Atif6894/automotive-ble-can-pcb/images/pcb_3d_iso.png

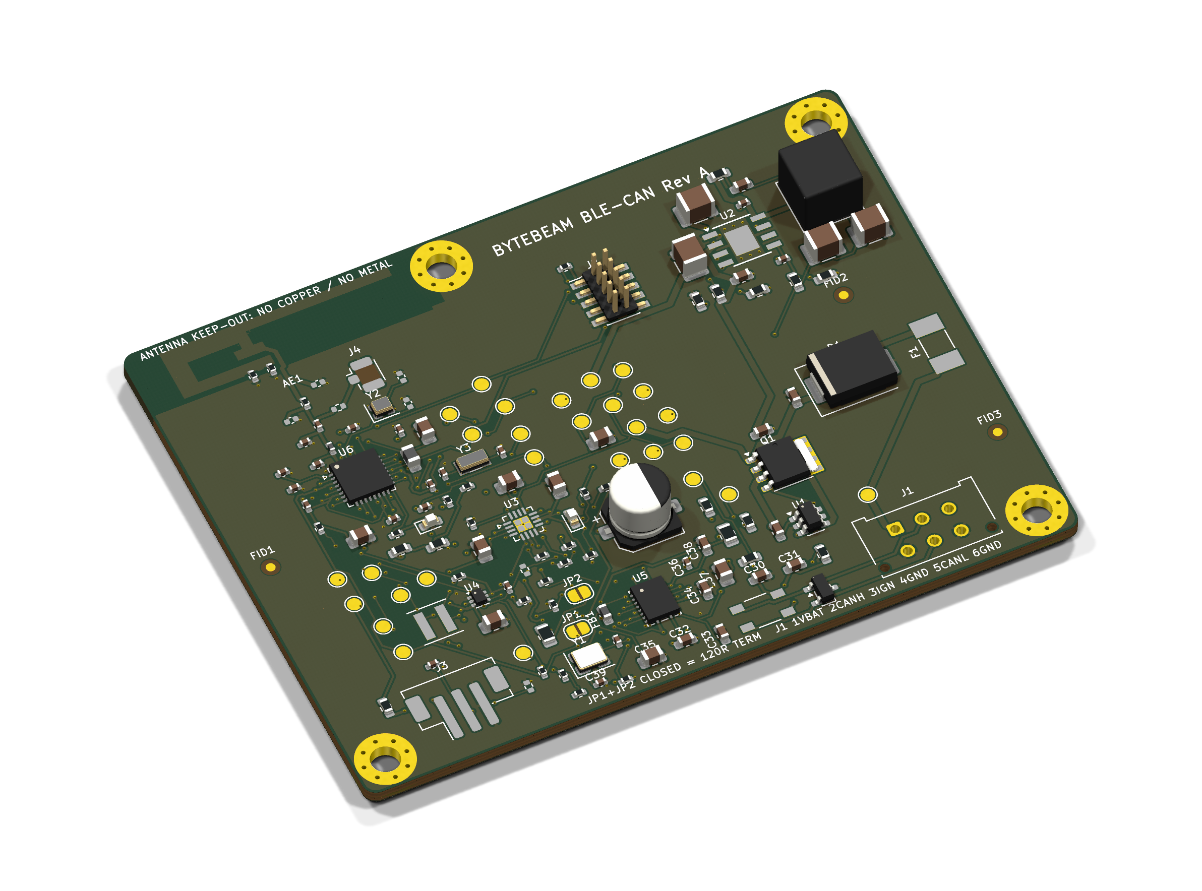
images/pcb_3d_iso.png
