Atif6894/automotive-ble-can-pcb/images/pcb_layout_all_layers.png

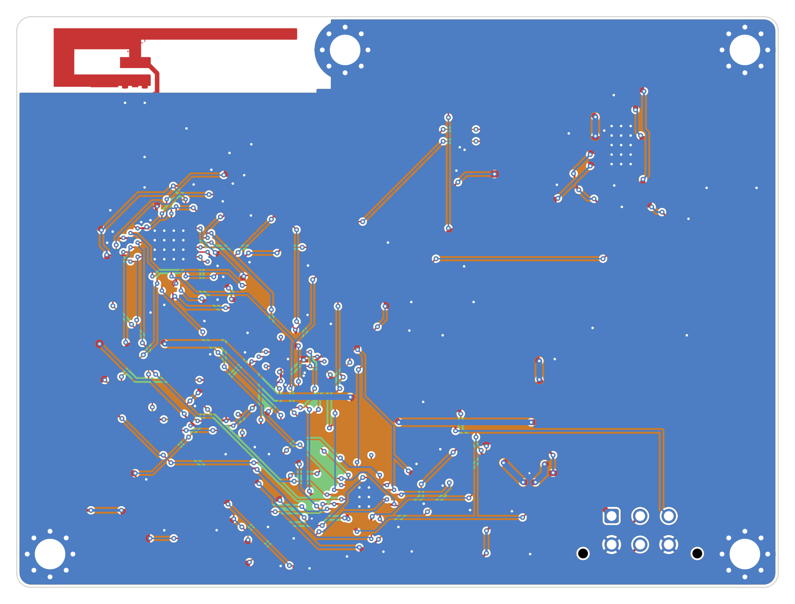
images/pcb_layout_all_layers.png
