Atif6894/automotive-ble-can-pcb/images/schematic_buck_6v0.png

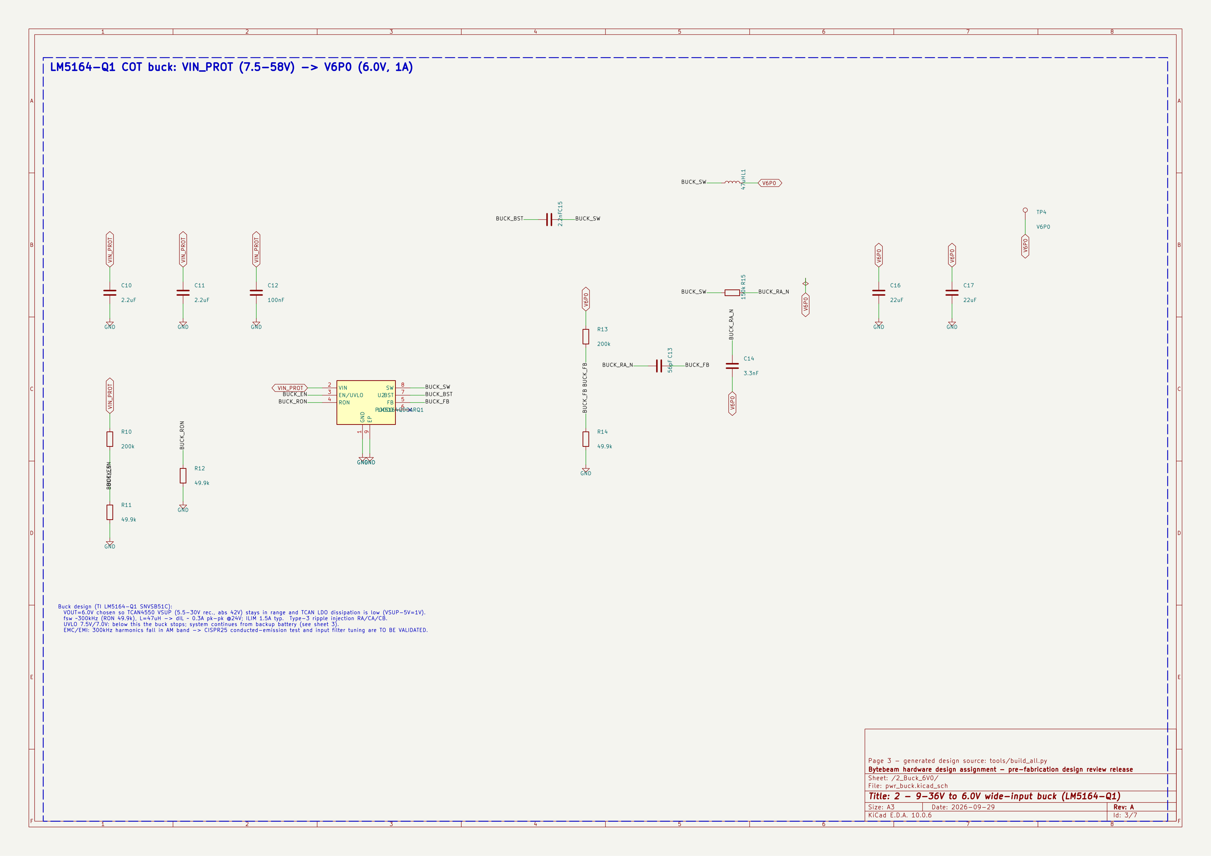
images/schematic_buck_6v0.png
