Atif6894/automotive-ble-can-pcb/images/schematic_power_input.png

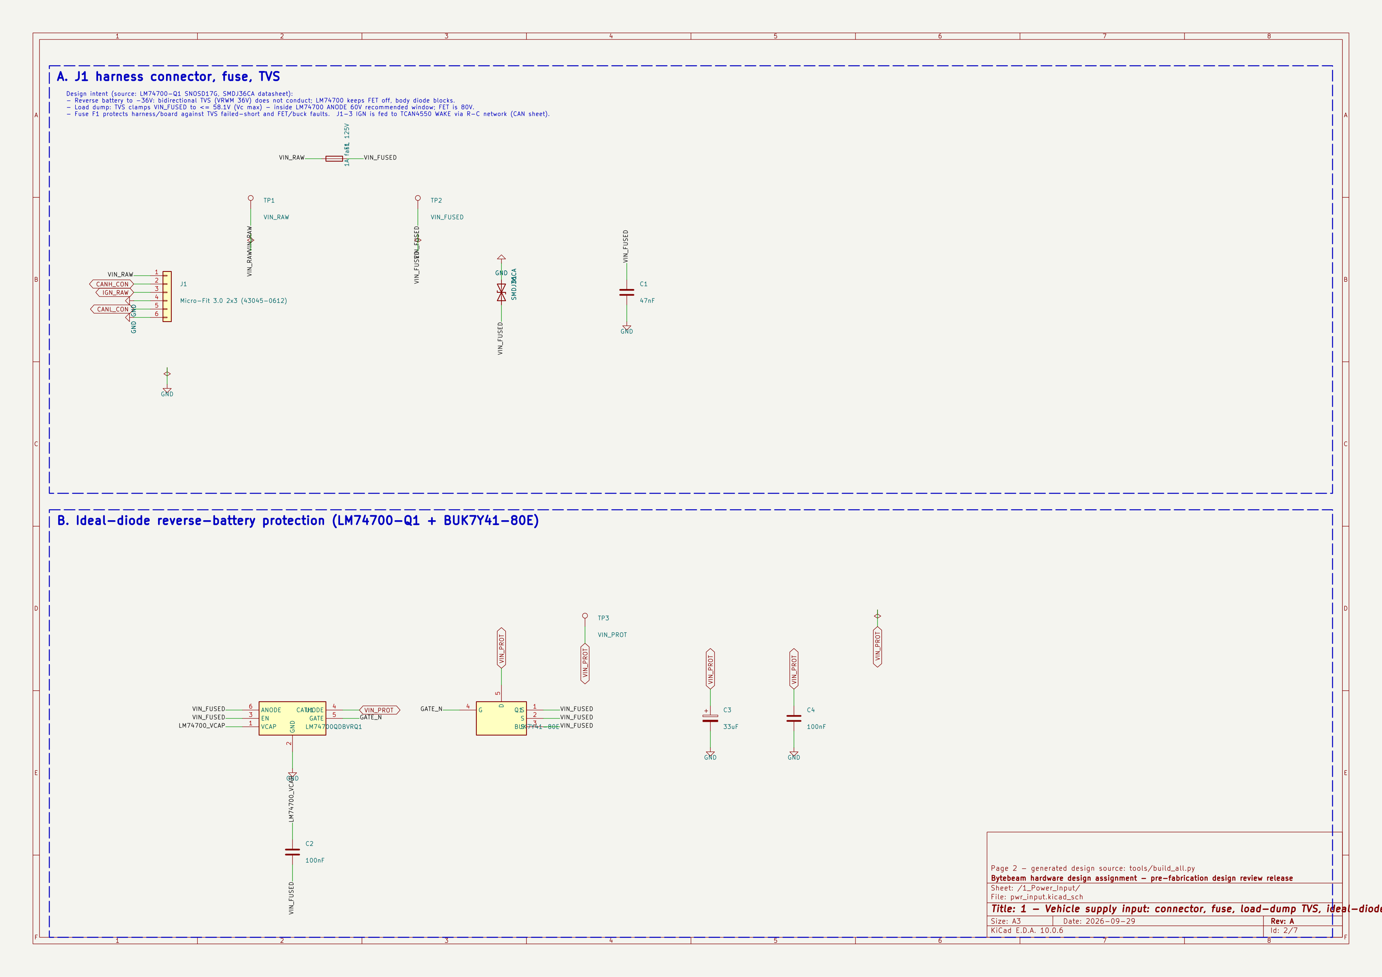
images/schematic_power_input.png
