Atif6894/automotive-ble-can-pcb/images/schematic_root_overview.png

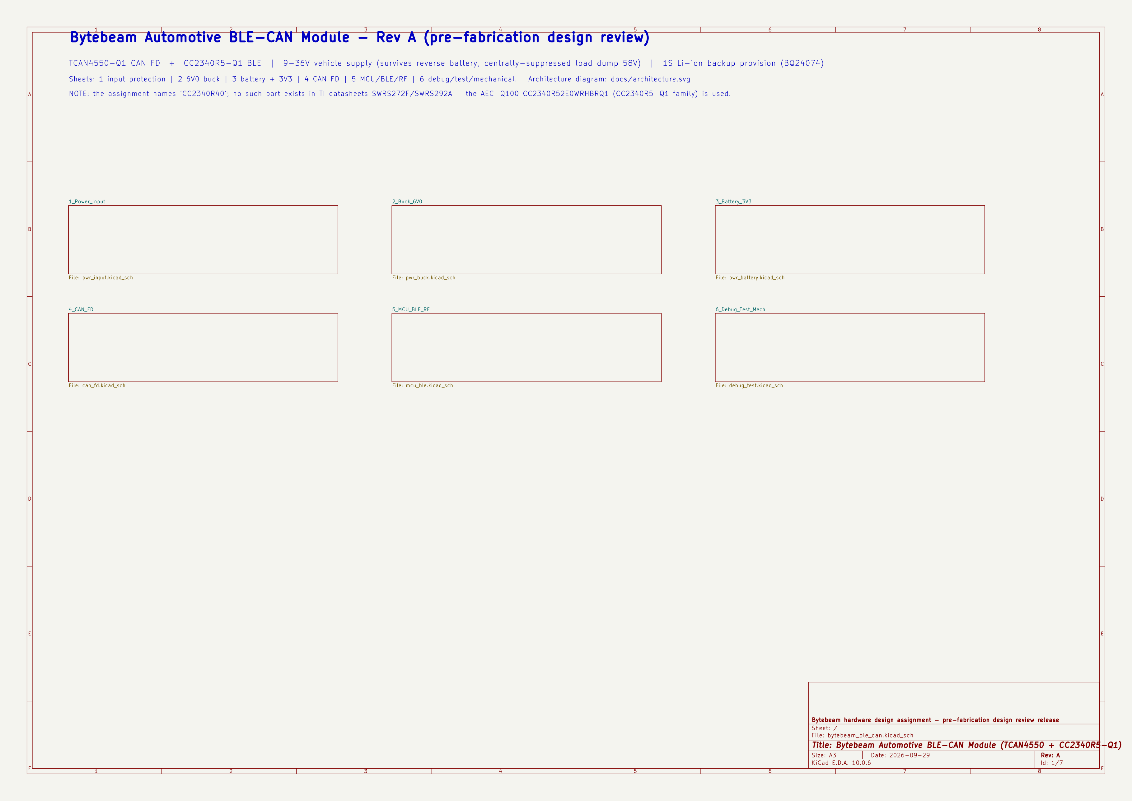
images/schematic_root_overview.png
