Atif6894/automotive-ble-can-pcb/documentation/DFMEA.csv

ID | Area | Item / function | Failure mode | Effect | Cause | S | O | D | RPN | Design mitigation (schematic / layout) | Detection / test | Residual risk & action before fab
F02 | Electrical | D1 TVS / VIN_FUSED | Input over-voltage: load dump above TVS clamp (unsuppressed 24 V systems 151-202 V) | TVS fails short -> fuse opens (safe) or FET/buck destroyed | Assumption 'centrally suppressed load dump 58 V' violated | 9 | 4 | 5 | 180 | TVS Vc 58.1 V @51.6 A inside LM74700 60 V rec./65 V abs window; FET 80 V; LM5164 100 V; fuse F1 clears TVS short | ISO 16750-2 load dump test A/B; TVS temperature rise | MEDIUM. Local TVS cannot absorb unsuppressed 24 V load dump; requires vehicle central suppressor or larger TVS (e.g. SM8S36A) - documented assumption
F19 | RF | AE1 IFA antenna | BLE range loss (detuning, wrong ground/feed geometry) | Reduced range/PER at edge of cell | Plastic housing / metal nearby, PCB stackup differs from TI 1 mm 2-layer ref | 6 | 6 | 5 | 180 | TI SWRU120D geometry copied; ground/copper keepout 31 x 8 mm on all layers; pi-match footprints (ANT1-3) and 2 shorting-tab links R67/R68; 50 ohm 0.35 mm feed | VNA S11 in enclosure, OTA range test, TRP/TIS | HIGH until measured: RF network values are TI reference starting points and topology is UNVERIFIED
F32 | Field | EMC | Conducted emission from 300 kHz buck (AM band) above CISPR 25 limits | EMC failure | Switching harmonics, input filtering minimal | 6 | 5 | 6 | 180 | Small hot loop, input caps at VIN pin, GND plane L2; footprint space for extra input filter (not populated) | CISPR 25 conducted/radiated | HIGH until tested: add LC/CM input filter if needed
F08 | Electrical | U3 BQ24074 / J3 | Battery leakage / deep discharge while vehicle off | Backup capacity lost; cell damage | Standby drain from 3V3 buck + MCU + TCAN in reset; no cut-off | 6 | 5 | 5 | 150 | Pack has PCM (UVLO); MCU can enter shutdown; TCAN held in RST; ITERM/TMR defaults | Measure sleep current on battery (target < 20 uA MCU + < 40 uA rails) | MEDIUM: quiescent budget unmeasured (calculated only). Consider battery disconnect FET
F20 | RF | RF LPF / harmonics | Spurious emissions / harmonic (3rd) above limit | Regulatory failure (ETSI/FCC) | Filter values or layout deviate from reference; no RF shield | 6 | 4 | 6 | 144 | LPF footprint, keep-out around RF, solid GND on L2; option to add shield footprint (not implemented) | Conducted + radiated test at accredited lab | MEDIUM: no compliance claimed. Shield footprint not provided
F31 | Field | Antenna / enclosure | Metal or battery close to IFA (enclosure) detunes antenna | Range loss | Enclosure assumptions violated (needs >5 mm clearance, plastic) | 5 | 5 | 5 | 125 | Enclosure assumption documented in README; battery mounted away from antenna region | OTA test in final enclosure | Medium
F06 | Thermal | U2 LM5164-Q1 | Regulator thermal stress at 36-58 V / 125 C ambient | Thermal shutdown, reduced life | Ploss ~0.25 W (est.), RthJA 43 C/W + copper | 6 | 4 | 5 | 120 | Thermal pad with 4-via array to GND planes, load << 1 A rating; Tj limit 150 C | IR camera / thermocouple at 85 C, 36 V, full load; TJ calc in POWER_BUDGET | Medium: thermal performance calculated only (not simulated/measured)
F09 | Electrical | U3 BQ24074 charging | Improper charging outside temperature window / wrong chemistry | Cell venting, fire | NTC missing/wrong pack; LiFePO4 pack fitted; hot cabin >45 C | 10 | 3 | 4 | 120 | TS pin monitors pack NTC (10k 103AT-2); charge current limited 100 mA; safety timers on; keyed JST PH; R28 (10k) DNP unless no-NTC pack | Bench: cold/hot chamber with pack simulator, TS thresholds | MEDIUM: pack chemistry restricted to 1S Li-ion 4.2 V; charging must not be used <0 C or >45 C without validation
F13 | CAN | CAN bus open / termination | Open bus, missing or double termination | Signal reflections, CAN FD errors at 5 Mbps | Node used as bus tap but JP1/JP2 closed (or end-node open) | 6 | 5 | 4 | 120 | Termination optional by solder jumpers JP1/JP2 (default open); split termination for CM noise; stub length < 30 cm assumed | Bus impedance measurement 60 R, eye diagram | Medium: documented default 'tap node' - user must set jumpers per installation
F05 | Electrical | U2 LM5164-Q1 buck | Input under-voltage during crank (<7 V) -> converter stops | V6P0 collapses; CAN goes off, MCU continues on battery | 12 V crank down to 3-6 V (ISO 16750-2 starting profile) | 5 | 7 | 3 | 105 | EN/UVLO 7.5/7.0 V by R10/R11; BQ24074 seamless OUT switch to battery; bulk 33 uF | Starting profile test, log CAN bus-off events | Accepted behaviour; firmware must handle CAN re-init after brown-out
F26 | Mechanical | PCB / assembly | Solder-joint fatigue (thermal cycling -40..85 C, vibration) | Intermittent failures | Large 1210 MLCCs and SMC TVS, CTE mismatch | 7 | 3 | 5 | 105 | Standard 1.6 mm FR-4; MLCC orientation/fillets; consider flexible-termination caps | Thermal-cycling and vibration test (ISO 16750-3/4) | Medium: not tested
F33 | Field | Firmware | CAN traffic overload / watchdog | Missed frames | SPI latency vs BLE stack | 5 | 4 | 5 | 100 | TCAN M_CAN FIFO + nINT; RST/GPO watchdog options | Load test | Low
F03 | Electrical | F1 fuse | Fuse nuisance-opens at cold crank / TVS conduction, or fails to protect | Loss of function / no protection | I2t mismatch vs 58 V TVS surge; 125 V rating OK | 6 | 4 | 4 | 96 | 1 A very-fast NANO2 with 300 mA typ load (<25% derating at 85C); footprint allows 2 A option | Inrush/surge test | Medium: fuse selection non-AEC-Q200 in BOM; confirm AEC-Q200 fuse family
F10 | Electrical | J3 battery connector | Wrong battery insertion (reversed / wrong pack voltage) | Reverse voltage on BAT pin -> charger damage | Non-keyed alternative connector used | 8 | 3 | 4 | 96 | Keyed JST PH pins 1/2/3 (BAT+/NTC/GND) fixed pinout | Assembly/inspection instruction | Medium: no reverse-protection FET on BAT (cost/space) - add if pack polarity cannot be guaranteed
F12 | CAN | J1 CAN bus pins | CAN bus short to battery / ground / other line | Transceiver damage or bus-off | Harness fault | 8 | 4 | 3 | 96 | TCAN4550 bus pins +/-58 V rated with fault protection; PESD2CAN + ACT45B at connector; series link R40/R41 | Short-circuit test per ISO 11898-2 / ISO 16750-2 | Low-Medium; transient tests to be performed
F14 | CAN | ESD/EMC | ESD damage / immunity failure at connector (8 kV contact, 15 kV air) | Bus transceiver latch-up / error bursts | Discharge to shield/CAN pins | 8 | 3 | 4 | 96 | TCAN HBM 15 kV bus pins; external PESD2CAN (30 kV) first at connector, CMC second; ground pour and short return | IEC 61000-4-2 / ISO 10605 test | Low-Medium; not yet tested
F27 | Manufacturing | QFN/SOT/0402 assembly | Poor solderability / tombstoning / voiding under thermal pads | Open joints, poor thermal path | 0402 with unequal pads, EP paste coverage | 6 | 4 | 4 | 96 | Stock IPC footprints; EP via array (0.3 mm) should be plugged/tented; fiducials FID1-3 | AOI + X-ray on U2/U5/U6 | Medium: via-in-pad plugging to be specified to assembler
F17 | CAN | nWKRQ default 3.6 V push-pull | Over-voltage on MCU DIO19 (VDDS+0.3 V max) | MCU pin stress | TCAN nWKRQ defaults to internal 3.6 V rail | 5 | 6 | 3 | 90 | R48 1 k series resistor; firmware sets 16'h0800[19]=1 to VIO domain at boot | Measure nWKRQ level after reset | Low; firmware dependency documented
F25 | Mechanical | J1 connector | Wrong connector insertion / mis-mating / vibration fretting | Shorted harness or open circuit | Non-keyed mate, cable strain | 7 | 3 | 4 | 84 | Micro-Fit polarised housing; pin pairing keeps VBAT/GND adjacent; mounting holes near connector | Insertion test, vibration | Medium: automotive-grade connector (MX150/MQS) recommended for production
F01 | Electrical | J1 VBAT input | Reverse battery connection (12 V system: -14 V, jump-start swap; 24 V: -28 V) | Reverse current destroys regulators / harness fire | Harness miswire, jump-start error | 9 | 3 | 3 | 81 | SMDJ36CA bidirectional TVS does not conduct to -36 V; LM74700-Q1 keeps BUK7Y41-80E off (body diode blocks); fuse F1 upstream | Bench: apply -36 V current-limited, verify <1 mA reverse | Low. Validate ISO 7637 pulse 1 and reverse-battery test (ISO 16750-2 4.7) - NOT yet performed
F11 | Electrical | U4 TPS62A01-Q1 | 3V3 rail droops / regulator drop-out at low battery | MCU brown-out reset; TCAN VIO below 3.135 V | Battery <3.4 V (100% mode) | 4 | 5 | 4 | 80 | TCAN kept in reset when VBATSYS<3.4 V (firmware), VDDS range 1.71-3.8 V | Discharge ramp test | Low
F16 | CAN | SPI link MCU-TCAN | SPI signal-integrity errors (8 MHz+, ringing) | SPIERR flags, lost CAN frames | Long/unmatched routing, no series R | 5 | 4 | 4 | 80 | Short routes, common 3.3 V domain (no level shifter), spare series-R option (0R footprints not fitted) | SPI loopback test, error counters | Low
F15 | CAN | U5 40 MHz clock (Y1) | Crystal fails to start / wrong load capacitance | No CAN clock; SPI ok but no bus activity | CL/ESR mismatch; R52 series value assumed | 6 | 4 | 3 | 72 | ESR <=60 R crystal spec; 12 pF C0G load caps and 100 R series R52 footprints tunable; clock tolerance 0.5 % allowed by TCAN | Read TCAN DEVICE ID + CLK status register at bring-up, scope OSC | Medium: values ASSUMED (TI 'TCAN455x clock guideline' not obtained)
F04 | Electrical | U1/Q1 ideal diode | Gate over-voltage or FET failed short (no reverse block) | Reverse polarity not blocked | LM74700 GATE-ANODE >15 V, FET VGS rating | 8 | 2 | 4 | 64 | Standard-level FET (VGS +/-20 V) chosen over logic-level (VGS 10 V) - BUK7Y41-80E; VCAP cap per datasheet | Reverse-battery test, gate waveform | Low
F21 | RF | U6 48 MHz crystal (Y2) | HFXT start-up failure / frequency error | No radio operation / BLE PER | Wrong package footprint (2016 assumed), load cap array | 7 | 3 | 3 | 63 | Tai-Saw TZ3908AAAO43 validated by TI, internal cap array, DNP C59/C60 for tuning | HFXT frequency measurement via DIO19 clock-out (SWRA834A 6.4) | Medium: crystal package dimension to confirm with vendor drawing
F24 | Digital | U6 boot/firmware | Firmware/bootloader locks debug or wrong SPI mux | Cannot access TCAN | SPI0 mux (SCLK m1, CSN m1, POCI m1, PICO m2) misconfigured | 5 | 4 | 3 | 60 | Pin mux table on schematic notes; ROM bootloader UART pins intentionally unused (SWD is the programming path) | Bring-up SPI ID read | Low
F28 | Manufacturing | TVS/big parts | Tombstone / misplacement due to oversize footprints (SMC, XGL6060) | Assembly reject | Land pattern mismatch (XGL6060 uses XAL6060 footprint) | 5 | 4 | 3 | 60 | Vendor land patterns to be verified before release | First-article inspection | Low-Medium
F07 | Electrical | L1 47 uH | Inductor saturation at cold/hot or current-limit event | Peak current -> converter fault / EMI | Isat 2.5 A (20% drop) vs ILIM 1.75 A max | 6 | 2 | 4 | 48 | XGL6060-473MEC AEC-Q200, Isat margin >40% vs IPEAK max | Scope inductor current at ILIM | Low; land pattern shared with XAL6060 must be verified
F29 | Manufacturing | Test coverage | Insufficient test points for bring-up / production test | Cannot isolate faults | Dense layout | 4 | 4 | 3 | 48 | 28 TPs on rails, CAN, SPI, RST, SWD; two PCB antenna test links | ICT/flying probe | Low
F22 | RF | U6 32 kHz crystal (Y3) | LFXT failure | BLE connection timing drift / disconnects | Load caps / parasitics | 4 | 3 | 3 | 36 | 15 pF + 15 pF per TI reference; RCOSC fallback in firmware | Output 32 kHz to DIO (SWRA834A 6.3) | Low
F23 | Digital | U6 debug/bring-up | SWD access blocked (pin reuse, RSTN pull-up), or bricked device | Cannot program | DIO16/17 are SWD by default; CCFG misconfig | 6 | 3 | 2 | 36 | J2 Cortex-Debug 10-pin, dedicated SWDIO/SWDCK, RSTN pulled up 100 k, test pads TP15-TP19 | Bring-up step 3 | Low
F30 | Thermal | U5 TCAN4550 | Thermal shutdown with VCCOUT loaded (TCAN datasheet Fig 9-8) | CAN transceiver off | High VSUP with 70 mA load at 125 C | 6 | 2 | 3 | 36 | VSUP fed from 6.0 V (1 V LDO drop), VCCOUT unloaded (10 uF only) | Thermal test | Low
F18 | CAN | TCAN RST active-high | MCU leaves RST floating/high at boot -> TCAN held in reset | No CAN after power-up | Confusing polarity (active-HIGH pulse) | 4 | 4 | 2 | 32 | R47 100 k pull-down + MCU-controlled DIO18; polarity noted on schematic | Bring-up checklist | Low
