Atif6894/automotive-ble-can-pcb/manufacturing/assembly_outputs/bytebeam.step

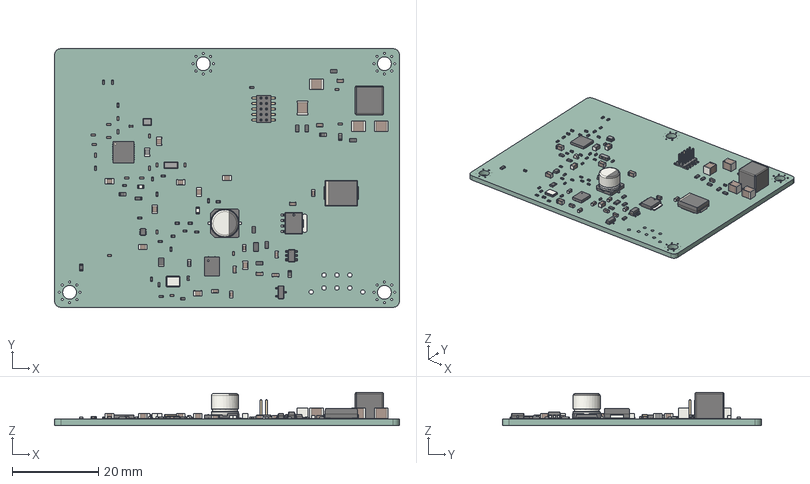
[picture p18: CAD file, 2026-10-08]
manufacturing/assembly_outputs/bytebeam.step
80.0 x 60.0 x 7.70 mm
C_0603_1608Metric x 11
R_0402_1005Metric x 23
CP_Elec_63x58
43e594cd-ed20-11ed-b06b-f76ff2fea4fd_part
43e594ce-ed20-11ed-b06b-f76ff2fea4fd_part
43e594cf-ed20-11ed-b06b-f76ff2fea4fd_part
C_0402_1005Metric x 20
C_0805_2012Metric x 9
R_0603_1608Metric x 13
Crystal_SMD_3215-2Pin_3.2x1.5mm
R_0805_2012Metric x 2
SOT-23
SOT-23-6
L_0603_1608Metric
LED_0603_1608Metric x 2
L_Coilcraft_XAL6060-XXX
D_SMC
Crystal_SMD_2016-4Pin_2.0x1.6mm
PinHeader_2x05_P127mm_Vertical_SMD
SOT_563
L_0402_1005Metric
C_1210_3225Metric x 4
adbeea53-9c39-11ed-93f0-dde97e994e83_part
adbeea54-9c39-11ed-93f0-dde97e994e83_part
adbeea55-9c39-11ed-93f0-dde97e994e83_part
L_0805_2012Metric
Crystal_SMD_3225-4Pin_3.2x2.5mm
QFN-32-1EP_5x5mm_P0.5mm_EP3.7x3.7mm
bytebeam_ble_can_PCB
