Atif6894/automotive-ble-can-pcb/documentation/architecture.pdf

# Bytebeam Automotive BLE-CAN Module - Architecture (Rev A, pre-fabrication review)

## J1 harness

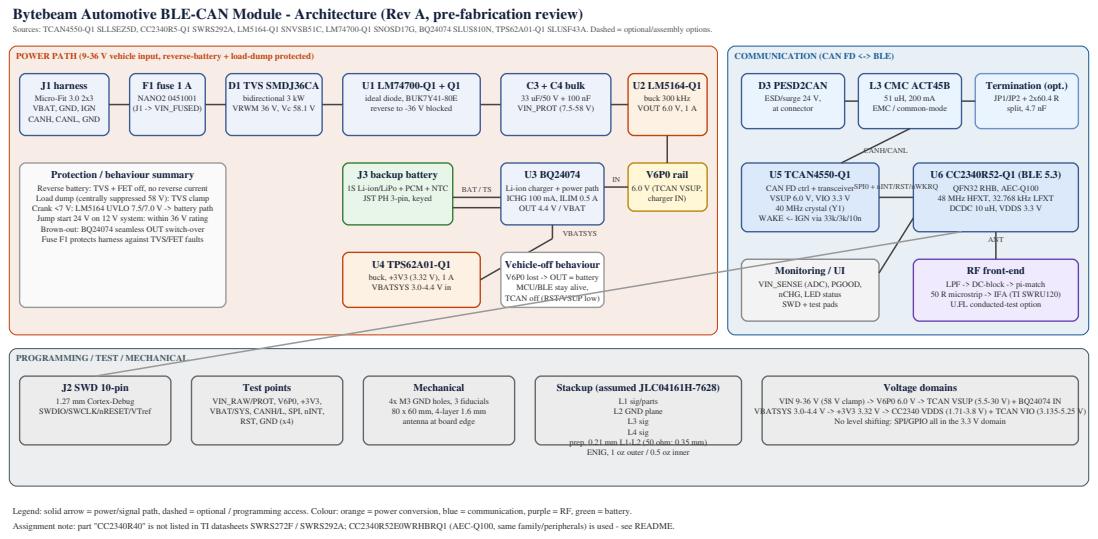
[picture p19: page 1]

Sources: TCAN4550-Q1 SLLSEZ5D, CC2340R5-Q1 SWRS292A, LM5164-Q1 SNVSB51C, LM74700-Q1 SNOSD17G, BQ24074 SLUS810N, TPS62A01-Q1 SLUSF43A. Dashed = optional/assembly options.

POWER PATH (9-36 V vehicle input, reverse-battery + load-dump protected)

COMMUNICATION (CAN FD <-> BLE)

Protection / behaviour summary
Reverse battery: TVS + FET off, no reverse current
Load dump (centrally suppressed 58 V): TVS clamp
Crank <7 V: LM5164 UVLO 7.5/7.0 V -> battery path
Jump start 24 V on 12 V system: within 36 V rating
Brown-out: BQ24074 seamless OUT switch-over
Fuse F1 protects harness against TVS/FET faults

IN J3 backup battery
1S Li-ion/LiPo + PCM + NTC
JST PH 3-pin, keyed

Li-ion charger + power path
ICHG 100 mA, ILIM 0.5 A
OUT 4.4 V / VBAT

U5 TCAN4550-Q1
CAN FD ctrl + transceiver
VSUP 6.0 V, VIO 3.3 V
40 MHz crystal (Y1)
WAKE <- IGN via 33k/3k/10n

U6 CC2340R52-Q1 (BLE 5.3)
QFN32 RHB, AEC-Q100
48 MHz HFXT, 32.768 kHz LFXT
DCDC 10 uH, VDDS 3.3 V

Vehicle-off behaviour
V6P0 lost -> OUT = battery
MCU/BLE stay alive,
TCAN off (RST/VSUP low)

RF front-end
LPF -> DC-block -> pi-match
50 R microstrip -> IFA (TI SWRU120)
U.FL conducted-test option

J2 SWD 10-pin
1.27 mm Cortex-Debug
SWDIO/SWCLK/nRESET/VTref

Test points
VIN_RAW/PROT, V6P0, +3V3,
VBAT/SYS, CANH/L, SPI, nINT,
RST, GND (x4)

Mechanical
4x M3 GND holes, 3 fiducials
80 x 60 mm, 4-layer 1.6 mm
antenna at board edge

VIN 9-36 V (58 V clamp) -> V6P0 6.0 V -> TCAN VSUP (5.5-30 V) + BQ24074 IN
VBATSYS 3.0-4.4 V -> +3V3 3.32 V -> CC2340 VDDS (1.71-3.8 V) + TCAN VIO (3.135-5.25 V)

No level shifting: SPI/GPIO all in the 3.3 V domain

prep. 0.21 mm L1-L2 (50 ohm: 0.35 mm)
ENIG, 1 oz outer / 0.5 oz inner

Legend: solid arrow = power/signal path, dashed = optional / programming access. Colour: orange = power conversion, blue = communication, purple = RF, green = battery.
Assignment note: part "CC2340R40" is not listed in TI datasheets SWRS272F / SWRS292A; CC2340R52E0WRHBRQ1 (AEC-Q100, same family/peripherals) is used - see README.
