Atif6894/automotive-ble-can-pcb/schematic/schematic.pdf

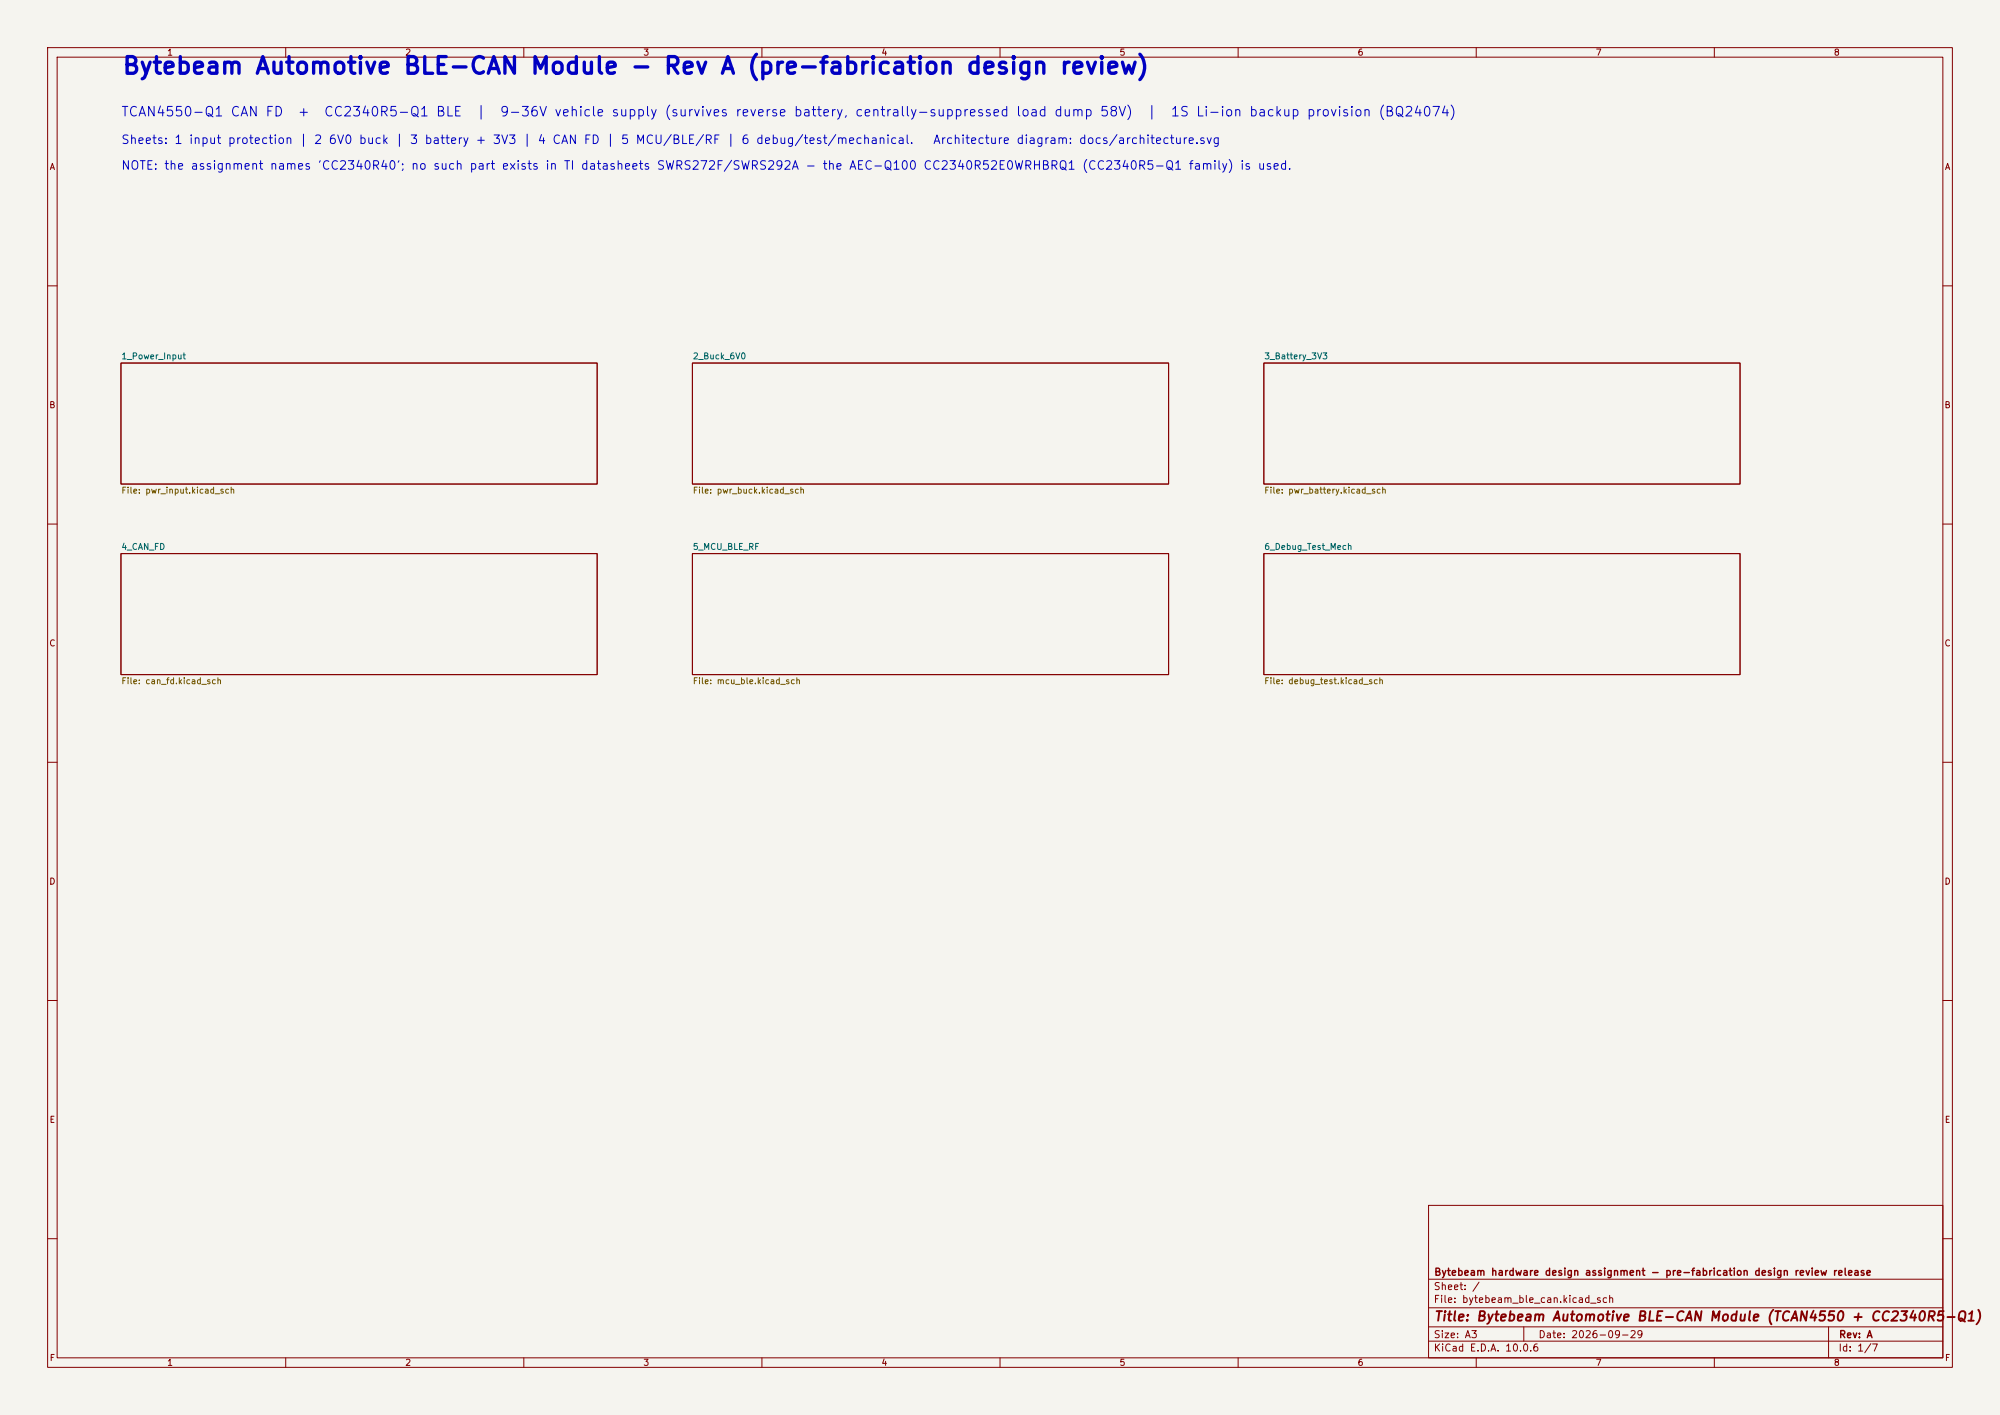
[picture p20: page 1]

File: can_fd.kicad_sch Bytebeam Automotive BLE-CAN Module - Rev A (pre-fabrication design review)

TCAN4550-Q1 CAN FD + CC2340R5-Q1 BLE | 9-36V vehicle supply (survives reverse battery, centrally-suppressed load dump 58V) | 1S Li-ion backup provision (BQ24074)

NOTE: the assignment names 'CC2340R40'; no such part exists in TI datasheets SWRS272F/SWRS292A - the AEC-Q100 CC2340R52E0WRHBRQ1 (CC2340R5-Q1 family) is used.

Bytebeam hardware design assignment - pre-fabrication design review release
Sheet: /
File: bytebeam_ble_can.kicad_sch
Title: Bytebeam Automotive BLE-CAN Module (TCAN4550 + CC2340R5-Q1)

Size: A3 | Rev: A | F Date: 2026-09-29
KiCad E.D.A. 10.0.6 | Id: 1/7

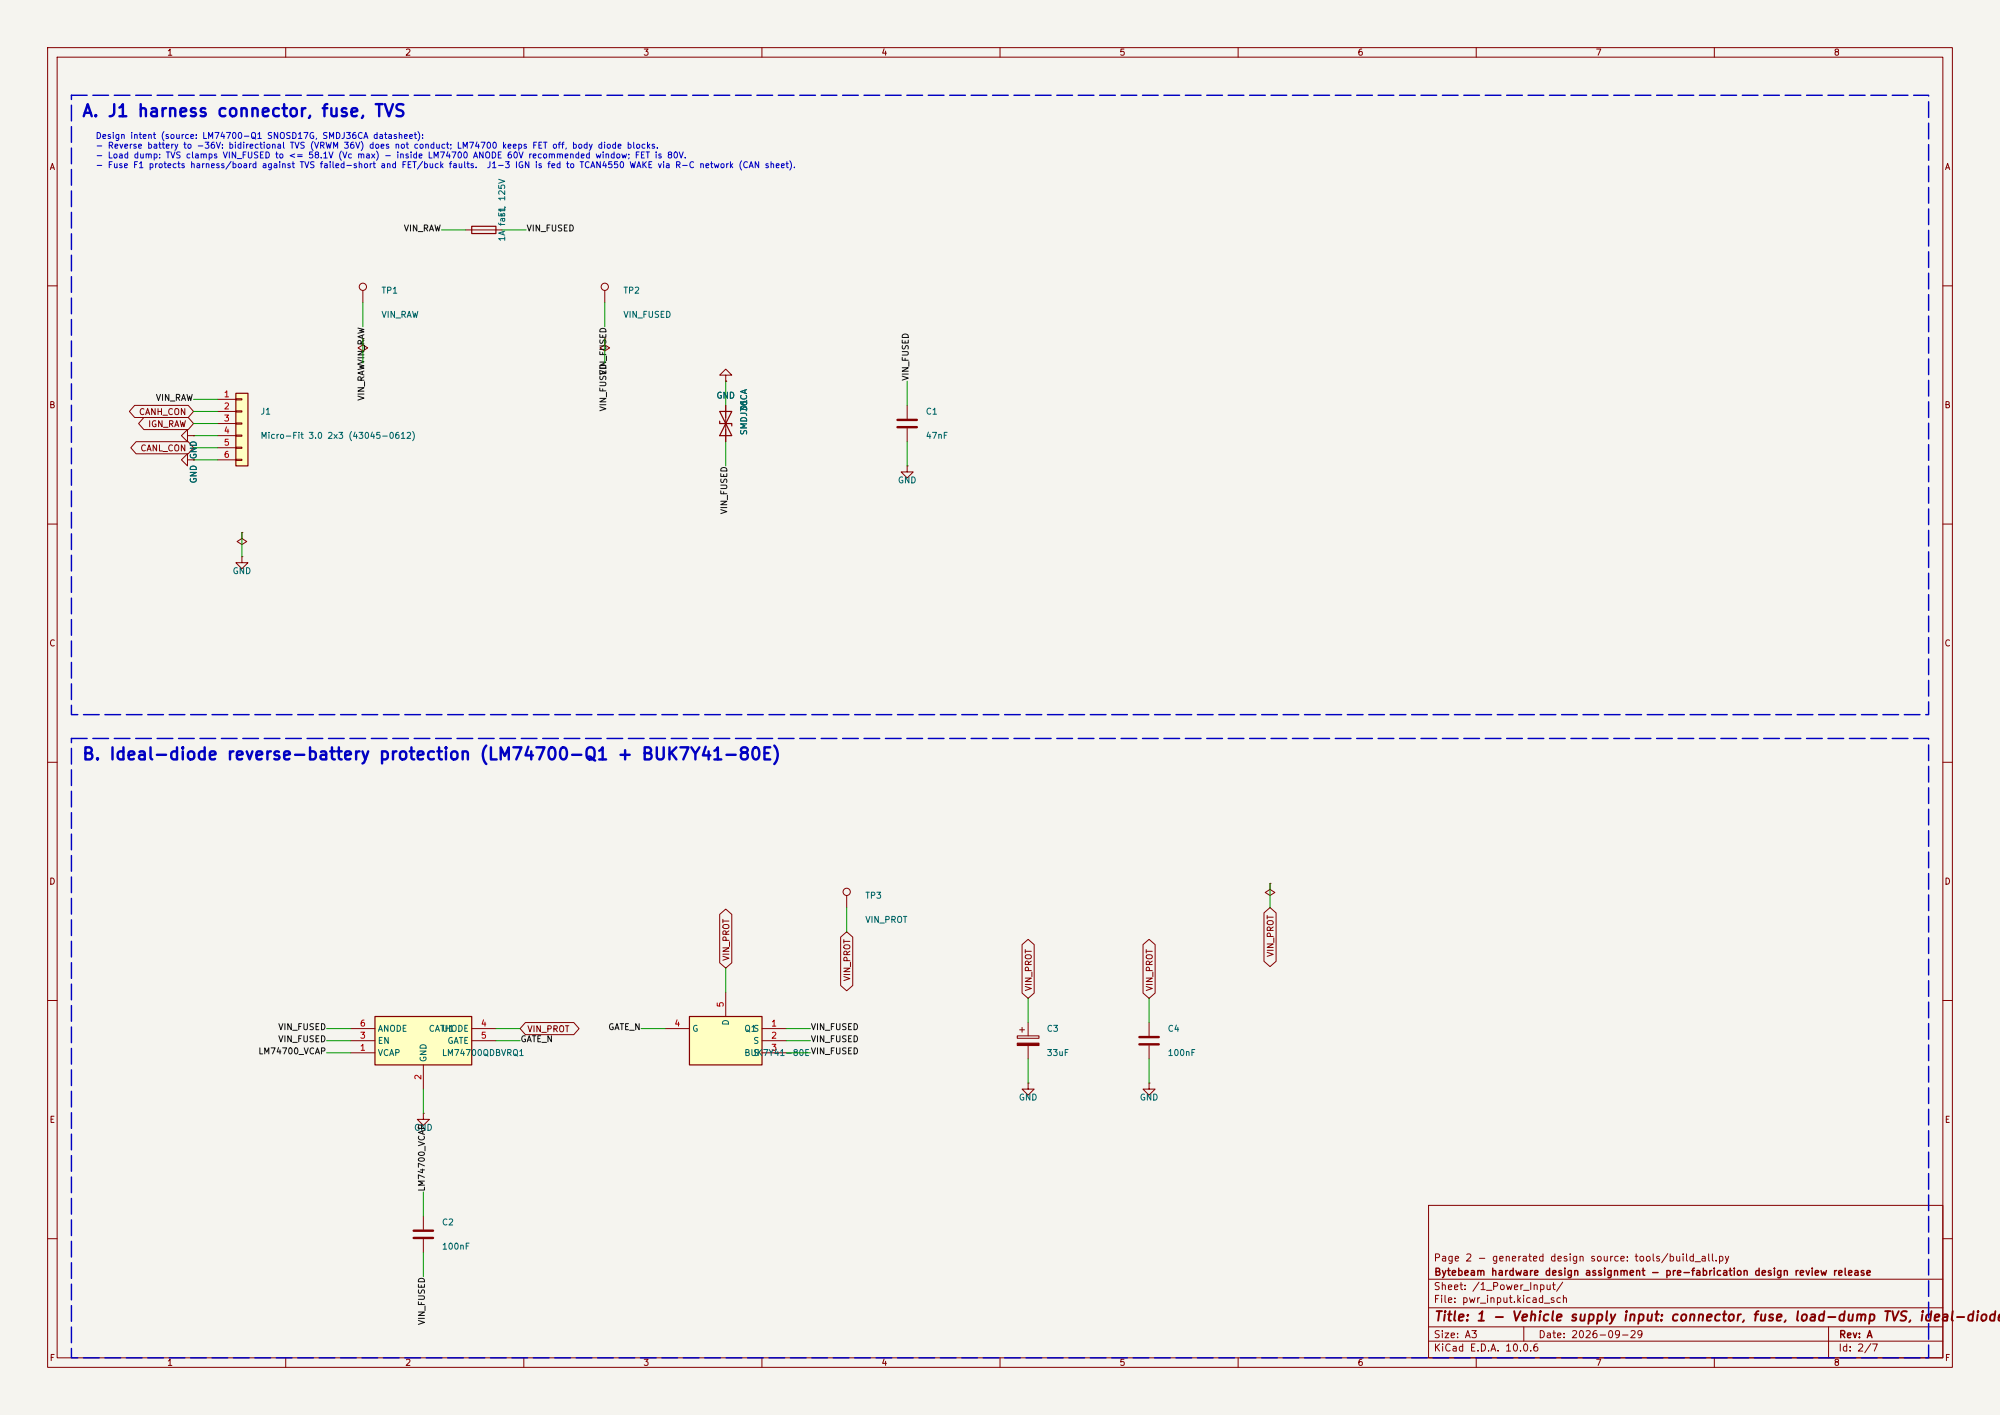
[picture p21: page 2]

A. J1 harness connector, fuse, TVS
VIN_FUSED
GND

Page 2 - generated design source: tools/build_all.py Bytebeam hardware design assignment - pre-fabrication design review release

Sheet: /1_Power_Input/ File: pwr_input.kicad_sch

Title: 1 - Vehicle supply input: connector, fuse, load-dump TVS, ideal-diode reverse-battery protection

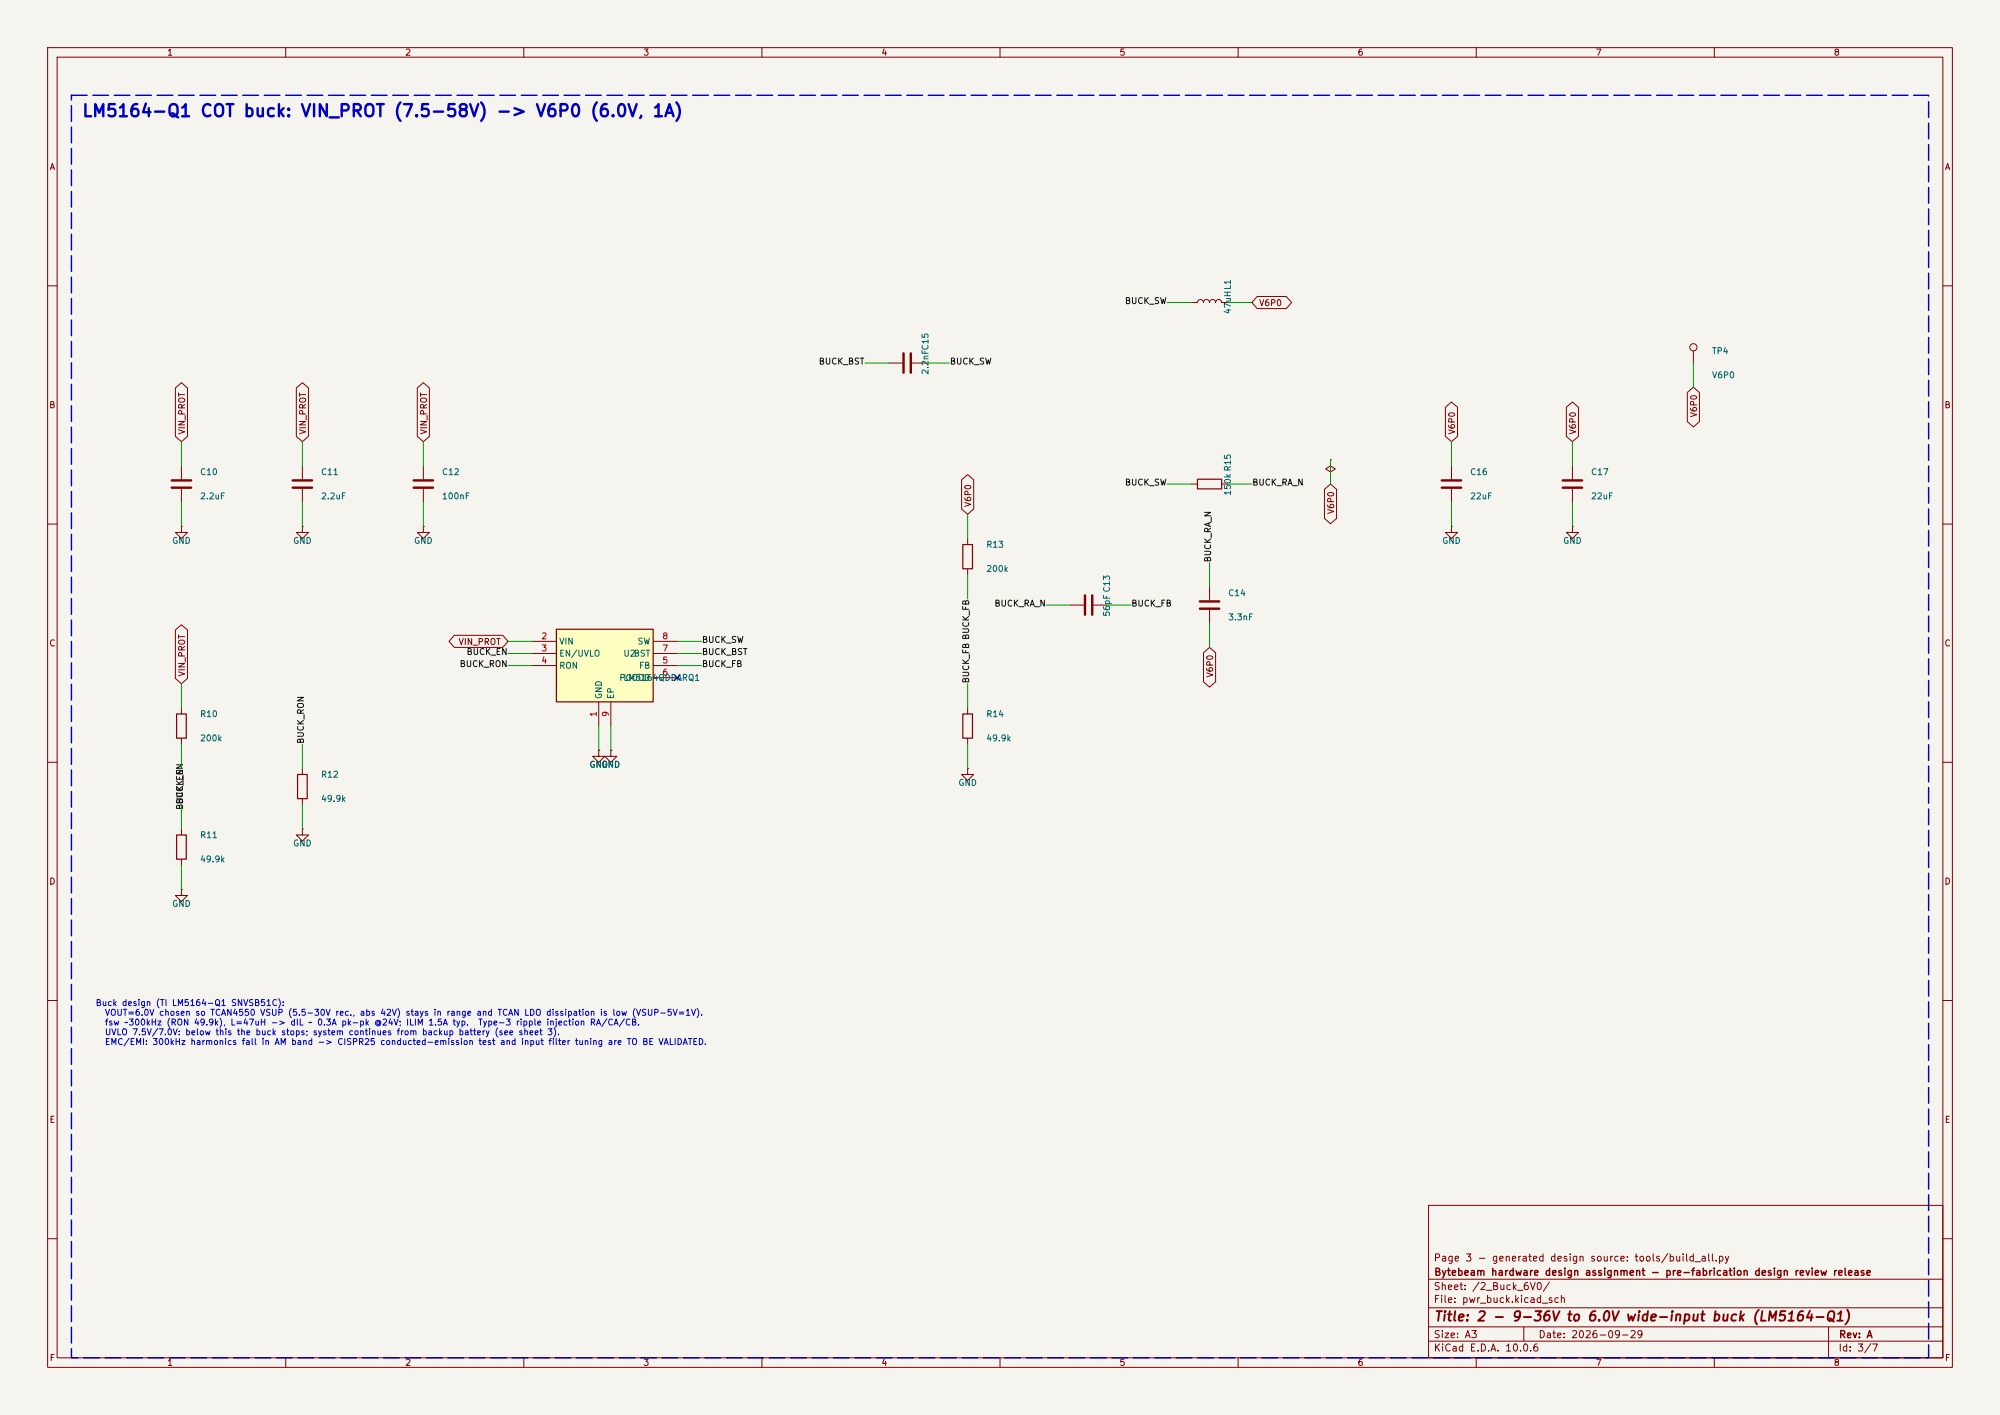
[picture p22: page 3]

EMC/EMI: 300kHz harmonics fall in AM band -> CISPR25 conducted-emission test and input filter tuning are TO BE VALIDATED. GNDGND

Page 3 - generated design source: tools/build_all.py
Bytebeam hardware design assignment - pre-fabrication design review release
Sheet: /2_Buck_6V0/
File: pwr_buck.kicad_sch
Title: 2 - 9-36V to 6.0V wide-input buck (LM5164-Q1)

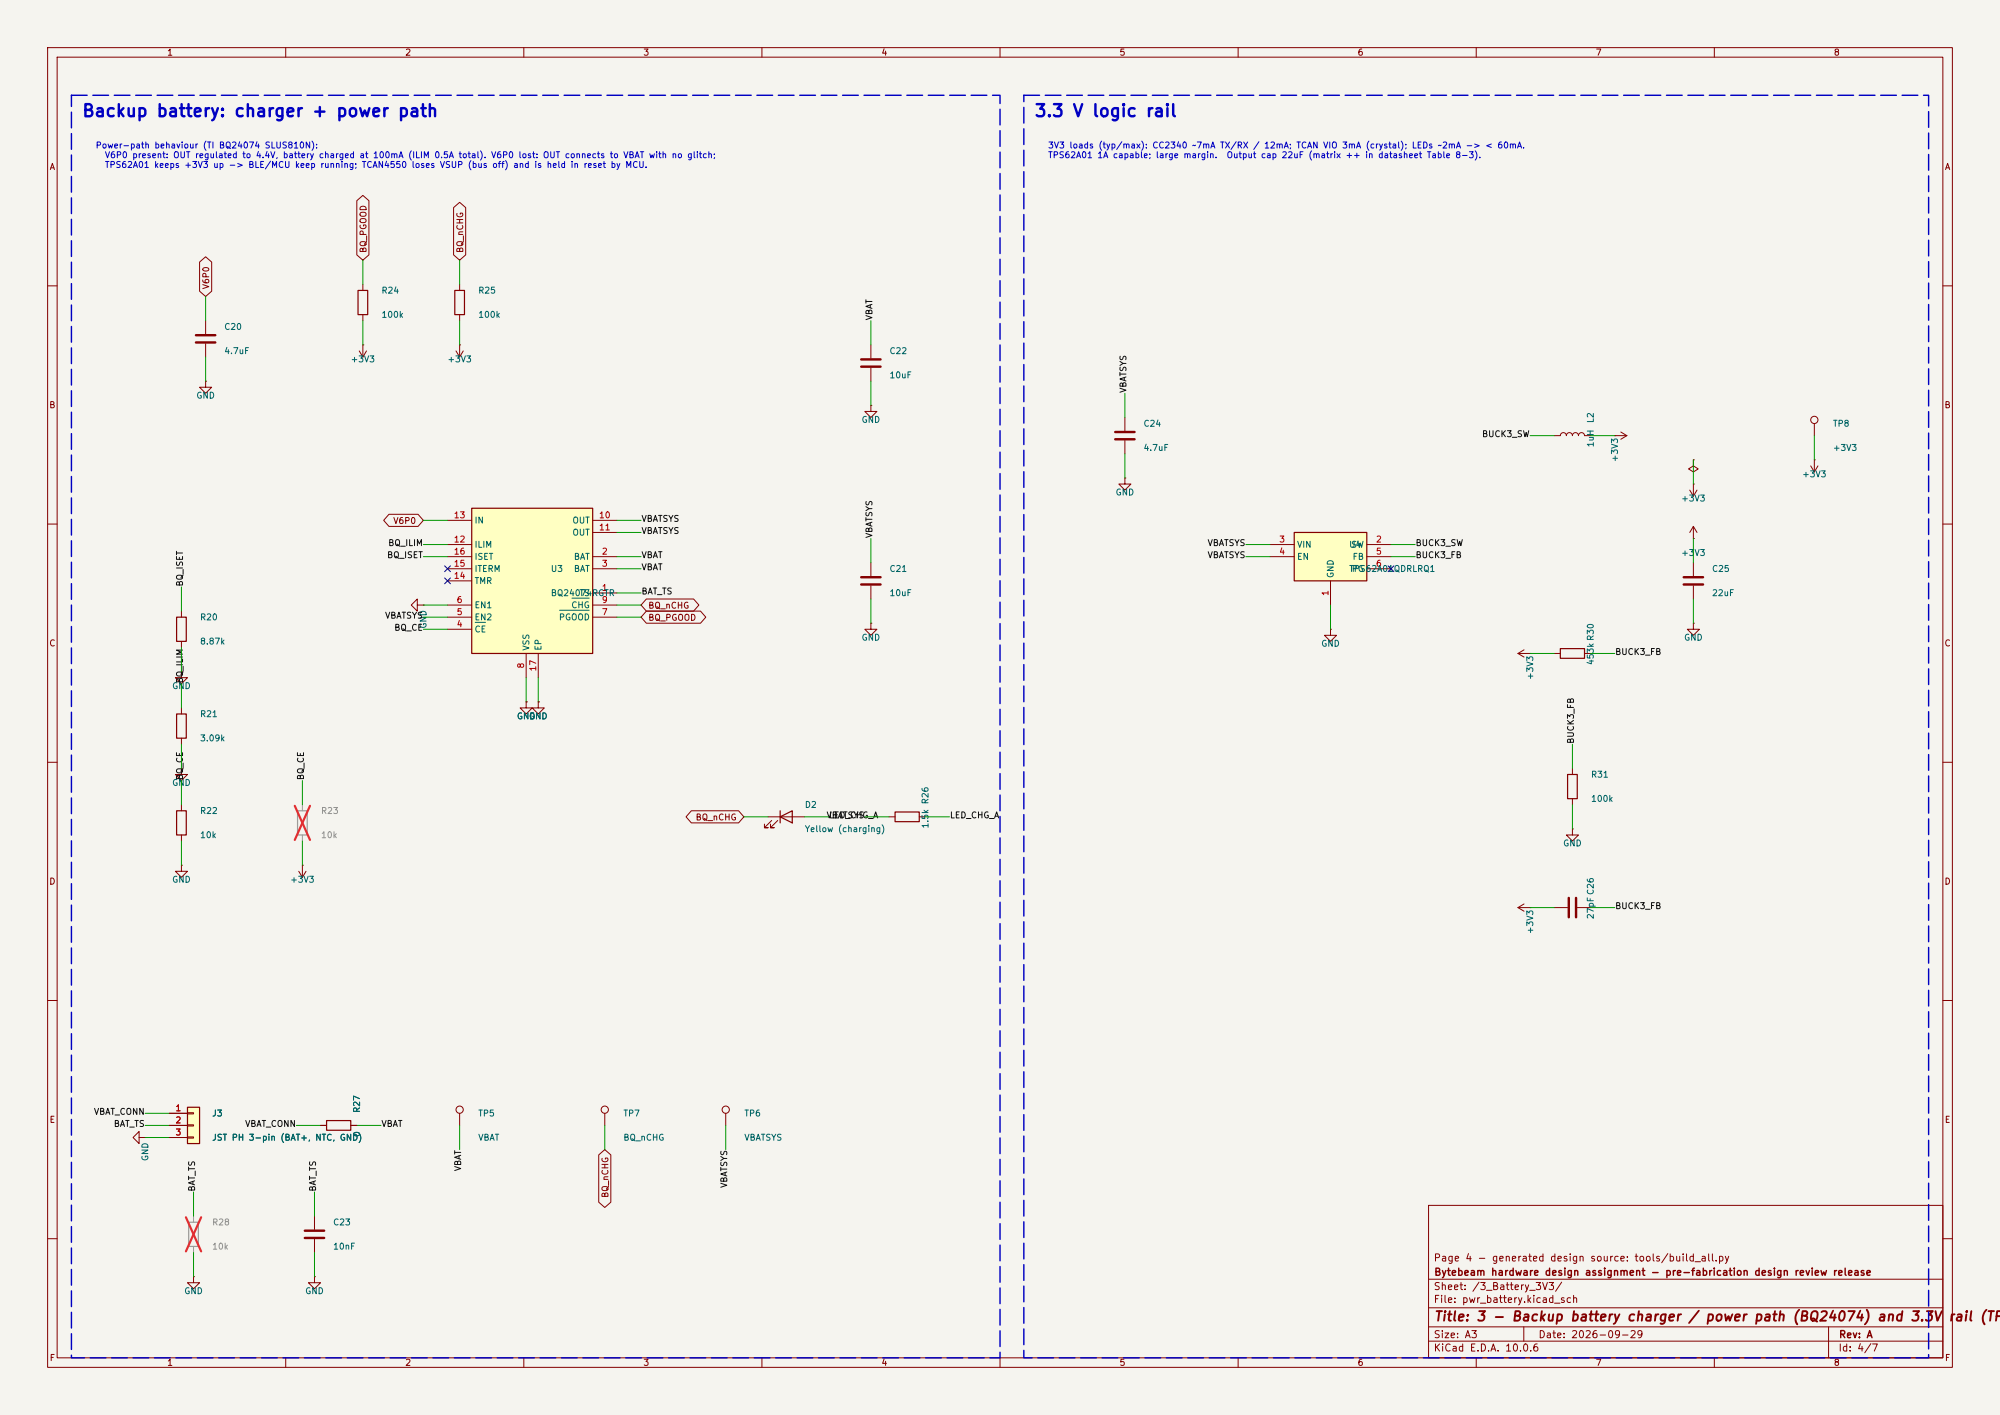
[picture p23: page 4]

JST PH 3-pin (BAT+, NTC, GND) 1

Page 4 - generated design source: tools/build_all.py Bytebeam hardware design assignment - pre-fabrication design review release

Sheet: /3_Battery_3V3/ File: pwr_battery.kicad_sch

Title: 3 - Backup battery charger / power path (BQ24074) and 3.3V rail (TPS62A01-Q1)

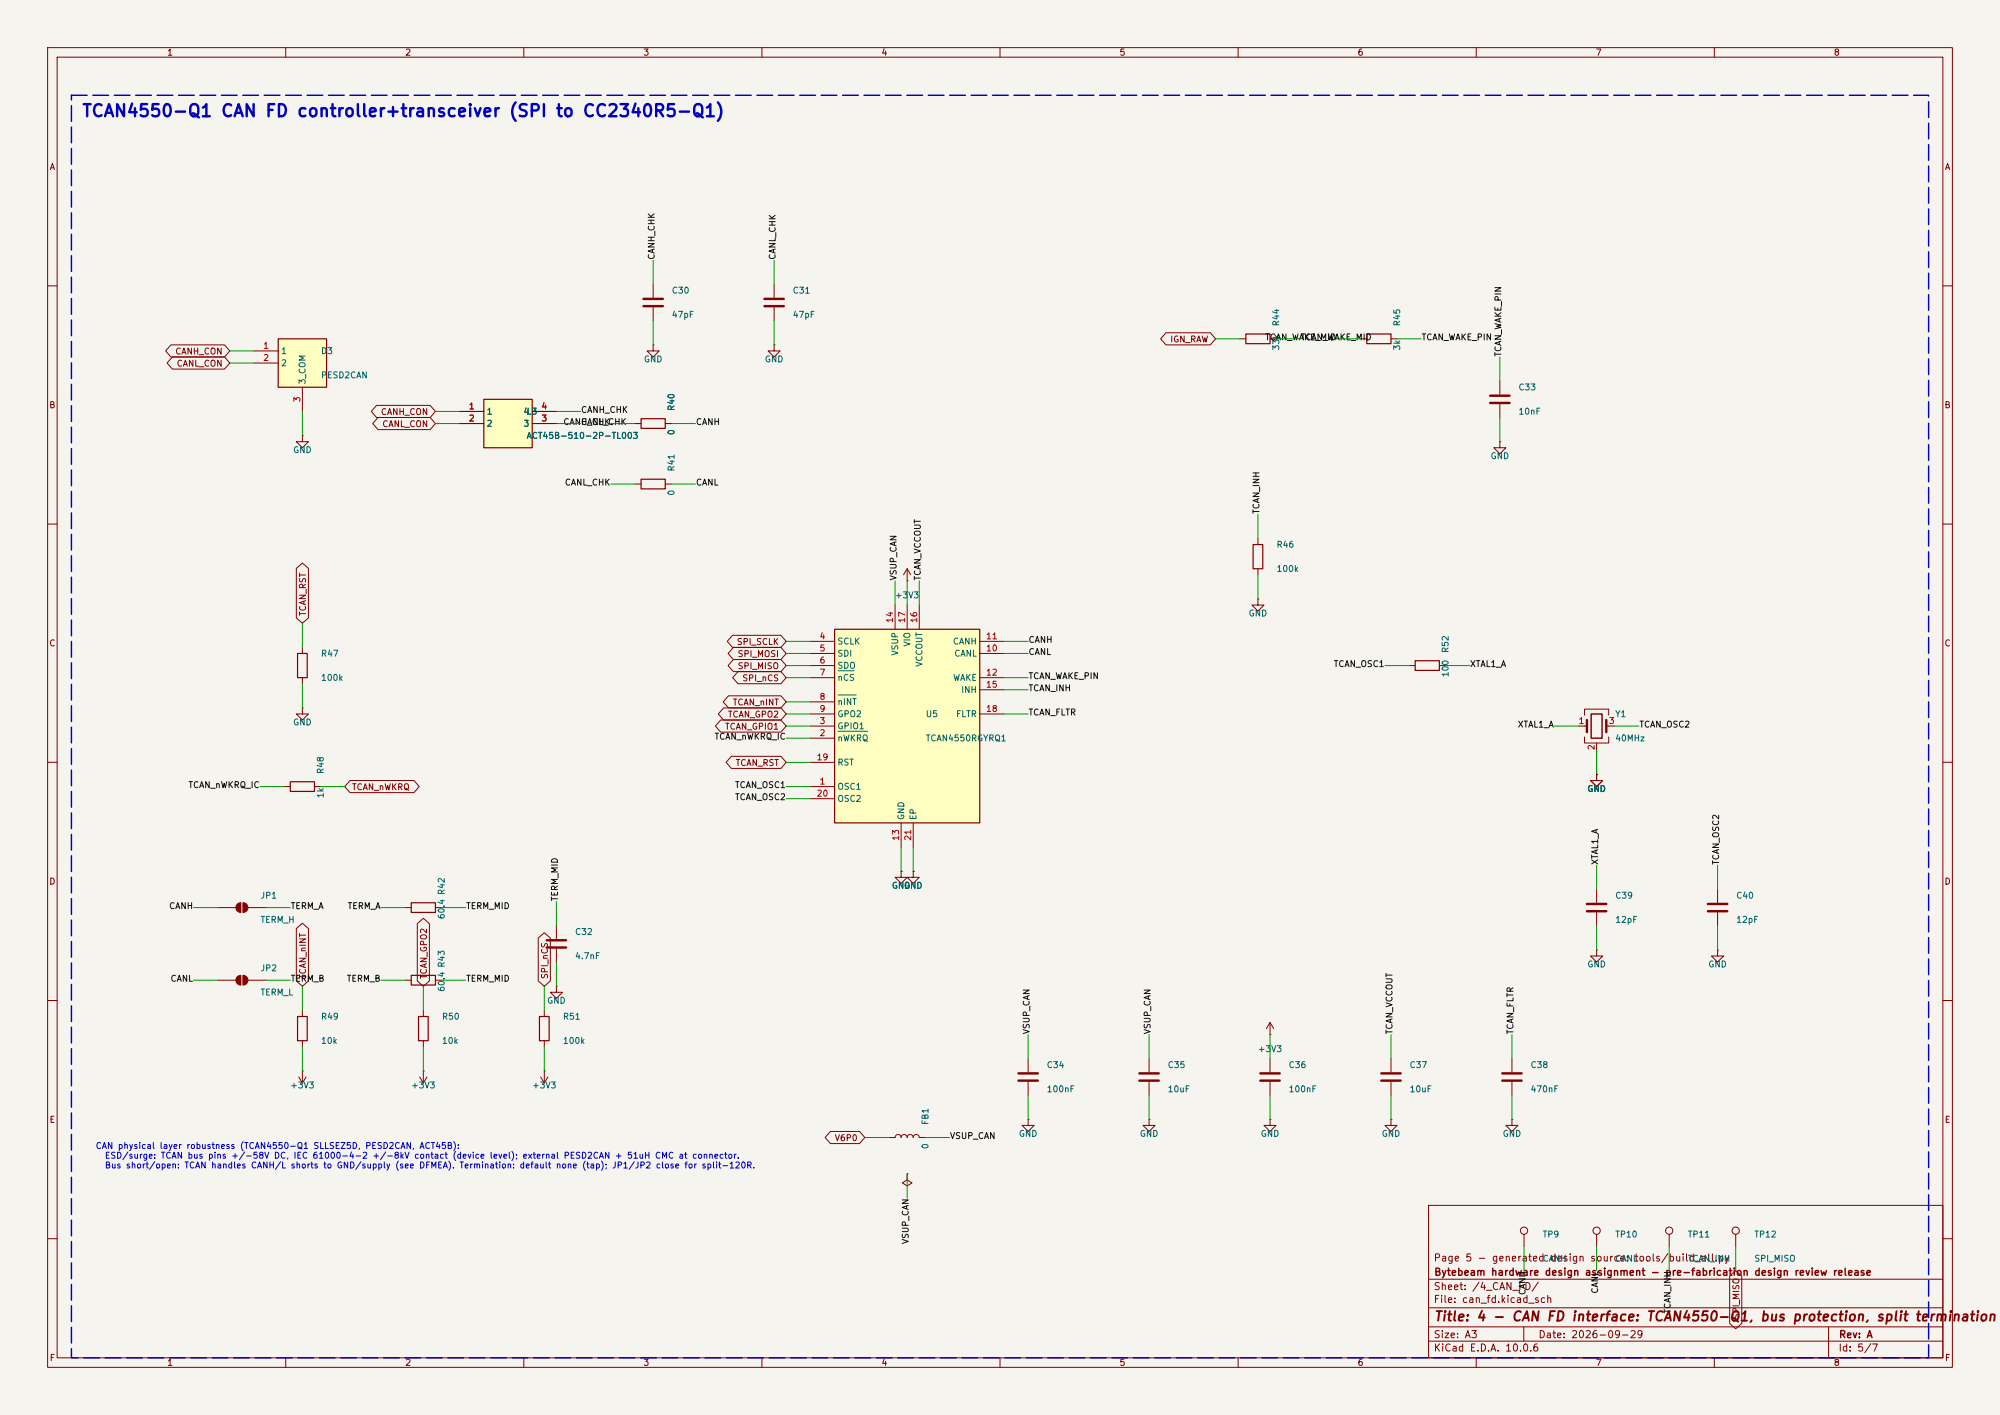
[picture p24: page 5]

TCAN4550-Q1 CAN FD controller+transceiver (SPI to CC2340R5-Q1)

Page 5 - generated design source: tools/build_all.py R50

CAN physical layer robustness (TCAN4550-Q1 SLLSEZ5D, PESD2CAN, ACT45B):

Bytebeam hardware design assignment - pre-fabrication design review release
Sheet: /4_CAN_FD/
File: can_fd.kicad_sch
Title: 4 - CAN FD interface: TCAN4550-Q1, bus protection, split termination option

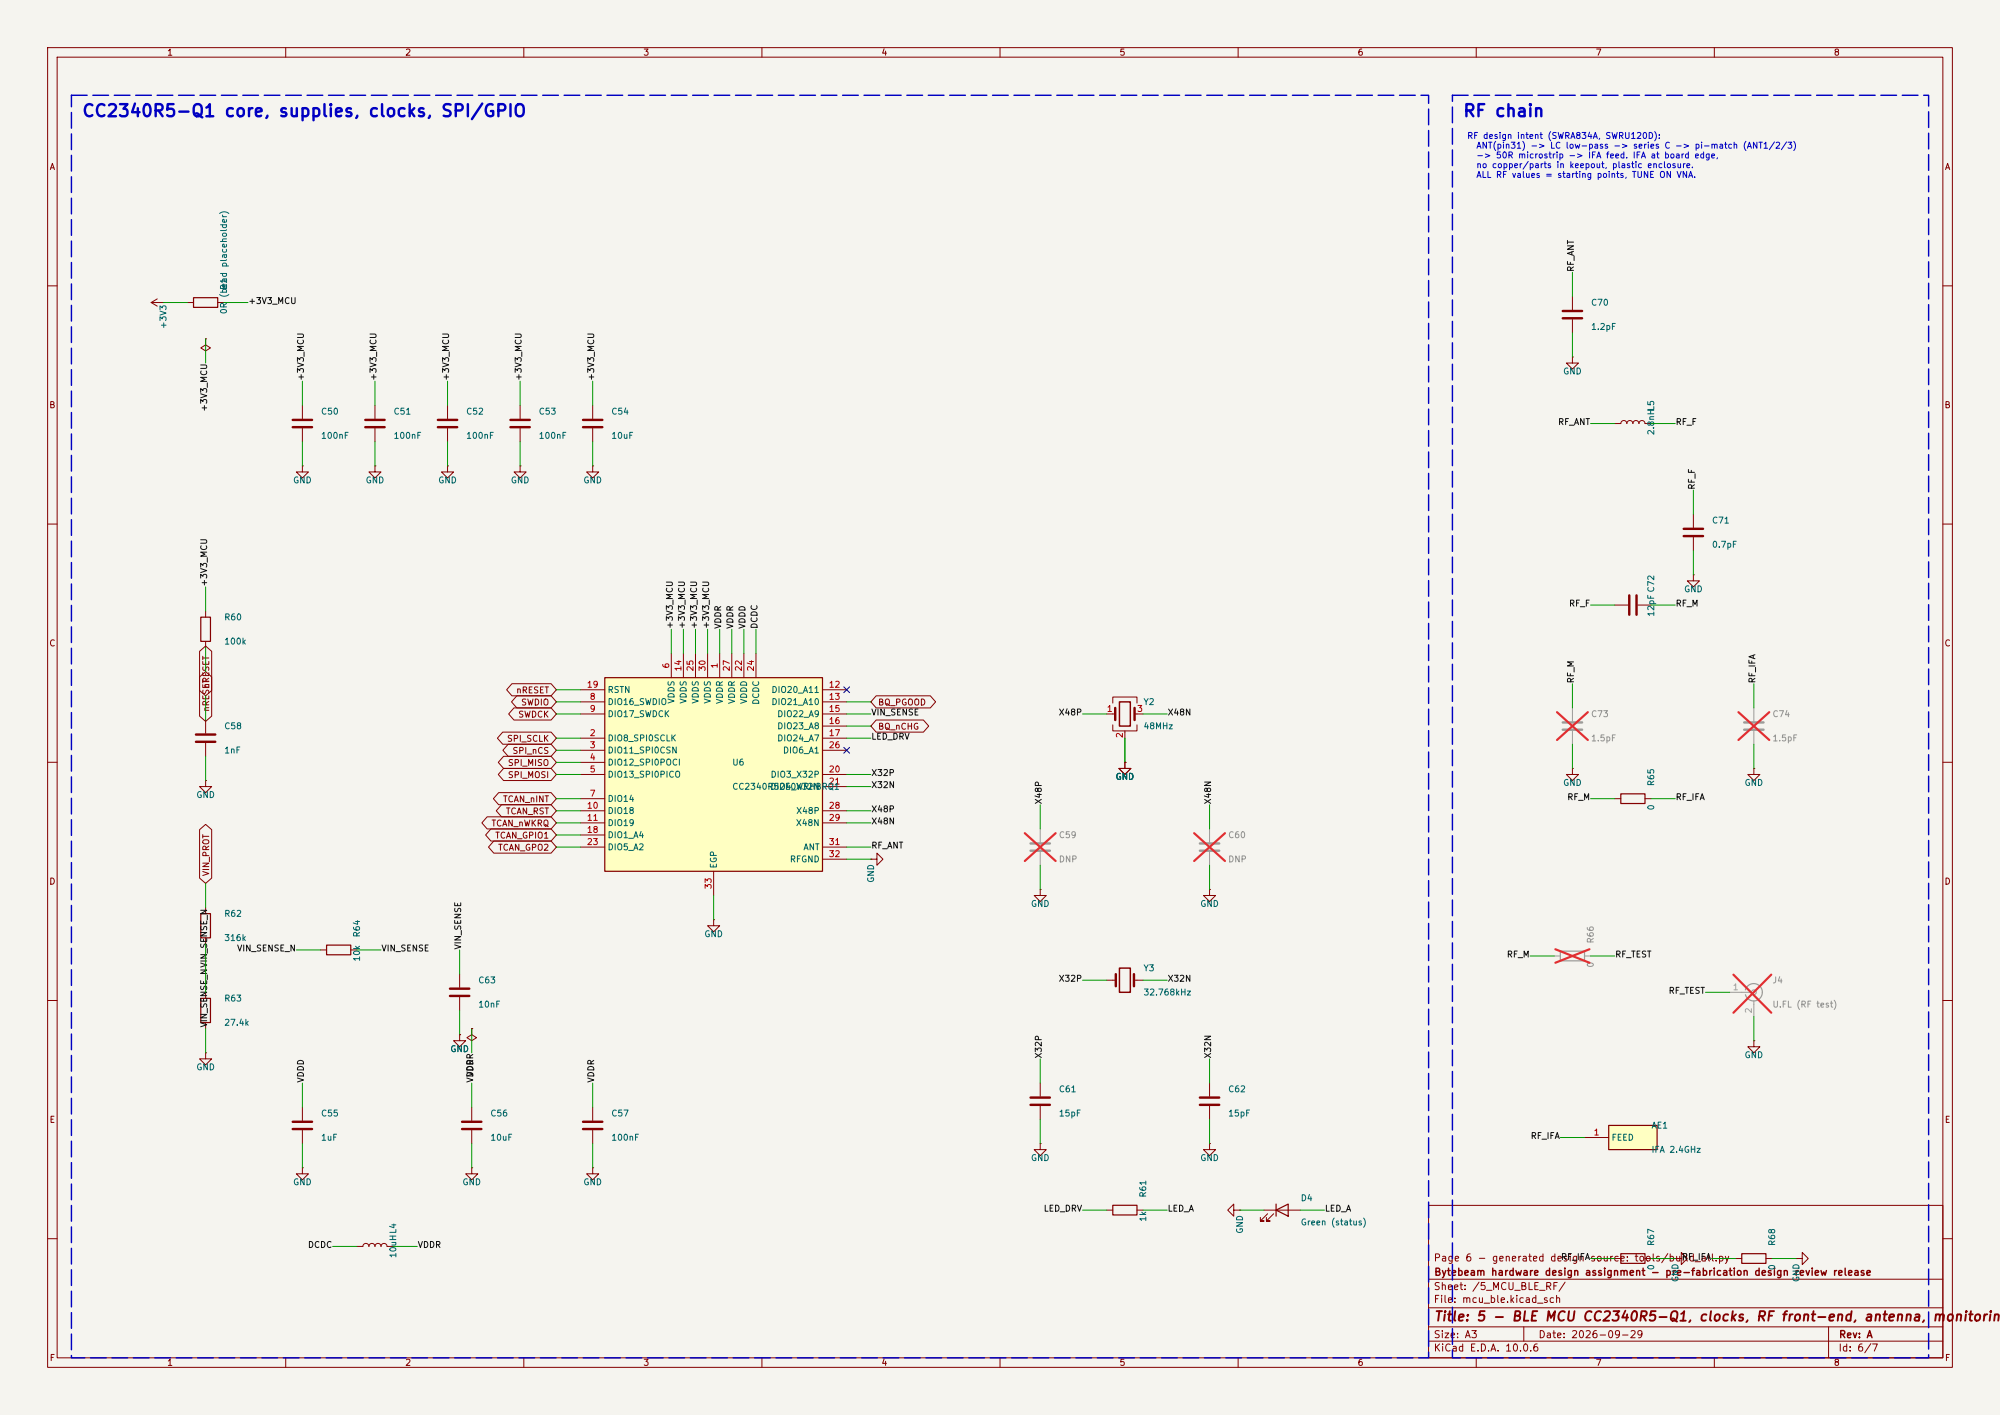
[picture p25: page 6]

RF design intent (SWRA834A, SWRU120D): ANT(pin31) -> LC low-pass -> series C -> pi-match (ANT1/2/3) -> 50R microstrip -> IFA feed. IFA at board edge, no copper/parts in keepout, plastic enclosure. ALL RF values = starting points, TUNE ON VNA.

J4U.FL (RF test) R65 0 B1 0R (bead placeholder) +3V3

RF_TEST +3V3_MCU +3V3_MCU +3V3_MCU +3V3_MCU VDDR VDDR VDDD DCDC

6 DIO14 7 DIO16_SWDIO 8 DIO17_SWDCK 9 DIO18 10 DIO19 11 DIO20_A11 12 DIO21_A10 13 VDDS 14 DIO22_A9 15 DIO23_A8 16 DIO24_A7 17 DIO1_A4 18 RSTN 19 DIO3_X32P 20 DIO4_X32N 21 VDDD 22 DIO5_A2 23 DCDC 24 VDDS 25 DIO6_A1 26 VDDR 27

Page 6 - generated design source: tools/build_all.py

Bytebeam hardware design assignment - pre-fabrication design review release
Sheet: /5_MCU_BLE_RF/ File: mcu_ble.kicad_sch

Title: 5 - BLE MCU CC2340R5-Q1, clocks, RF front-end, antenna, monitoring

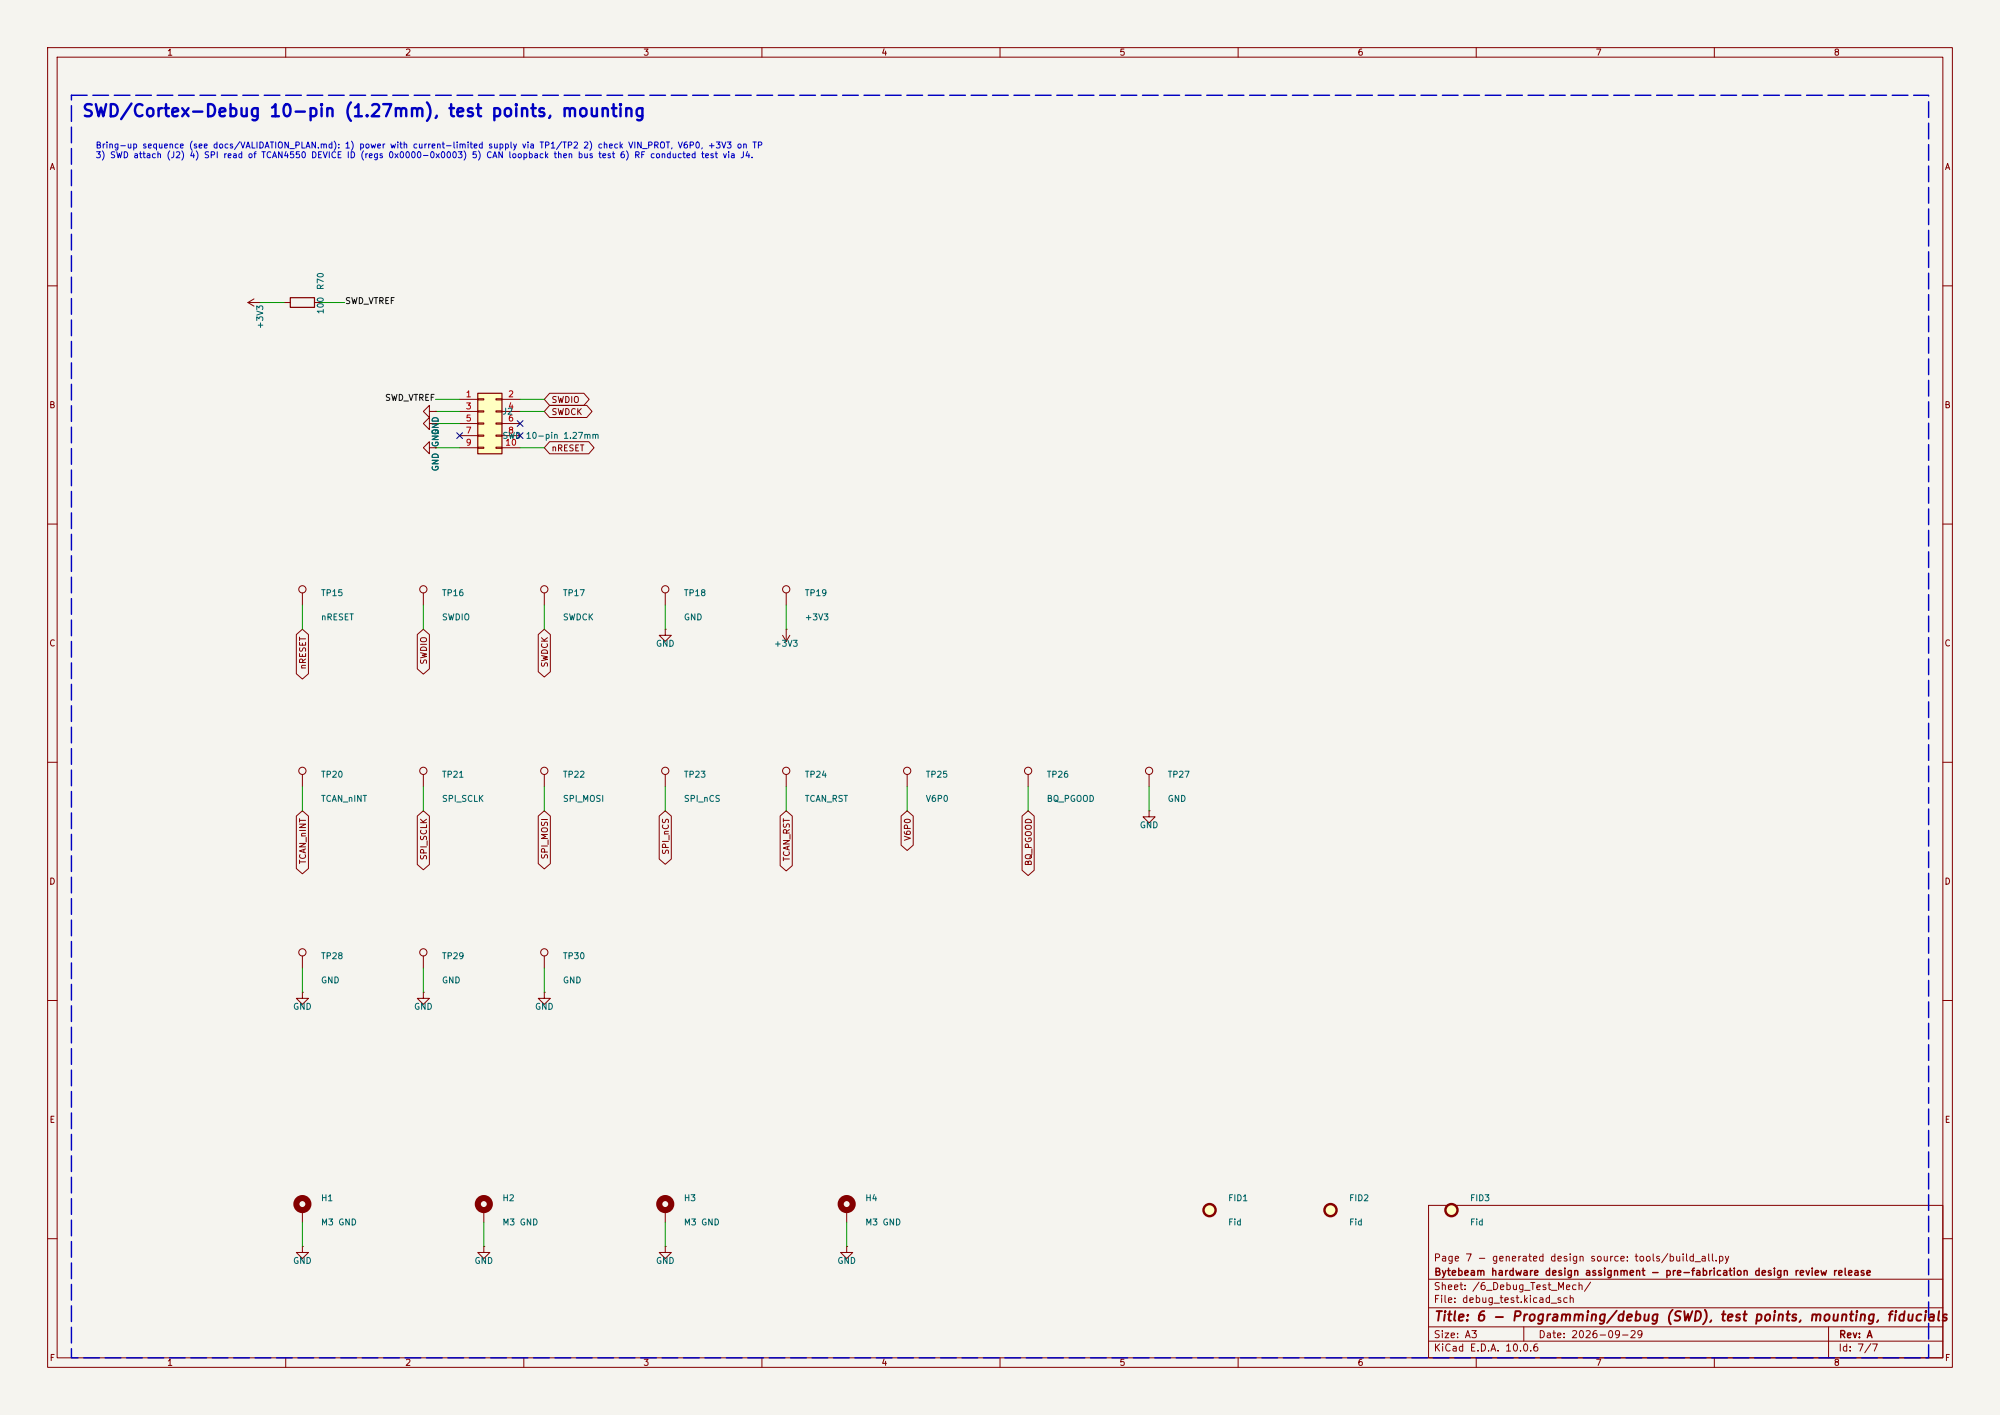
[picture p26: page 7]

SWD_VTREFSWD_VTREF SWD/Cortex-Debug 10-pin (1.27mm), test points, mounting

Bring-up sequence (see docs/VALIDATION_PLAN.md): 1) power with current-limited supply via TP1/TP2 2) check VIN_PROT, V6P0, +3V3 on TP
3) SWD attach (J2) 4) SPI read of TCAN4550 DEVICE ID (regs 0x0000-0x0003) 5) CAN loopback then bus test 6) RF conducted test via J4. GND GND

Page 7 - generated design source: tools/build_all.py
Bytebeam hardware design assignment - pre-fabrication design review release
Sheet: /6_Debug_Test_Mech/
File: debug_test.kicad_sch
Title: 6 - Programming/debug (SWD), test points, mounting, fiducials
