Atif6894/automotive-ble-can-pcb/schematic/assembly_top.pdf

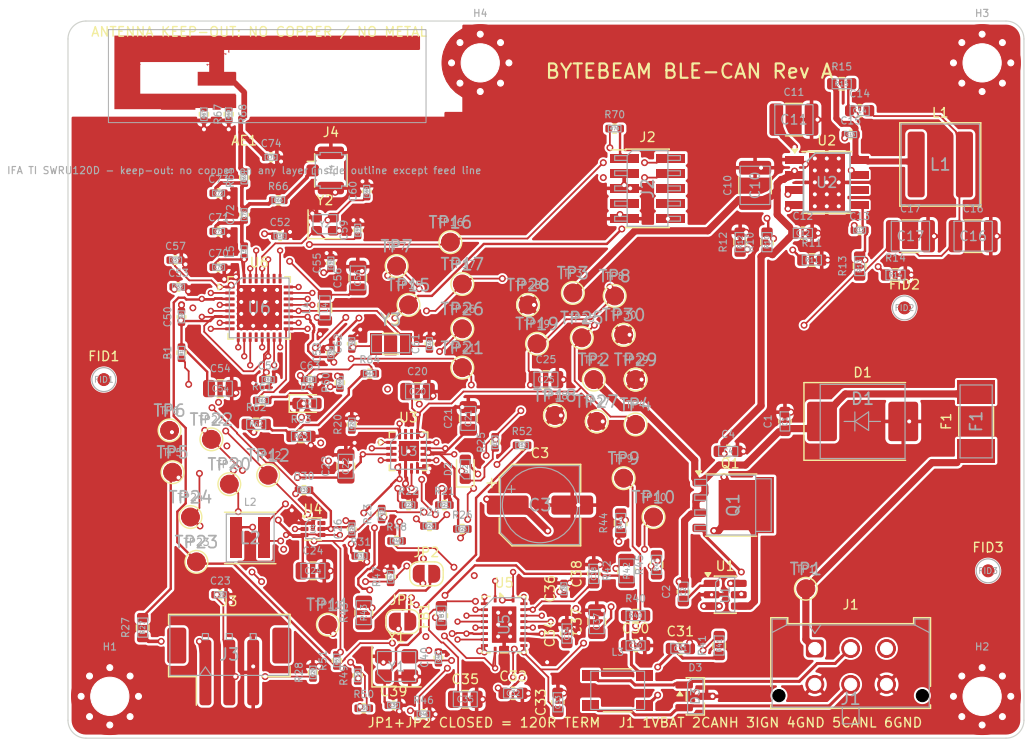
[picture p27: page 1]
