Atif6894/automotive-ble-can-pcb/schematic/pcb_layers.pdf

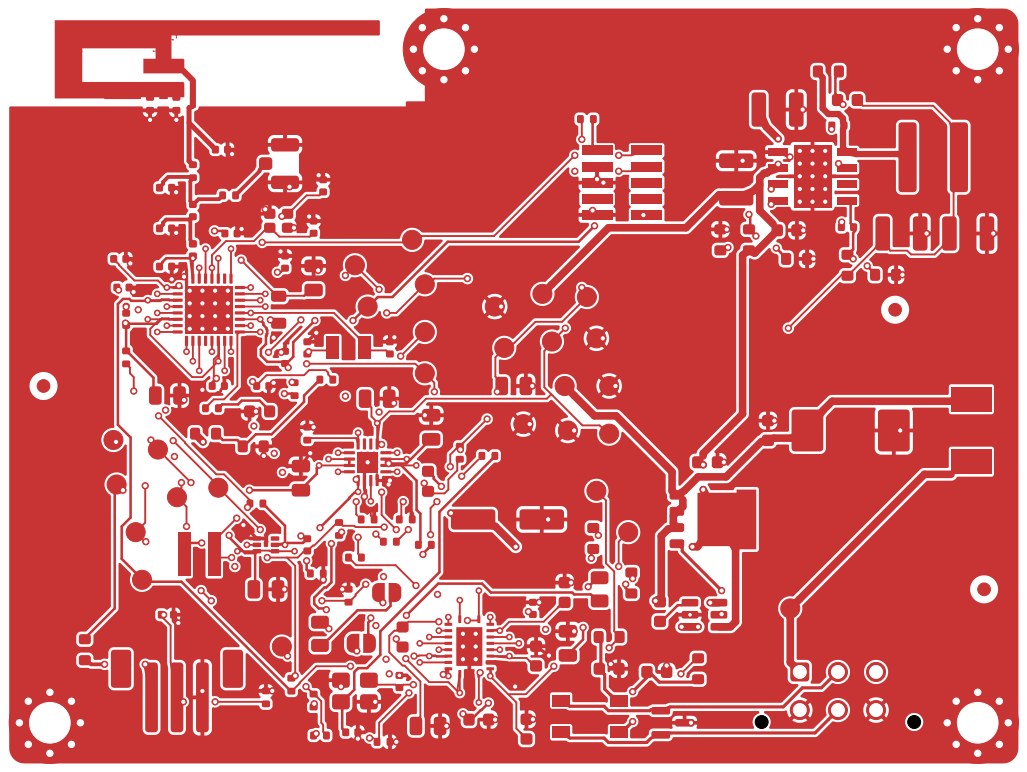
[picture p28: page 1]

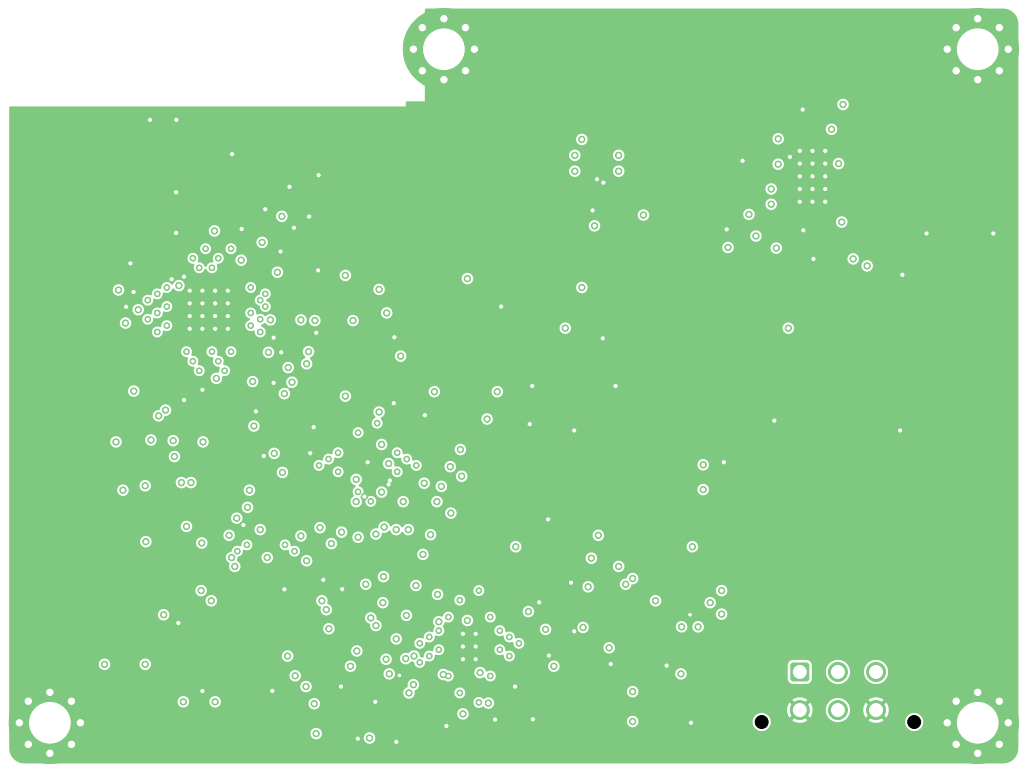
[picture p29: page 2]

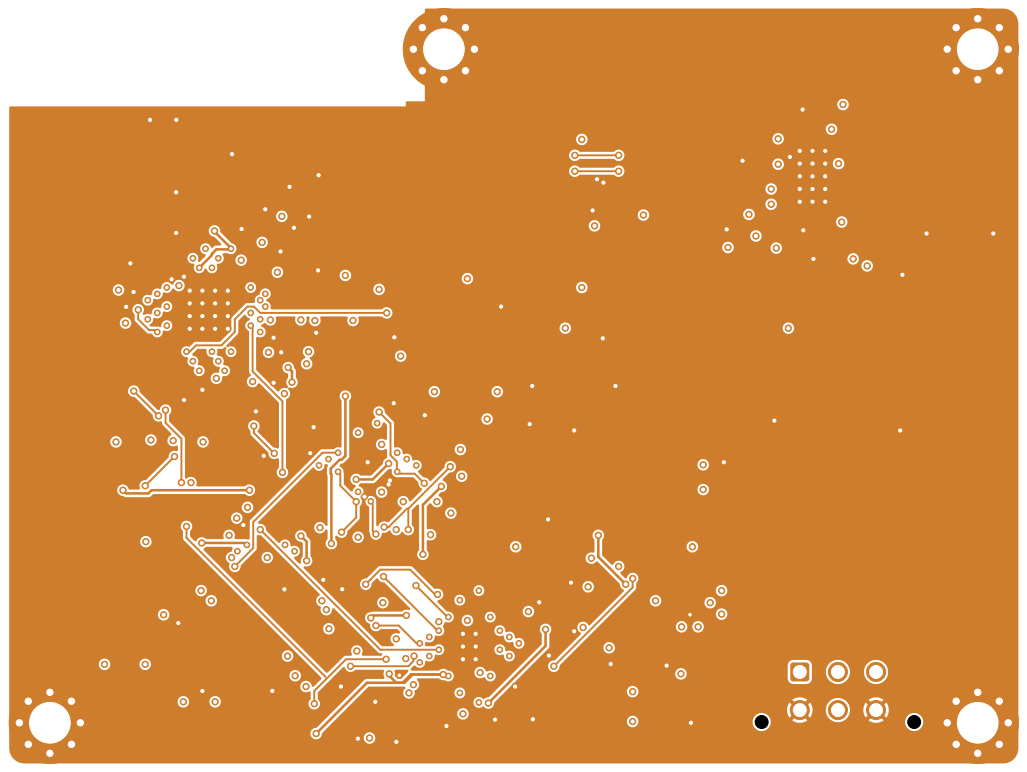
[picture p30: page 3]

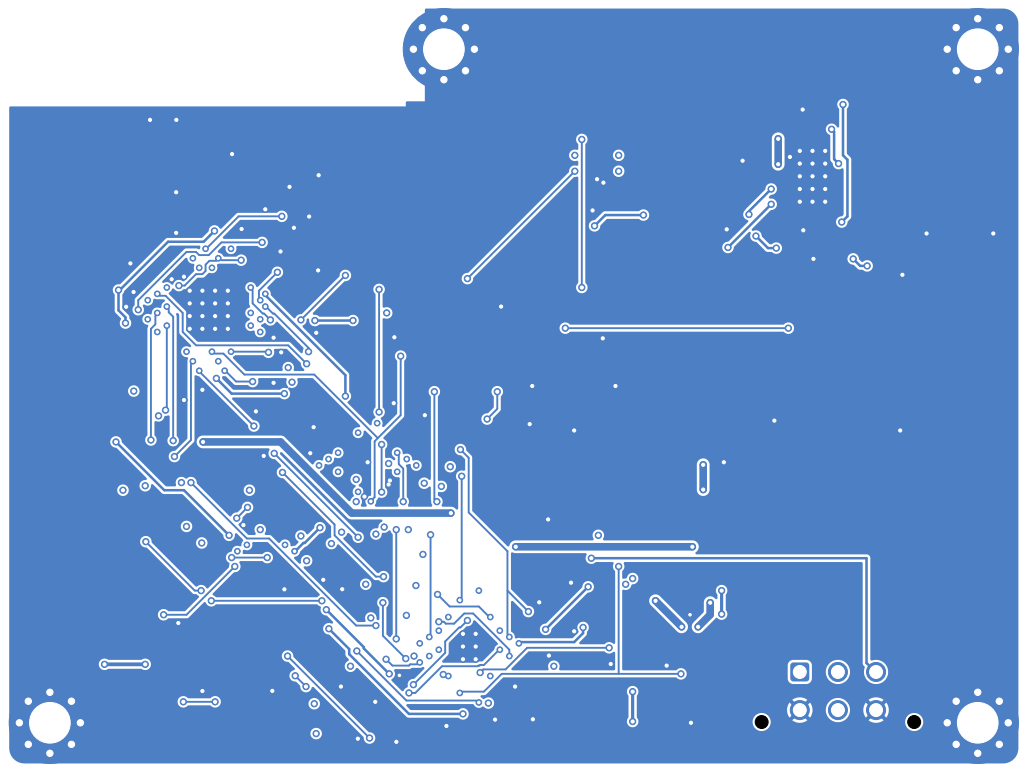
[picture p31: page 4]

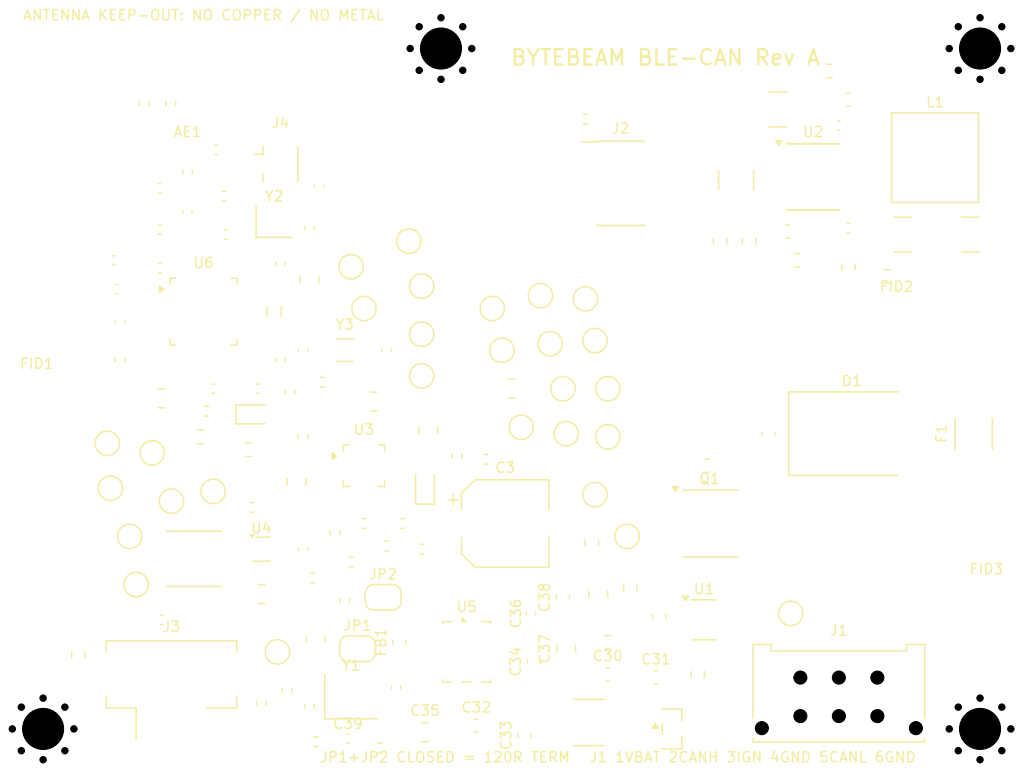
[picture p32: page 5]

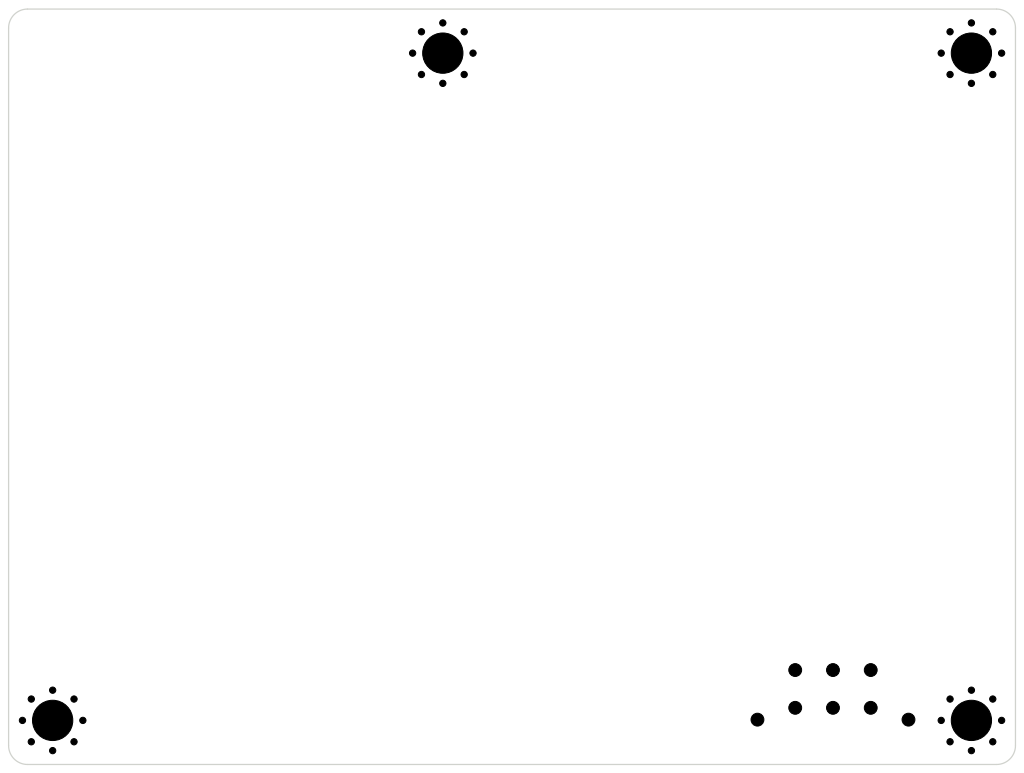
[picture p33: page 6]
