Atif6894/automotive-ble-can-pcb/design_files/bytebeam_ble_can.kicad_pcb

## KiCad design design_files/bytebeam_ble_can.kicad_pcb (2026-10-08)

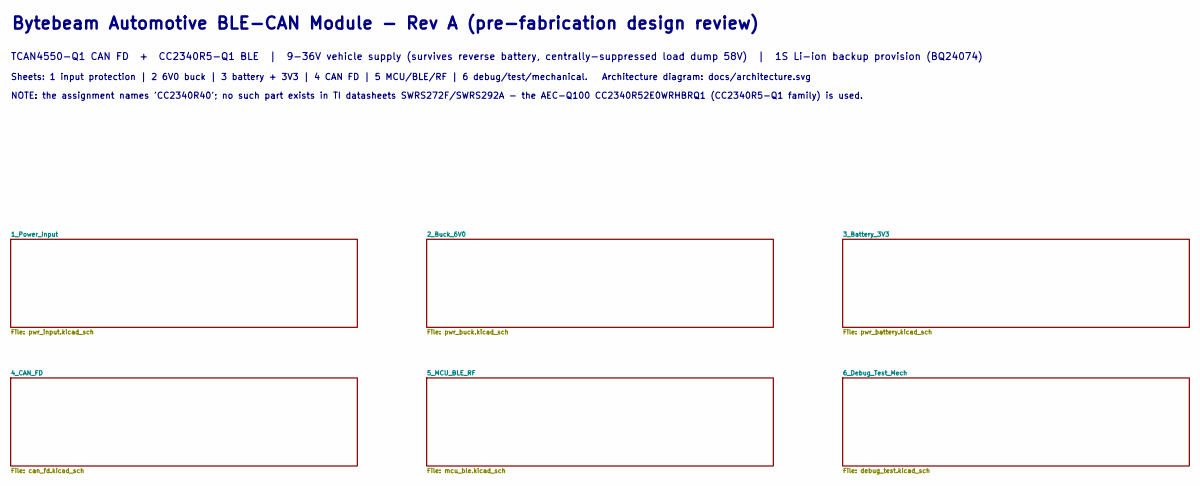
[picture p34: schematic bytebeam_ble_can.kicad_sch, Bytebeam Automotive BLE-CAN Module (TCAN4550 + CC2340R5-Q1)]

Notes on the sheet:
Sheets: 1 input protection | 2 6V0 buck | 3 battery + 3V3 | 4 CAN FD | 5 MCU/BLE/RF | 6 debug/test/mechanical. Architecture diagram: docs/architecture.svg
Bytebeam Automotive BLE-CAN Module - Rev A (pre-fabrication design review)
NOTE: the assignment names 'CC2340R40'; no such part exists in TI datasheets SWRS272F/SWRS292A - the AEC-Q100 CC2340R52E0WRHBRQ1 (CC2340R5-Q1 family) is used.
TCAN4550-Q1 CAN FD + CC2340R5-Q1 BLE | 9-36V vehicle supply (survives reverse battery, centrally-suppressed load dump 58V) | 1S Li-ion backup provision (BQ24074)

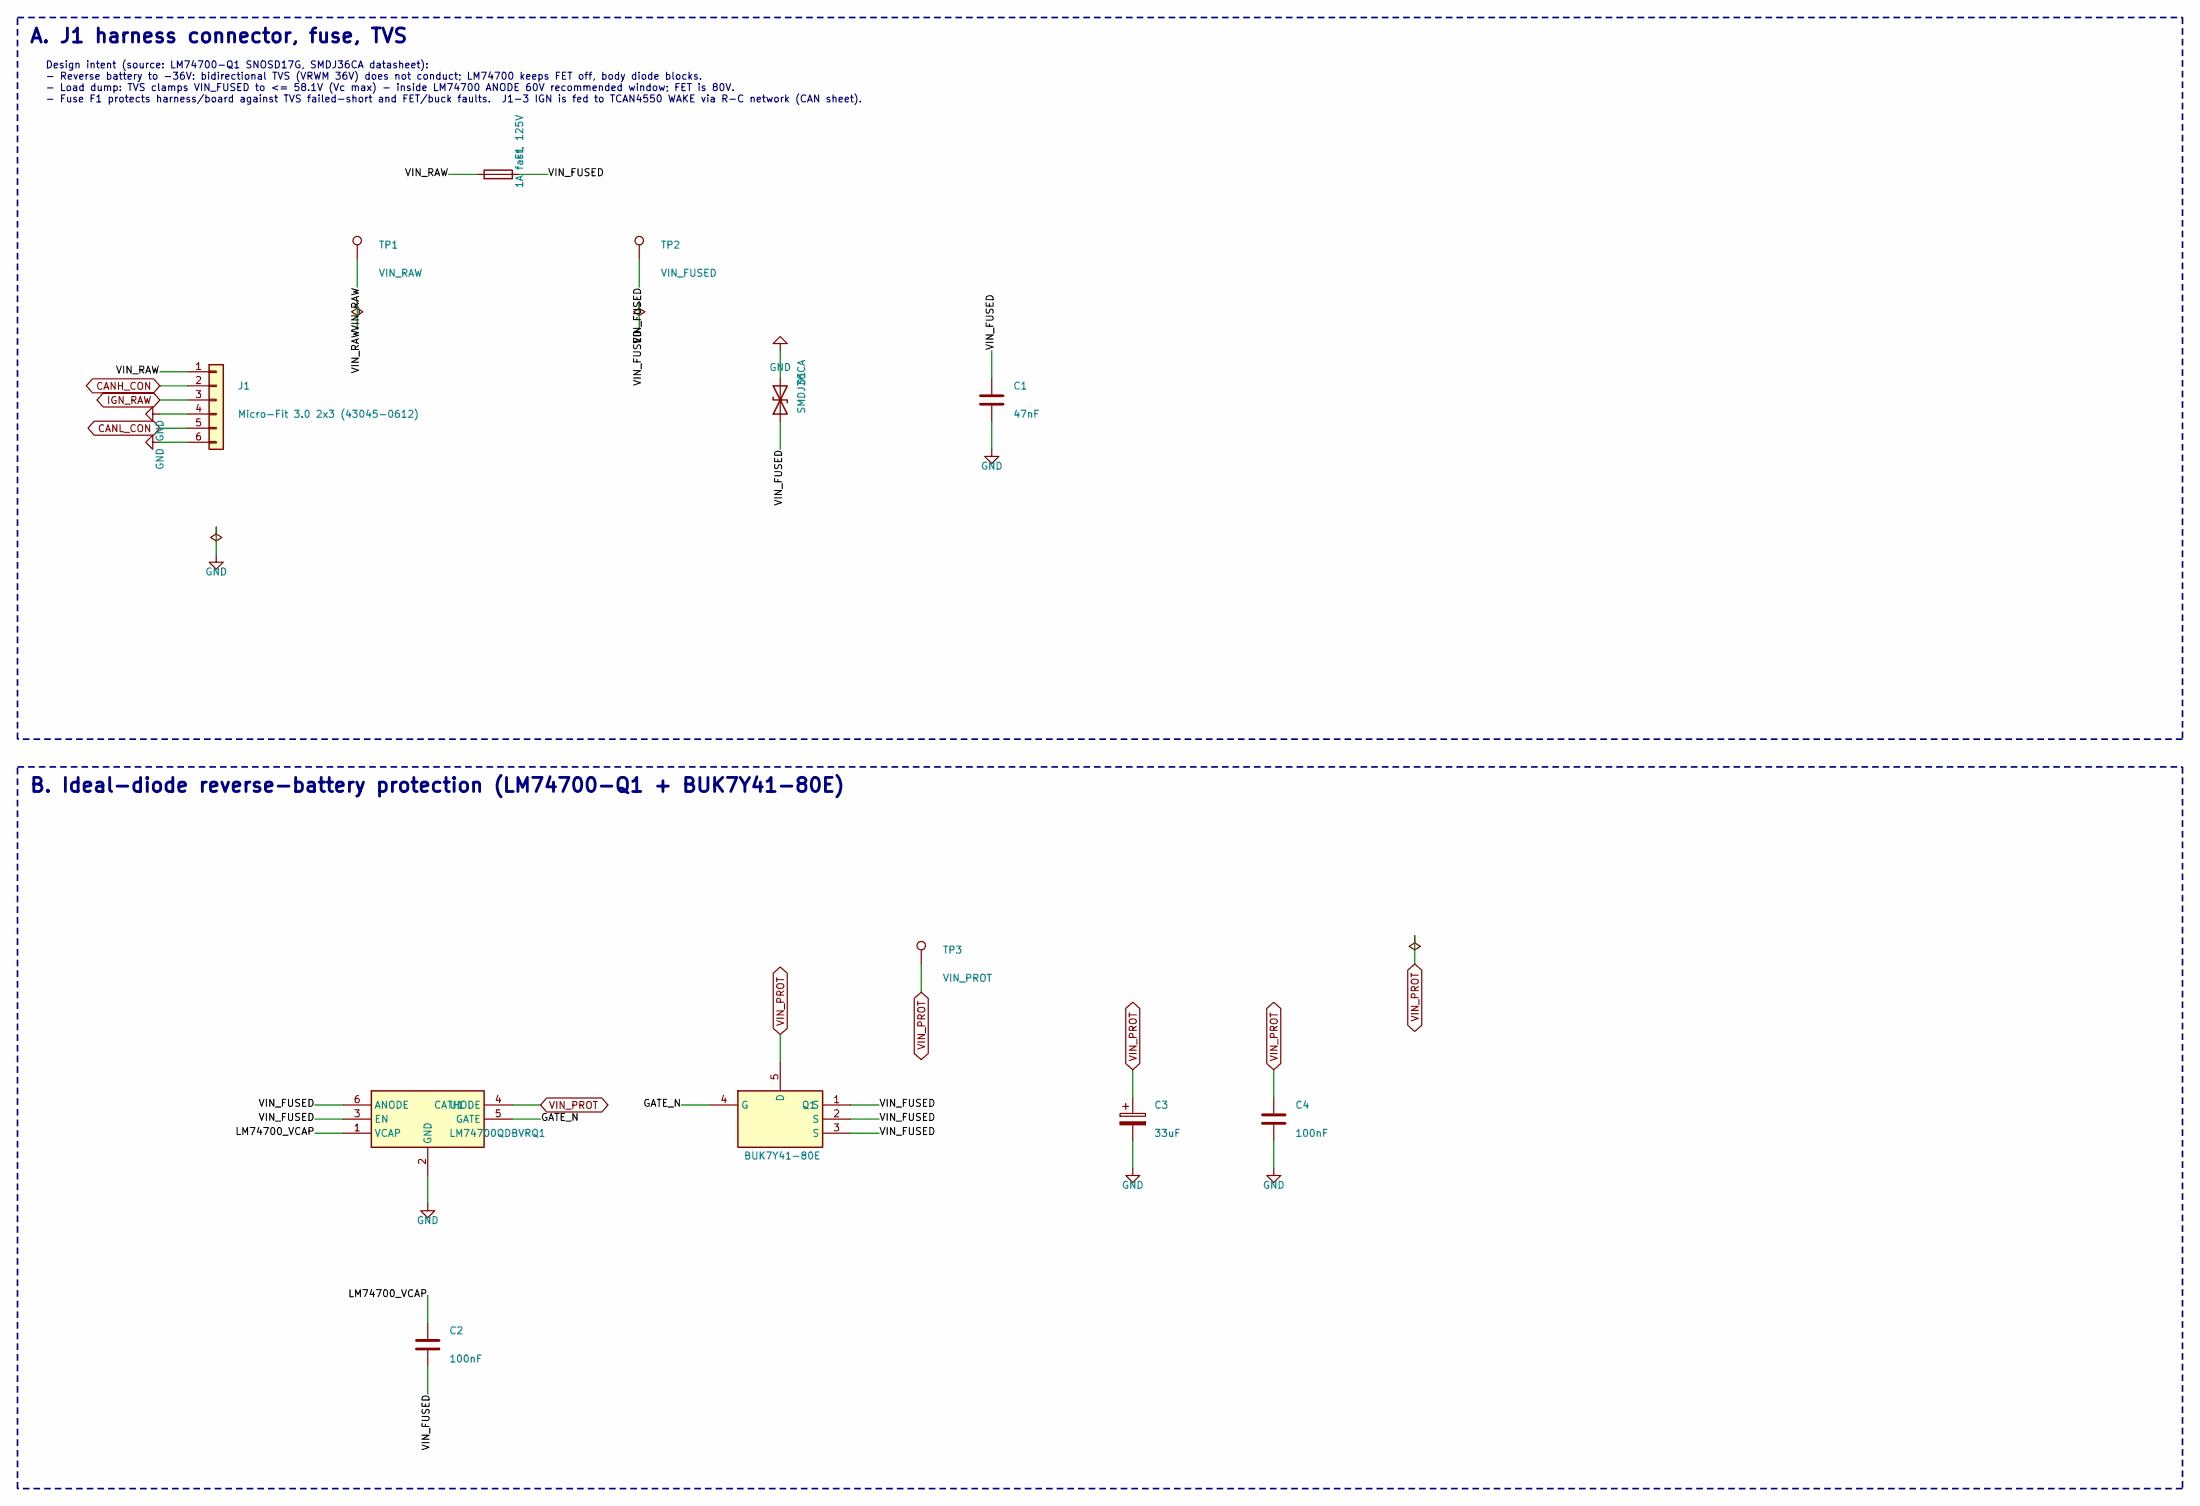
[picture p35: schematic pwr_input.kicad_sch, 1 - Vehicle supply input: connector, fuse, load-dump TVS, i…]

Parts:
C1: 47nF; C_0603_1608Metric; Rating 100V X7R; MPN GCM-series (AEC-Q200) 47nF 100V X7R
C2: 100nF; C_0603_1608Metric; Rating 25V X7R; MPN GCM-series (AEC-Q200) 100nF 25V X7R
C3: 33uF; CP_Elec_6.3x5.8; Rating 50V X7R; MPN EEE-FN1H330P
C4: 100nF; C_0603_1608Metric; Rating 100V X7R; MPN GCM-series (AEC-Q200) 100nF 100V X7R
D1: SMDJ36CA; D_SMC; Rating 3000W bidirectional, VRWM 36V, Vc(max) 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; MPN SMDJ36CA
F1: 1A fast, 125V; Fuse_Littelfuse-NANO2-451_453; Rating 1A, 125V, very-fast-acting NANO2 (sourc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; MPN 0451001.MRL
J1: Micro-Fit 3.0 2x3 (43045-0612); Molex_Micro-Fit_3.0_43045-0612_2x03_P3.00mm_Vertical; Rating Micro-Fit 3.0 2x3 vertical THT, 5A/circ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; MPN 43045-0612
Q1: BUK7Y41-80E; LFPAK56; Rating 80V 41mOhm std-level, VGS +/-20V (LM747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; MPN BUK7Y41-80E,115
TP1: VIN_RAW; TestPoint_Pad_D1.5mm; Rating bare copper pad; MPN PCB test pad D1.5mm
TP2: VIN_FUSED; TestPoint_Pad_D1.5mm; Rating bare copper pad; MPN PCB test pad D1.5mm
TP3: VIN_PROT; TestPoint_Pad_D1.5mm; Rating bare copper pad; MPN PCB test pad D1.5mm
U1: LM74700QDBVRQ1; SOT-23-6; Rating ANODE +/-60V rec. (65V abs), AEC-Q100 g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; MPN LM74700QDBVRQ1

Connections:
/1_Power_Input/GATE_N: Q1.4 (G), U1.5 (GATE)
/1_Power_Input/LM74700_VCAP: C2.1, U1.1 (VCAP)
/1_Power_Input/VIN_FUSED: C1.1, C2.2, D1.1 (A1), F1.2, Q1.1 (S), Q1.2 (S), Q1.3 (S), TP2.1, U1.3 (EN), U1.6 (ANODE)
/1_Power_Input/VIN_RAW: F1.1, J1.1, TP1.1
CANH_CON: J1.2; also elsewhere on the board
CANL_CON: J1.5; also elsewhere on the board
GND: C1.2, C3.2, C4.2, D1.2 (A2), J1.4, J1.6, U1.2 (GND); also elsewhere on the board
IGN_RAW: J1.3; also elsewhere on the board
VIN_PROT: C3.1, C4.1, Q1.5 (D), TP3.1, U1.4 (CATHODE); also elsewhere on the board

Notes on the sheet:
B. Ideal-diode reverse-battery protection (LM74700-Q1 + BUK7Y41-80E)
Design intent (source: LM74700-Q1 SNOSD17G, SMDJ36CA datasheet): - Reverse battery to -36V: bidirectional TVS (VRWM 36V) does not conduct; LM74700 keeps FET off, body diode blocks. - Load dump: TVS clamps VIN_FUSED to <= 58.1V (Vc max) - inside LM74700 ANODE 60V recommended window; FET is 80V. - Fu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
A. J1 harness connector, fuse, TVS

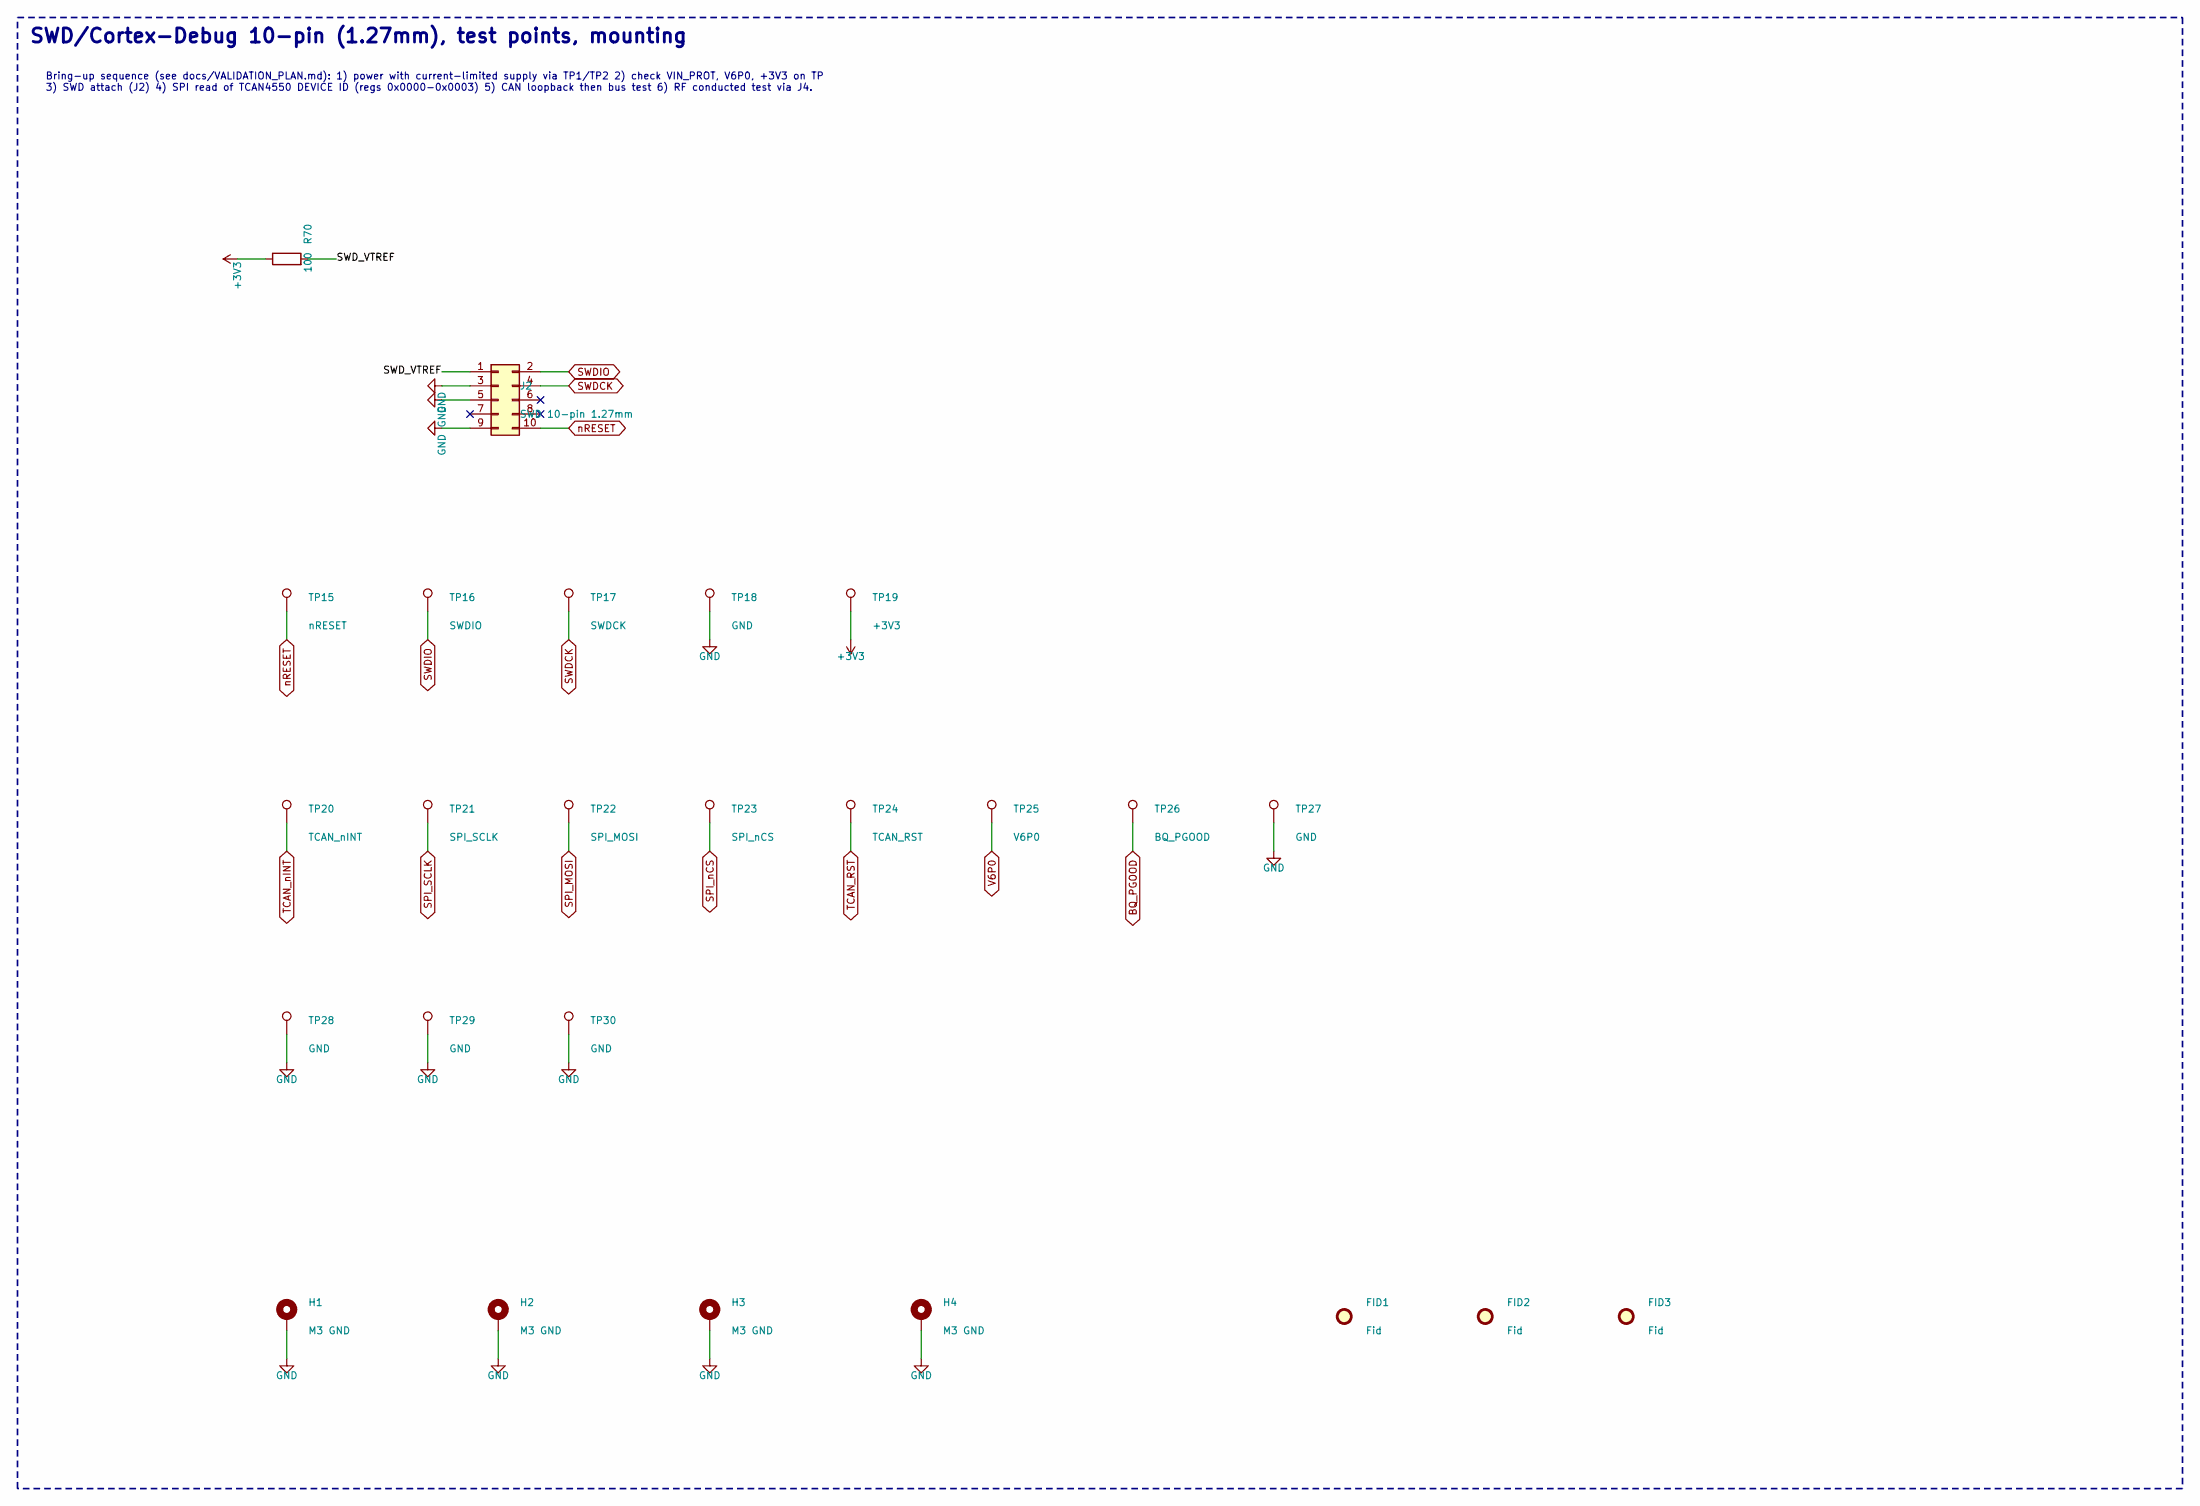
[picture p36: schematic debug_test.kicad_sch, 6 - Programming/debug (SWD), test points, mounting, fiducia…]

Parts:
FID1, FID2, FID3: Fid; Fiducial_1mm_Mask2mm; Rating n/a; MPN Fiducial 1mm
H1, H2, H3, H4: M3 GND; MountingHole_3.2mm_M3_Pad_Via; Rating 3.2mm, plated, GND; MPN M3 plated hole
J2: SWD 10-pin 1.27mm; PinHeader_2x05_P1.27mm_Vertical_SMD; Rating 2x5 1.27mm SMD shrouded, ARM Cortex Deb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; MPN FTSH-105-01-L-DV-K
R70: 100; R_0402_1005Metric; Rating 1%, AEC-Q200 thick film; MPN AC0402FR-07100RL
TP15: nRESET; TestPoint_Pad_D1.5mm; Rating bare copper pad; MPN PCB test pad D1.5mm
TP16: SWDIO; TestPoint_Pad_D1.5mm; Rating bare copper pad; MPN PCB test pad D1.5mm
TP17: SWDCK; TestPoint_Pad_D1.5mm; Rating bare copper pad; MPN PCB test pad D1.5mm
TP18, TP27, TP28, TP29, TP30: GND; TestPoint_Pad_D1.5mm; Rating bare copper pad; MPN PCB test pad D1.5mm
TP19: +3V3; TestPoint_Pad_D1.5mm; Rating bare copper pad; MPN PCB test pad D1.5mm
TP20: TCAN_nINT; TestPoint_Pad_D1.5mm; Rating bare copper pad; MPN PCB test pad D1.5mm
TP21: SPI_SCLK; TestPoint_Pad_D1.5mm; Rating bare copper pad; MPN PCB test pad D1.5mm
TP22: SPI_MOSI; TestPoint_Pad_D1.5mm; Rating bare copper pad; MPN PCB test pad D1.5mm
TP23: SPI_nCS; TestPoint_Pad_D1.5mm; Rating bare copper pad; MPN PCB test pad D1.5mm
TP24: TCAN_RST; TestPoint_Pad_D1.5mm; Rating bare copper pad; MPN PCB test pad D1.5mm
TP25: V6P0; TestPoint_Pad_D1.5mm; Rating bare copper pad; MPN PCB test pad D1.5mm
TP26: BQ_PGOOD; TestPoint_Pad_D1.5mm; Rating bare copper pad; MPN PCB test pad D1.5mm

Connections:
+3V3: R70.1, TP19.1; also elsewhere on the board
/6_Debug_Test_Mech/SWD_VTREF: J2.1, R70.2
BQ_PGOOD: TP26.1; also elsewhere on the board
GND: H1.1, H2.1, H3.1, H4.1, J2.3, J2.5, J2.9, TP18.1, TP27.1, TP28.1, TP29.1, TP30.1; also elsewhere on the board
SPI_MOSI: TP22.1; also elsewhere on the board
SPI_SCLK: TP21.1; also elsewhere on the board
SPI_nCS: TP23.1; also elsewhere on the board
SWDCK: J2.4, TP17.1; also elsewhere on the board
SWDIO: J2.2, TP16.1; also elsewhere on the board
TCAN_RST: TP24.1; also elsewhere on the board
TCAN_nINT: TP20.1; also elsewhere on the board
V6P0: TP25.1; also elsewhere on the board
nRESET: J2.10, TP15.1; also elsewhere on the board

Notes on the sheet:
Bring-up sequence (see docs/VALIDATION_PLAN.md): 1) power with current-limited supply via TP1/TP2 2) check VIN_PROT, V6P0, +3V3 on TP 3) SWD attach (J2) 4) SPI read of TCAN4550 DEVICE ID (regs 0x0000-0x0003) 5) CAN loopback then bus test 6) RF conducted test via J4.
SWD/Cortex-Debug 10-pin (1.27mm), test points, mounting

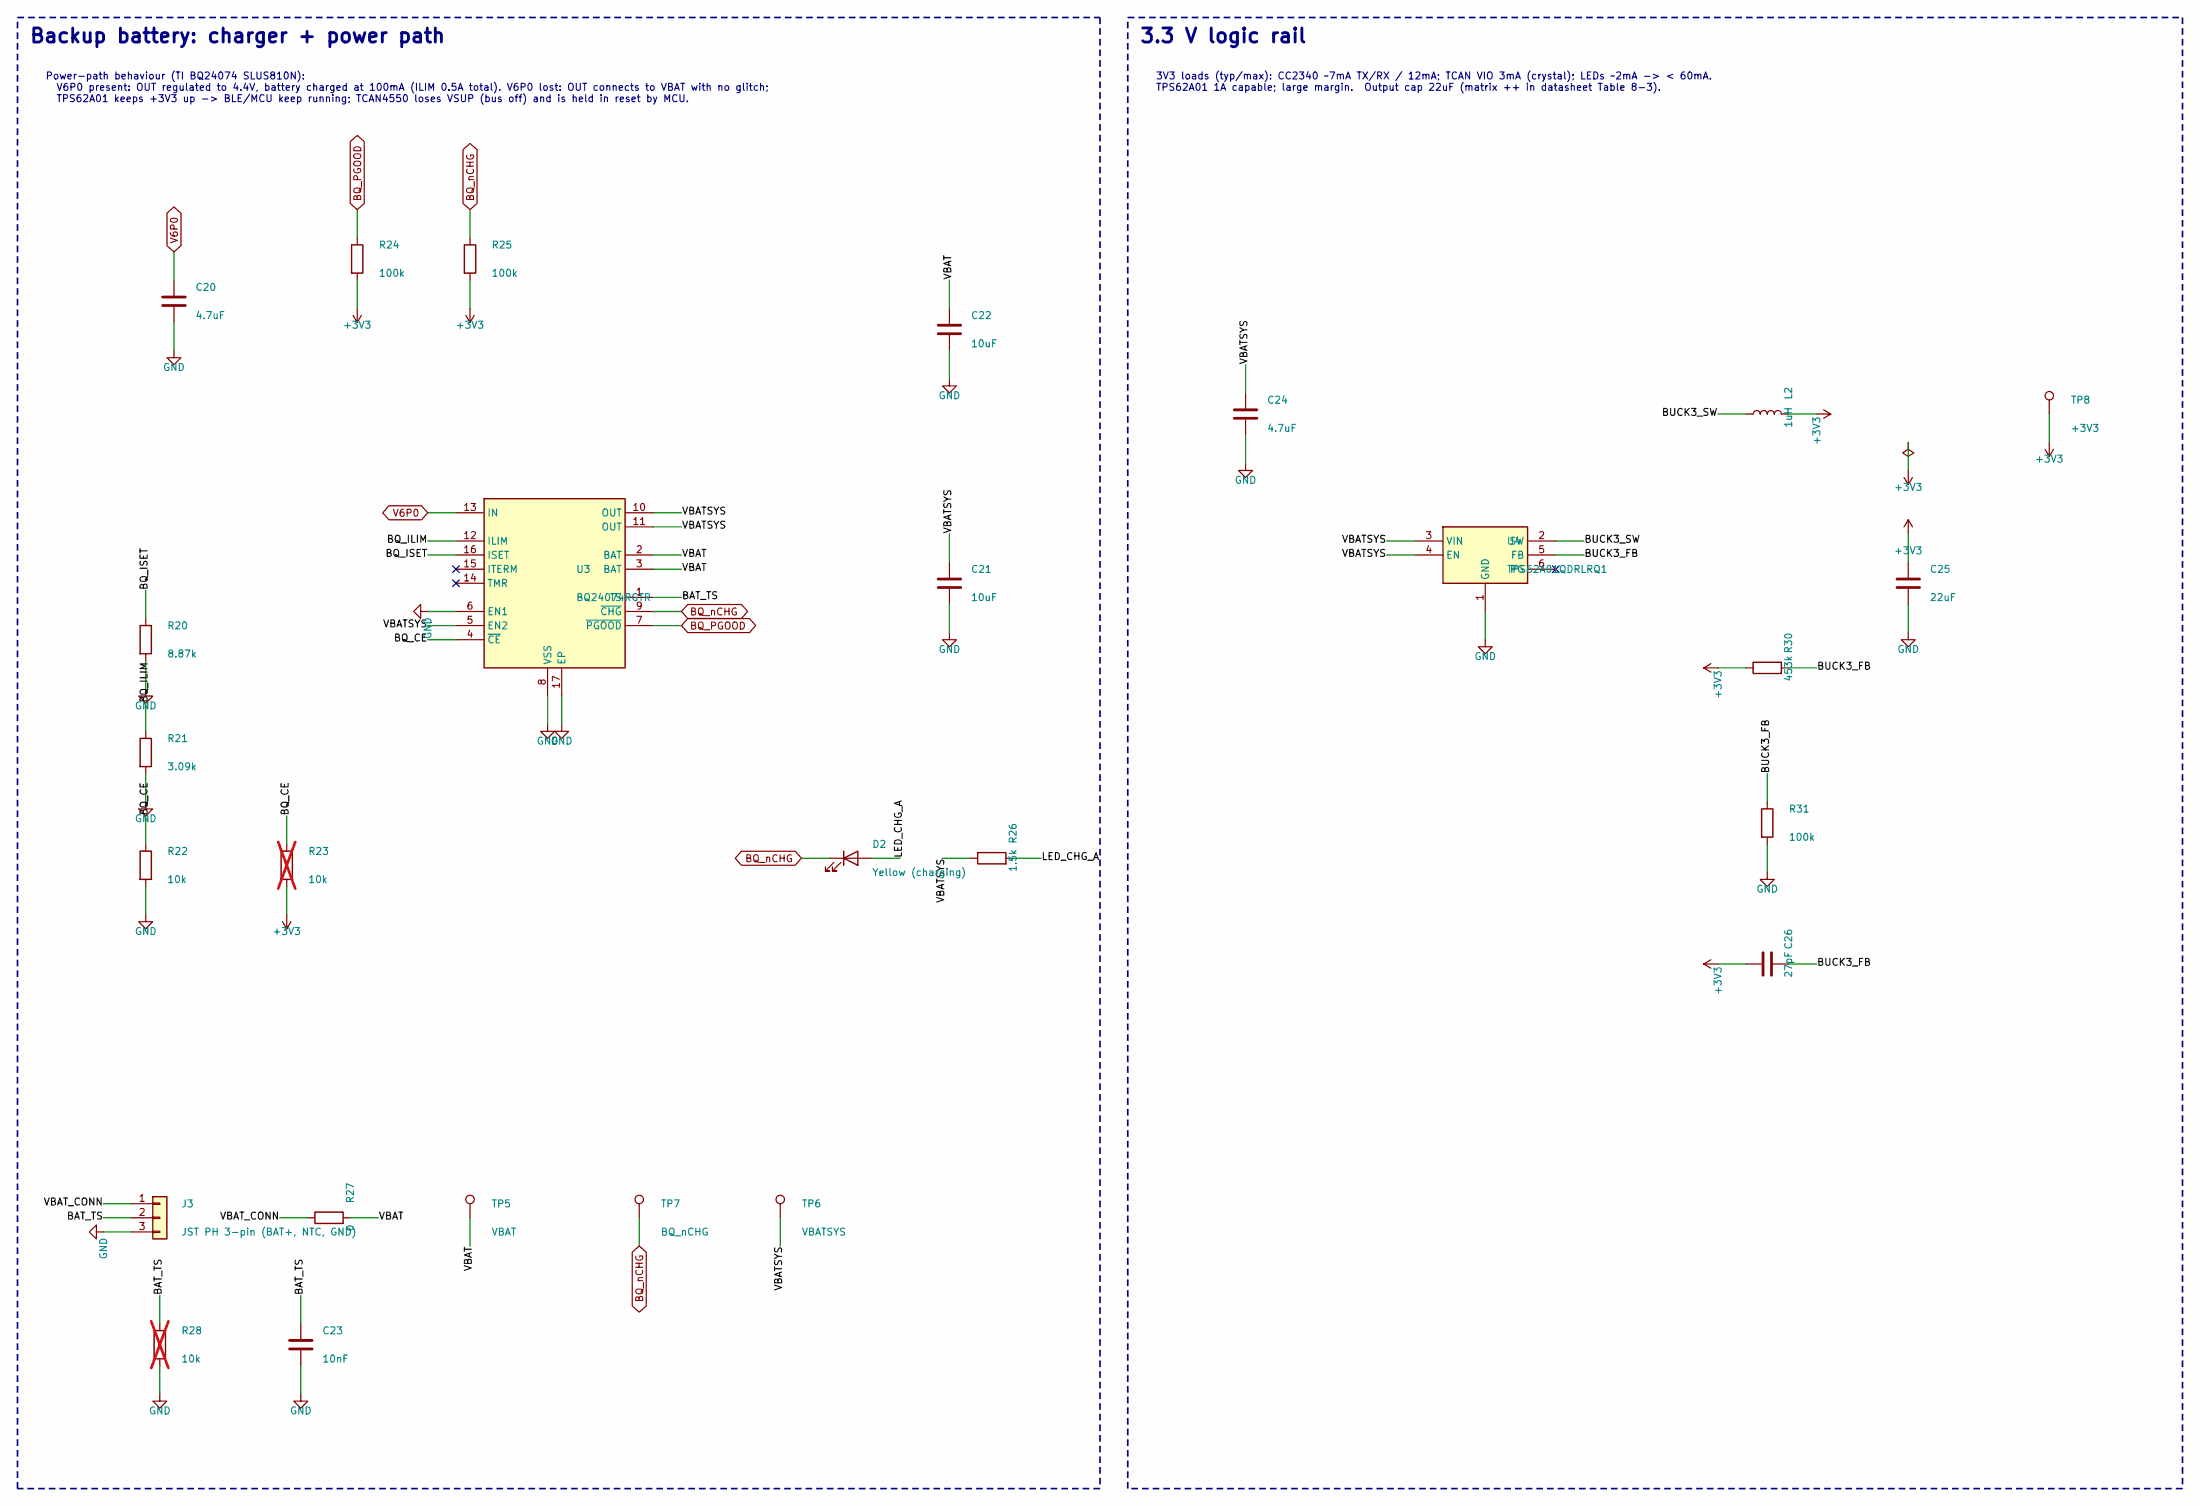
[picture p37: schematic pwr_battery.kicad_sch, 3 - Backup battery charger / power path (BQ24074) and 3.3V …]

Parts:
C20: 4.7uF; C_0805_2012Metric; Rating 16V X7R; MPN GCM-series (AEC-Q200) 4.7uF 16V X7R
C21, C22: 10uF; C_0805_2012Metric; Rating 10V X7R; MPN GCM-series (AEC-Q200) 10uF 10V X7R
C23: 10nF; C_0402_1005Metric; Rating 16V X7R; MPN GCM-series (AEC-Q200) 10nF 16V X7R
C24: 4.7uF; C_0805_2012Metric; Rating 10V X7R; MPN GRM21BR71A475KA73L
C25: 22uF; C_0805_2012Metric; Rating 10V X7R; MPN GRM21BZ71A226KE15L
C26: 27pF; C_0402_1005Metric; Rating 50V C0G; MPN GCM-series (AEC-Q200) 27pF 50V C0G
D2: Yellow (charging); LED_0603_1608Metric; Rating 0603 yellow, AEC-Q101 variant to select; MPN LTST-C193KSKT-5A
J3: JST PH 3-pin (BAT+, NTC, GND); JST_PH_B3B-PH-SM4-TB_1x03-1MP_P2.00mm_Vertical; Rating 2A, keyed, -25..85C; MPN B3B-PH-SM4-TB(LF)(SN)
L2: 1uH; L_Coilcraft_XxL4020; Rating 1uH, Isat 6.3A/8.8A, DCR<=9mOhm, AEC-Q2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; MPN XGL4020-102MEC
R20: 8.87k; R_0402_1005Metric; Rating 1%, AEC-Q200 thick film; MPN AC0402FR-078K87L
R21: 3.09k; R_0402_1005Metric; Rating 1%, AEC-Q200 thick film; MPN AC0402FR-073K09L
R22: 10k; R_0402_1005Metric; Rating 1%, AEC-Q200 thick film; MPN AC0402FR-0710KL
R23, R28: 10k; R_0402_1005Metric; Rating 1%, AEC-Q200 thick film; MPN AC0402FR-0710KL; not fitted
R24, R25, R31: 100k; R_0402_1005Metric; Rating 1%, AEC-Q200 thick film; MPN AC0402FR-07100KL
R26: 1.5k; R_0402_1005Metric; Rating 1%, AEC-Q200 thick film; MPN AC0402FR-071K5L
R27: 0; R_0603_1608Metric; Rating 0R, 1A; MPN AC0603FR-070RL
R30: 453k; R_0402_1005Metric; Rating 1%, AEC-Q200 thick film; MPN AC0402FR-07453KL
TP5: VBAT; TestPoint_Pad_D1.5mm; Rating bare copper pad; MPN PCB test pad D1.5mm
TP6: VBATSYS; TestPoint_Pad_D1.5mm; Rating bare copper pad; MPN PCB test pad D1.5mm
TP7: BQ_nCHG; TestPoint_Pad_D1.5mm; Rating bare copper pad; MPN PCB test pad D1.5mm
TP8: +3V3; TestPoint_Pad_D1.5mm; Rating bare copper pad; MPN PCB test pad D1.5mm
U3: BQ24074RGTR; VQFN-16-1EP_3x3mm_P0.5mm_EP1.6x1.6mm; Rating IN 4.35-10.5V op (26V no-damage), OUT r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; MPN BQ24074RGTR
U4: TPS62A01QDRLRQ1; SOT-563; Rating 2.5-5.5V in, 1A, AEC-Q100 grade 1 (SLUS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; MPN TPS62A01QDRLRQ1

Connections:
+3V3: C25.1, C26.1, L2.2, R23.2, R24.2, R25.2, R30.1, TP8.1; also elsewhere on the board
/3_Battery_3V3/BAT_TS: C23.1, J3.2, R28.1, U3.1 (TS)
/3_Battery_3V3/BQ_CE: R22.1, R23.1, U3.4 (~CE)
/3_Battery_3V3/BQ_ILIM: R21.1, U3.12 (ILIM)
/3_Battery_3V3/BQ_ISET: R20.1, U3.16 (ISET)
/3_Battery_3V3/BUCK3_FB: C26.2, R30.2, R31.1, U4.5 (FB)
/3_Battery_3V3/BUCK3_SW: L2.1, U4.2 (SW)
/3_Battery_3V3/LED_CHG_A: D2.2 (A), R26.2
/3_Battery_3V3/VBAT: C22.1, R27.2, TP5.1, U3.2 (BAT), U3.3 (BAT)
/3_Battery_3V3/VBATSYS: C21.1, C24.1, R26.1, TP6.1, U3.5 (EN2), U3.10 (OUT), U3.11 (OUT), U4.3 (VIN), U4.4 (EN)
/3_Battery_3V3/VBAT_CONN: J3.1, R27.1
BQ_PGOOD: R24.1, U3.7 (~PGOOD); also elsewhere on the board
BQ_nCHG: D2.1 (K), R25.1, TP7.1, U3.9 (~CHG); also elsewhere on the board
GND: C20.2, C21.2, C22.2, C23.2, C24.2, C25.2, J3.3, R20.2, R21.2, R22.2, R28.2, R31.2, U3.6 (EN1), U3.8 (VSS), U3.17 (EP), U4.1 (GND); also elsewhere on the board
V6P0: C20.1, U3.13 (IN); also elsewhere on the board

Notes on the sheet:
Power-path behaviour (TI BQ24074 SLUS810N): V6P0 present: OUT regulated to 4.4V, battery charged at 100mA (ILIM 0.5A total). V6P0 lost: OUT connects to VBAT with no glitch; TPS62A01 keeps +3V3 up -> BLE/MCU keep running; TCAN4550 loses VSUP (bus off) and is held in reset by MCU.
Backup battery: charger + power path
3V3 loads (typ/max): CC2340 ~7mA TX/RX / 12mA; TCAN VIO 3mA (crystal); LEDs ~2mA -> < 60mA. TPS62A01 1A capable; large margin. Output cap 22uF (matrix ++ in datasheet Table 8-3).
3.3 V logic rail

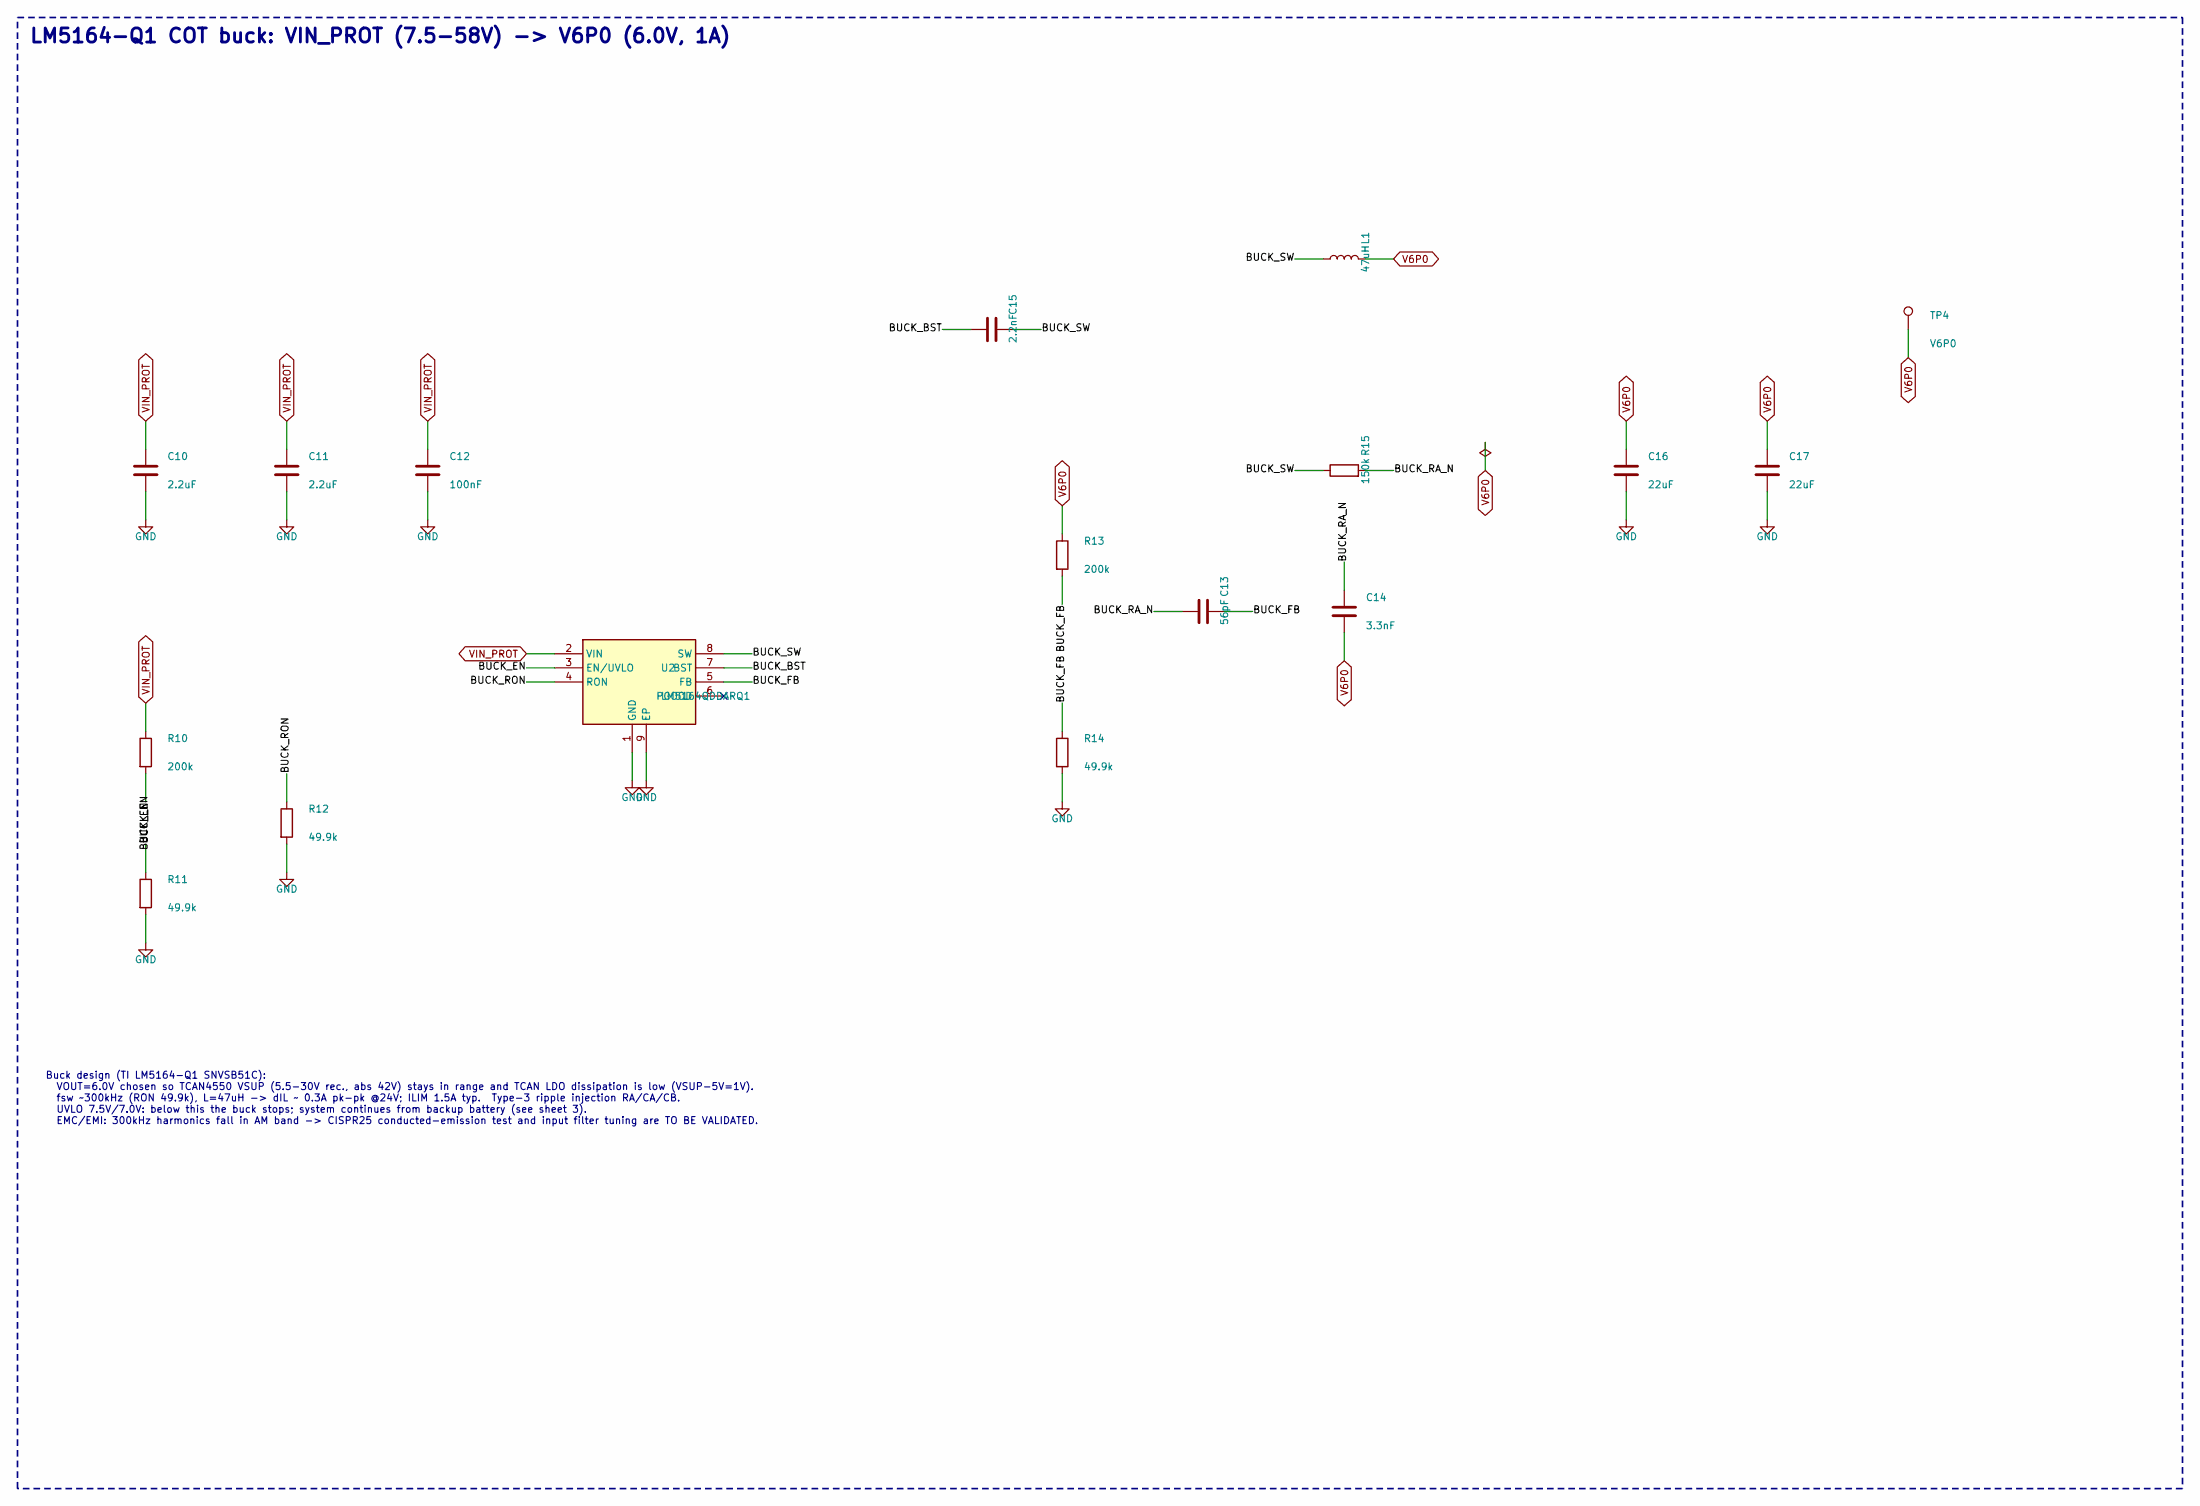
[picture p38: schematic pwr_buck.kicad_sch, 2 - 9-36V to 6.0V wide-input buck (LM5164-Q1)]

Parts:
C10, C11: 2.2uF; C_1210_3225Metric; Rating 100V X7R; MPN CGA6N3X7R2A225K230AB
C12: 100nF; C_0603_1608Metric; Rating 100V X7R; MPN GCM-series (AEC-Q200) 100nF 100V X7R
C13: 56pF; C_0402_1005Metric; Rating 50V C0G; MPN C0603C560J5GACTU
C14: 3.3nF; C_0603_1608Metric; Rating 100V X7R; MPN CGA3E2X7R2A332K080AA
C15: 2.2nF; C_0402_1005Metric; Rating 50V X7R; MPN GCM155R71H222KA37D
C16, C17: 22uF; C_1210_3225Metric; Rating 25V X7R; MPN TMK325B7226KMHT
L1: 47uH; L_Coilcraft_XAL6060-XXX; Rating 47uH, Isat 2.5A (20% drop), Irms 3.7A, 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; MPN XGL6060-473MEC
R10: 200k; R_0603_1608Metric; Rating 1% 0.1W; MPN AC0603FR-07200KL
R11, R12, R14: 49.9k; R_0603_1608Metric; Rating 1%, AEC-Q200 thick film; MPN AC0603FR-0749K9L
R13: 200k; R_0603_1608Metric; Rating 1%, AEC-Q200 thick film; MPN AC0603FR-07200KL
R15: 150k; R_0603_1608Metric; Rating 1%, AEC-Q200 thick film; MPN AC0603FR-07150KL
TP4: V6P0; TestPoint_Pad_D1.5mm; Rating bare copper pad; MPN PCB test pad D1.5mm
U2: LM5164QDDARQ1; Texas_HSOP-8-1EP_3.9x4.9mm_P1.27mm; Rating VIN 6-100V, 1A, AEC-Q100 grade 1, Tj -4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; MPN LM5164QDDARQ1

Connections:
/2_Buck_6V0/BUCK_BST: C15.1, U2.7 (BST)
/2_Buck_6V0/BUCK_EN: R10.2, R11.1, U2.3 (EN/UVLO)
/2_Buck_6V0/BUCK_FB: C13.2, R13.2, R14.1, U2.5 (FB)
/2_Buck_6V0/BUCK_RA_N: C13.1, C14.1, R15.2
/2_Buck_6V0/BUCK_RON: R12.1, U2.4 (RON)
/2_Buck_6V0/BUCK_SW: C15.2, L1.1, R15.1, U2.8 (SW)
GND: C10.2, C11.2, C12.2, C16.2, C17.2, R11.2, R12.2, R14.2, U2.1 (GND), U2.9 (EP); also elsewhere on the board
V6P0: C14.2, C16.1, C17.1, L1.2, R13.1, TP4.1; also elsewhere on the board
VIN_PROT: C10.1, C11.1, C12.1, R10.1, U2.2 (VIN); also elsewhere on the board

Notes on the sheet:
LM5164-Q1 COT buck: VIN_PROT (7.5-58V) -> V6P0 (6.0V, 1A)
Buck design (TI LM5164-Q1 SNVSB51C): VOUT=6.0V chosen so TCAN4550 VSUP (5.5-30V rec., abs 42V) stays in range and TCAN LDO dissipation is low (VSUP-5V=1V). fsw ~300kHz (RON 49.9k), L=47uH -> dIL ~ 0.3A pk-pk @24V; ILIM 1.5A typ. Type-3 ripple injection RA/CA/CB. UVLO 7.5V/7.0V: below this the buck 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
