Atif6894/automotive-ble-can-pcb/design_files/bytebeam_ble_can.kicad_pcb

## KiCad design design_files/bytebeam_ble_can.kicad_pcb (continued)

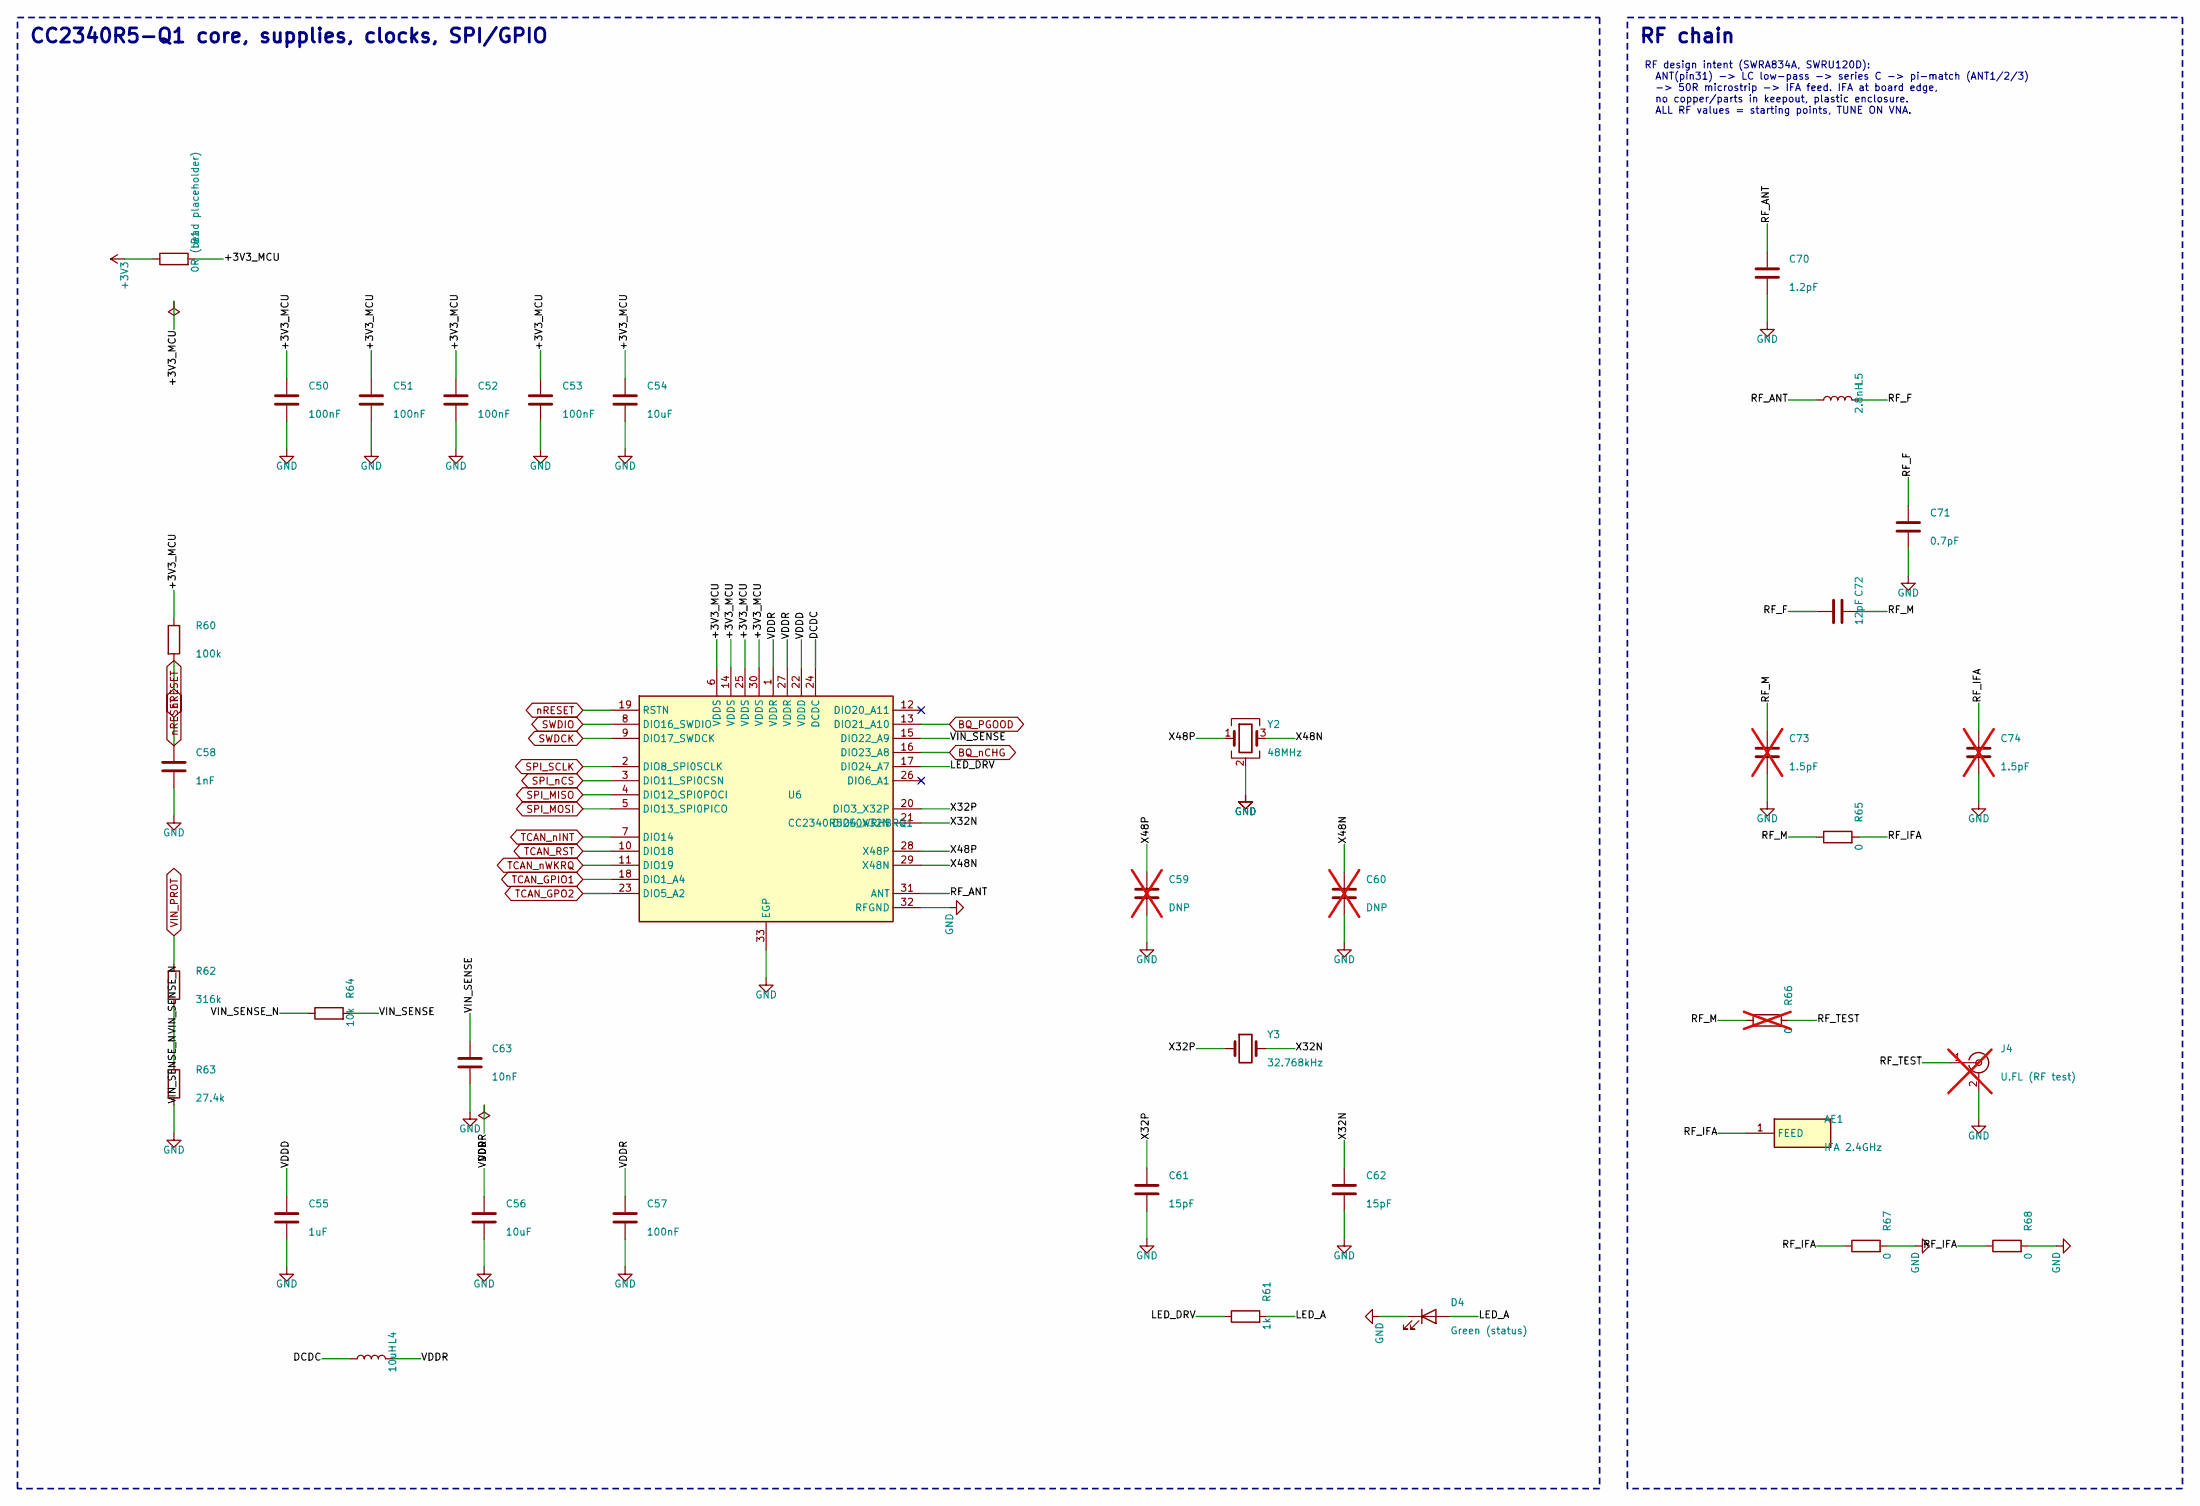
[picture p39: schematic mcu_ble.kicad_sch, 5 - BLE MCU CC2340R5-Q1, clocks, RF front-end, antenna, mon…]

Parts:
AE1: IFA 2.4GHz; ANT_IFA_TI_SWRU120_2G4; Rating PCB antenna, gain +3.3dBi max (TI meas.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; MPN TI SWRU120D inverted-F, 25.7x7.5mm
B1: 0R (bead placeholder); R_0402_1005Metric; Rating 0R link / optional ferrite bead (TI ref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; MPN AC0402JR-070RL
C50, C51, C52, C53: 100nF; C_0402_1005Metric; Rating 16V X7R; MPN GCM-series (AEC-Q200) 100nF 16V X7R
C54, C56: 10uF; C_0805_2012Metric; Rating 10V X7R; MPN GCM-series (AEC-Q200) 10uF 10V X7R
C55: 1uF; C_0402_1005Metric; Rating 10V X7R; MPN GCM-series (AEC-Q200) 1uF 10V X7R
C57: 100nF; C_0402_1005Metric; Rating 10V X7R; MPN GCM-series (AEC-Q200) 100nF 10V X7R
C58: 1nF; C_0402_1005Metric; Rating 16V X7R; MPN GCM-series (AEC-Q200) 1nF 16V X7R
C59, C60: DNP; C_0402_1005Metric; Rating 50V C0G; MPN GCM-series (AEC-Q200) DNP 50V C0G; not fitted
C61, C62: 15pF; C_0402_1005Metric; Rating 50V C0G; MPN GCM-series (AEC-Q200) 15pF 50V C0G
C63: 10nF; C_0402_1005Metric; Rating 16V X7R; MPN GCM-series (AEC-Q200) 10nF 16V X7R
C70: 1.2pF; C_0402_1005Metric; Rating C0G +/-0.1pF; MPN GCM-series (AEC-Q200) 1.2pF 50V C0G
C71: 0.7pF; C_0402_1005Metric; Rating C0G +/-0.05pF; MPN GCM-series (AEC-Q200) 0.7pF 50V C0G
C72: 12pF; C_0402_1005Metric; Rating 50V C0G; MPN GCM-series (AEC-Q200) 12pF 50V C0G
C73, C74: 1.5pF; C_0402_1005Metric; Rating 50V C0G; MPN GCM-series (AEC-Q200) 1.5pF 50V C0G; not fitted
D4: Green (status); LED_0603_1608Metric; Rating 0603 green (AEC-Q101 variant to select); MPN LTST-C193KGKT-5A
J4: U.FL (RF test); U.FL_Hirose_U.FL-R-SMT-1_Vertical; Rating 6GHz, conducted RF/BLE test only, DNP i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; MPN U.FL-R-SMT-1(10); not fitted
L4: 10uH; L_0805_2012Metric; MPN LQM21PN100MGRD or equiv. (10uH, >=150mA)
L5: 2.8nH; L_0402_1005Metric; MPN LQP15MN2N8B02D (2.8nH class)
R60: 100k; R_0402_1005Metric; Rating 1%, AEC-Q200 thick film; MPN AC0402FR-07100KL
R61: 1k; R_0402_1005Metric; Rating 1%, AEC-Q200 thick film; MPN AC0402FR-071KL
R62: 316k; R_0603_1608Metric; Rating 1%, AEC-Q200 thick film; MPN AC0603FR-07316KL
R63: 27.4k; R_0603_1608Metric; Rating 1%, AEC-Q200 thick film; MPN AC0603FR-0727K4L
R64: 10k; R_0402_1005Metric; Rating 1%, AEC-Q200 thick film; MPN AC0402FR-0710KL
R65: 0; R_0402_1005Metric; Rating 0R 0402; MPN AC0402FR-070RL
R66: 0; R_0402_1005Metric; Rating 1%, AEC-Q200 thick film; MPN AC0402FR-070RL; not fitted
R67, R68: 0; R_0402_1005Metric; Rating 1%, AEC-Q200 thick film; MPN AC0402FR-070RL
U6: CC2340R52E0WRHBRQ1; QFN-32-1EP_5x5mm_P0.5mm_EP3.7x3.7mm; Rating AEC-Q100 -40..125C, VDDS 1.71-3.8V, 512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; MPN CC2340R52E0WRHBRQ1
Y2: 48MHz; Crystal_SMD_2016-4Pin_2.0x1.6mm; Rating 48MHz +/-5ppm, CL 7pF, ESR 30R (validat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; MPN TZ3908AAAO43
Y3: 32.768kHz; Crystal_SMD_3215-2Pin_3.2x1.5mm; Rating CL 6-12pF supported, ESR 30-100k (SWRS2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; MPN FC-135R 32.768kHz 9pF (TBC)

Connections:
+3V3: B1.1; also elsewhere on the board
/5_MCU_BLE_RF/+3V3_MCU: B1.2, C50.1, C51.1, C52.1, C53.1, C54.1, R60.1, U6.6 (VDDS), U6.14 (VDDS), U6.25 (VDDS), U6.30 (VDDS)
/5_MCU_BLE_RF/DCDC: L4.1, U6.24 (DCDC)
/5_MCU_BLE_RF/LED_A: D4.2 (A), R61.2
/5_MCU_BLE_RF/LED_DRV: R61.1, U6.17 (DIO24_A7)
/5_MCU_BLE_RF/RF_ANT: C70.1, L5.1, U6.31 (ANT)
/5_MCU_BLE_RF/RF_F: C71.1, C72.1, L5.2
/5_MCU_BLE_RF/RF_IFA: AE1.1, C74.1, R65.2, R67.1, R68.1
/5_MCU_BLE_RF/RF_M: C72.2, C73.1, R65.1, R66.1
/5_MCU_BLE_RF/RF_TEST: J4.1 (In), R66.2
/5_MCU_BLE_RF/VDDD: C55.1, U6.22 (VDDD)
/5_MCU_BLE_RF/VDDR: C56.1, C57.1, L4.2, U6.1 (VDDR), U6.27 (VDDR)
/5_MCU_BLE_RF/VIN_SENSE: C63.1, R64.2, U6.15 (DIO22_A9)
/5_MCU_BLE_RF/VIN_SENSE_N: R62.2, R63.1, R64.1
/5_MCU_BLE_RF/X32N: C62.1, U6.21 (DIO4_X32N), Y3.2
/5_MCU_BLE_RF/X32P: C61.1, U6.20 (DIO3_X32P), Y3.1
/5_MCU_BLE_RF/X48N: C60.1, U6.29 (X48N), Y2.3
/5_MCU_BLE_RF/X48P: C59.1, U6.28 (X48P), Y2.1
BQ_PGOOD: U6.13 (DIO21_A10); also elsewhere on the board
BQ_nCHG: U6.16 (DIO23_A8); also elsewhere on the board
GND: C50.2, C51.2, C52.2, C53.2, C54.2, C55.2, C56.2, C57.2, C58.2, C59.2, C60.2, C61.2, C62.2, C63.2, C70.2, C71.2, C73.2, C74.2, D4.1 (K), J4.2 (Ext), R63.2, R67.2, R68.2, U6.32 (RFGND), U6.33 (EGP), Y2.2 (G), Y2.4 (G); also elsewhere on the board
SPI_MISO: U6.4 (DIO12_SPI0POCI); also elsewhere on the board
SPI_MOSI: U6.5 (DIO13_SPI0PICO); also elsewhere on the board
SPI_SCLK: U6.2 (DIO8_SPI0SCLK); also elsewhere on the board
SPI_nCS: U6.3 (DIO11_SPI0CSN); also elsewhere on the board
SWDCK: U6.9 (DIO17_SWDCK); also elsewhere on the board
SWDIO: U6.8 (DIO16_SWDIO); also elsewhere on the board
TCAN_GPIO1: U6.18 (DIO1_A4); also elsewhere on the board
TCAN_GPO2: U6.23 (DIO5_A2); also elsewhere on the board
TCAN_RST: U6.10 (DIO18); also elsewhere on the board
TCAN_nINT: U6.7 (DIO14); also elsewhere on the board
TCAN_nWKRQ: U6.11 (DIO19); also elsewhere on the board
VIN_PROT: R62.1; also elsewhere on the board
nRESET: C58.1, R60.2, U6.19 (RSTN); also elsewhere on the board

Notes on the sheet:
CC2340R5-Q1 core, supplies, clocks, SPI/GPIO
RF design intent (SWRA834A, SWRU120D): ANT(pin31) -> LC low-pass -> series C -> pi-match (ANT1/2/3) -> 50R microstrip -> IFA feed. IFA at board edge, no copper/parts in keepout, plastic enclosure. ALL RF values = starting points, TUNE ON VNA.
RF chain

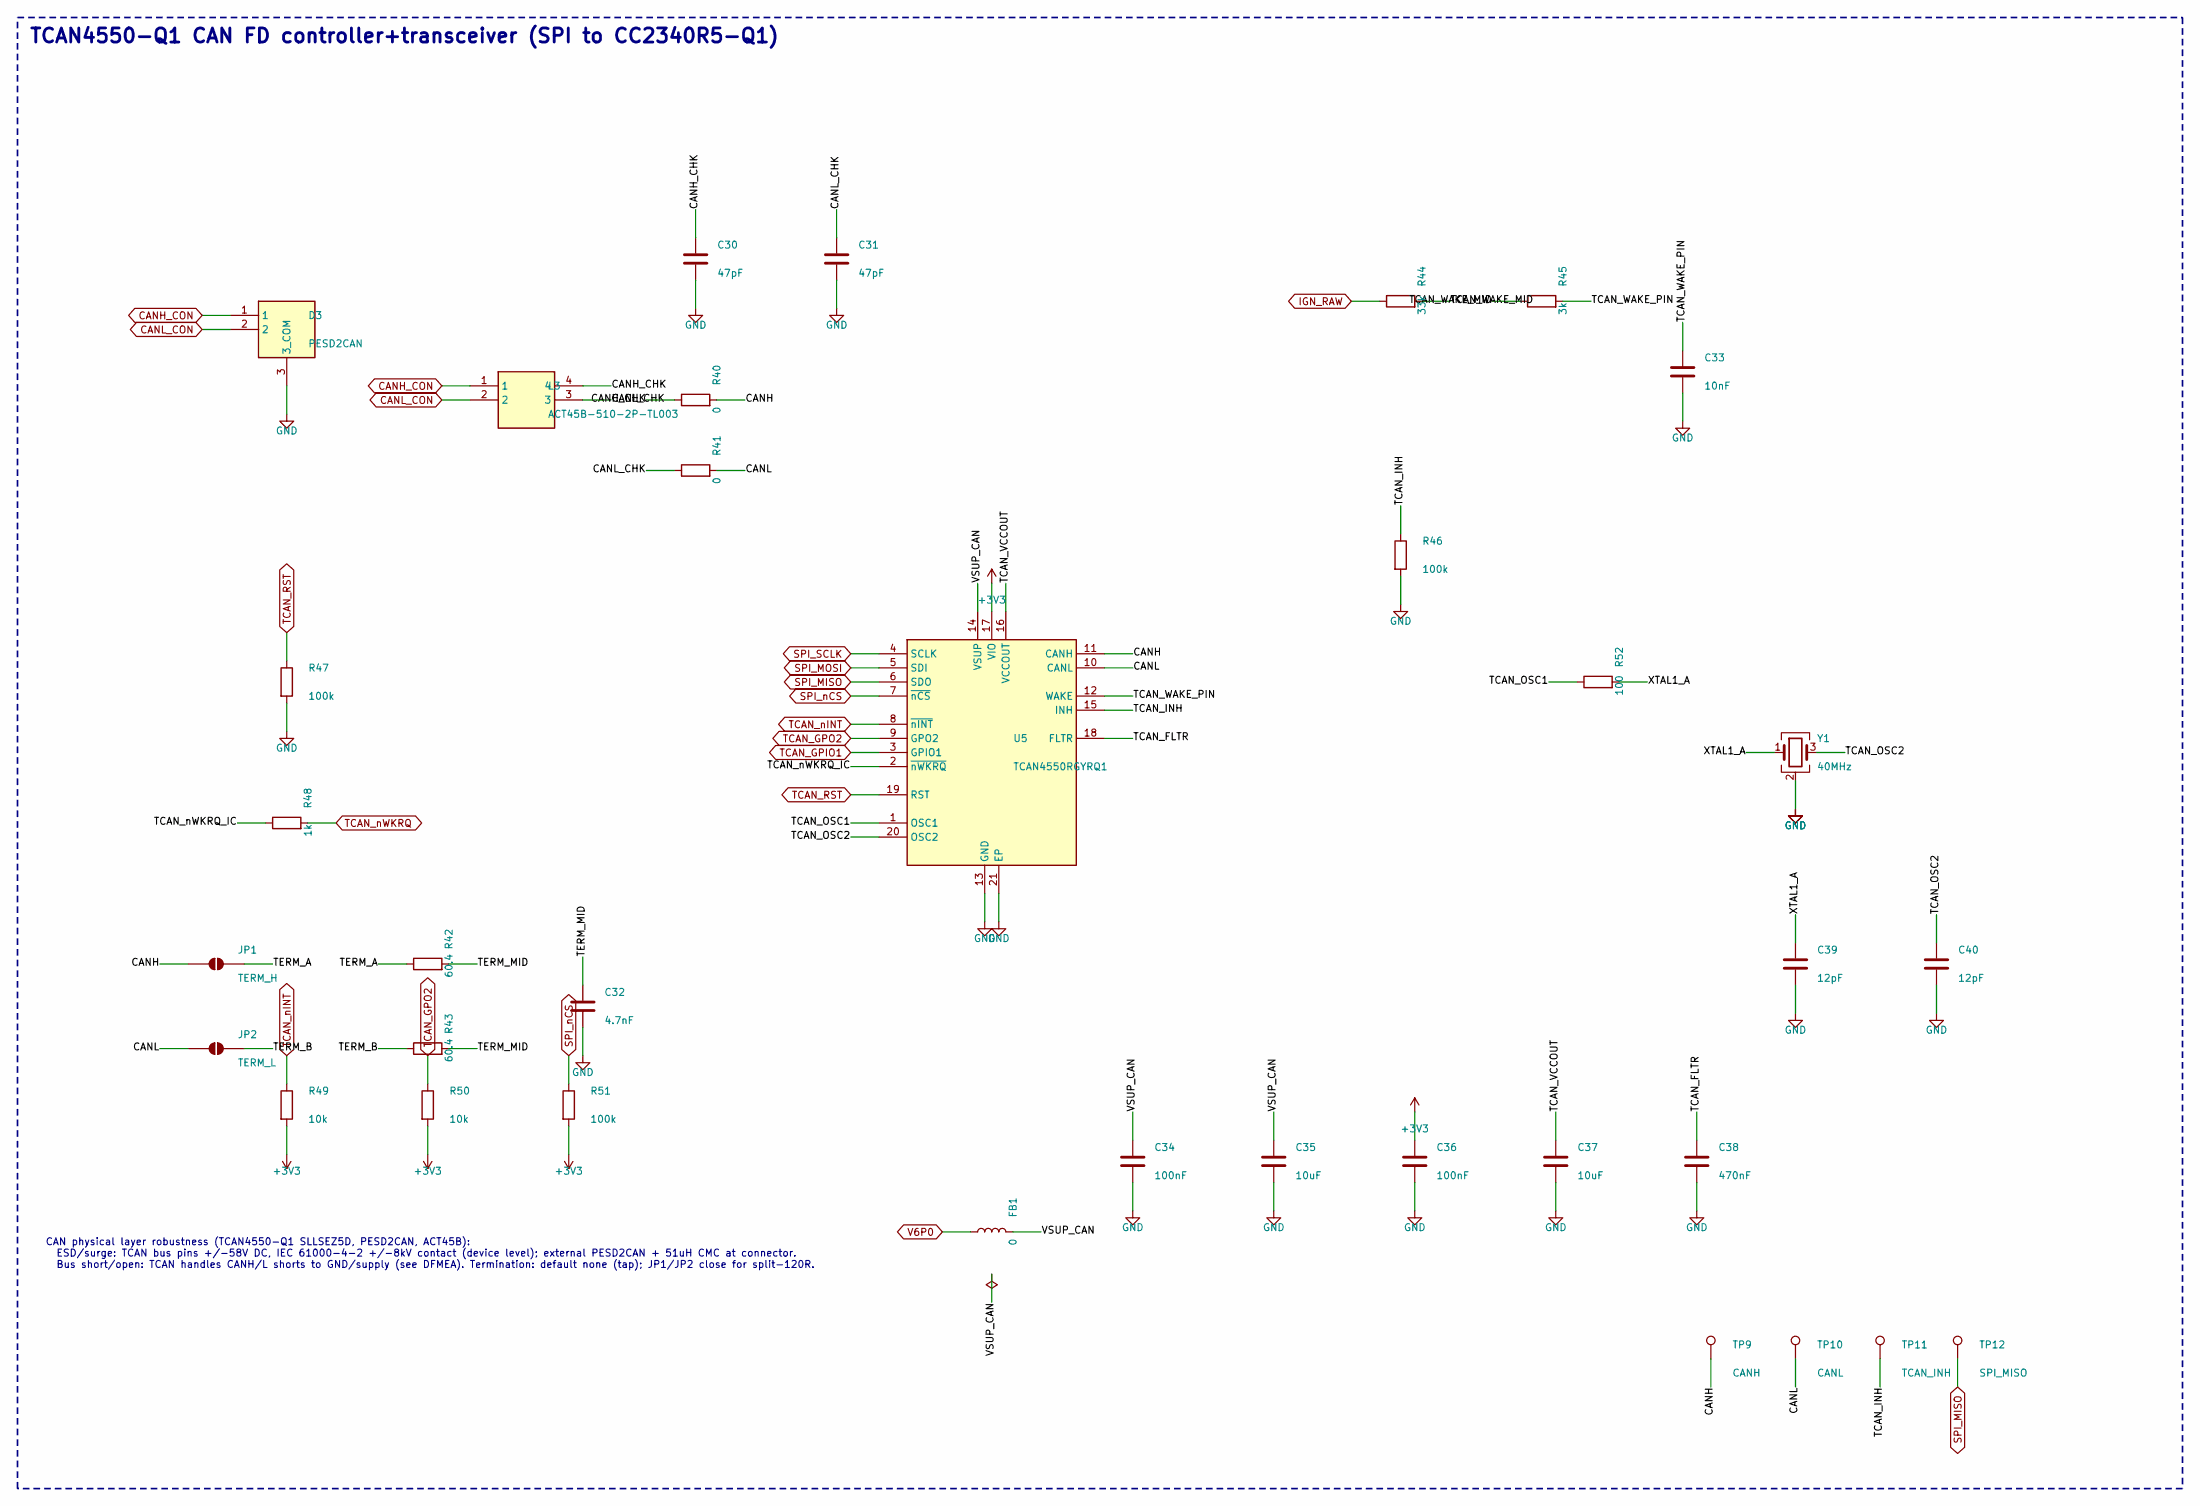
[picture p40: schematic can_fd.kicad_sch, 4 - CAN FD interface: TCAN4550-Q1, bus protection, split te…]

Parts:
C30, C31: 47pF; C_0603_1608Metric; Rating 100V C0G; MPN GCM-series (AEC-Q200) 47pF 100V C0G
C32: 4.7nF; C_0603_1608Metric; Rating 100V C0G/X7R; MPN GCM-series (AEC-Q200) 4.7nF 100V C0G/X7R
C33: 10nF; C_0603_1608Metric; Rating 50V X7R; MPN GCM-series (AEC-Q200) 10nF 50V X7R
C34: 100nF; C_0603_1608Metric; Rating 50V X7R; MPN GCM-series (AEC-Q200) 100nF 50V X7R
C35, C37: 10uF; C_0805_2012Metric; Rating 16V X7R; MPN GCM-series (AEC-Q200) 10uF 16V X7R
C36: 100nF; C_0402_1005Metric; Rating 16V X7R; MPN GCM-series (AEC-Q200) 100nF 16V X7R
C38: 470nF; C_0603_1608Metric; Rating 16V X7R; MPN GCM-series (AEC-Q200) 470nF 16V X7R
C39, C40: 12pF; C_0402_1005Metric; Rating 50V C0G; MPN GCM-series (AEC-Q200) 12pF 50V C0G
D3: PESD2CAN; SOT-23; Rating VRWM 24V, Vcl 41V @5A, 30kV ESD, AEC-Q1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; MPN PESD2CAN,215
FB1: 0; L_0603_1608Metric; MPN BLM18PG221SN1D
JP1: TERM_H; SolderJumper-2_P1.3mm_Open_RoundedPad1.0x1.5mm; Rating closed by solder blob; MPN solder jumper (open)
JP2: TERM_L; SolderJumper-2_P1.3mm_Open_RoundedPad1.0x1.5mm; Rating closed by solder blob; MPN solder jumper (open)
L3: ACT45B-510-2P-TL003; CMC_TDK_ACT45B_EIA1812; Rating 51uH, 50VDC, 200mA, AEC-Q200, -40..150C; MPN ACT45B-510-2P-TL003
R40, R41: 0; R_0603_1608Metric; Rating 1%, AEC-Q200 thick film; MPN AC0603FR-070RL
R42, R43: 60.4; R_0805_2012Metric; Rating 0.25W 1% AEC-Q200; MPN AC0805FR-0760R4L
R44: 33k; R_0603_1608Metric; Rating 1%, AEC-Q200 thick film; MPN AC0603FR-0733KL
R45: 3k; R_0603_1608Metric; Rating 1%, AEC-Q200 thick film; MPN AC0603FR-073KL
R46, R47, R51: 100k; R_0402_1005Metric; Rating 1%, AEC-Q200 thick film; MPN AC0402FR-07100KL
R48: 1k; R_0402_1005Metric; Rating 1%, AEC-Q200 thick film; MPN AC0402FR-071KL
R49, R50: 10k; R_0402_1005Metric; Rating 1%, AEC-Q200 thick film; MPN AC0402FR-0710KL
R52: 100; R_0402_1005Metric; Rating 1%, AEC-Q200 thick film; MPN AC0402FR-07100RL
TP9: CANH; TestPoint_Pad_D1.5mm; Rating bare copper pad; MPN PCB test pad D1.5mm
TP10: CANL; TestPoint_Pad_D1.5mm; Rating bare copper pad; MPN PCB test pad D1.5mm
TP11: TCAN_INH; TestPoint_Pad_D1.5mm; Rating bare copper pad; MPN PCB test pad D1.5mm
TP12: SPI_MISO; TestPoint_Pad_D1.5mm; Rating bare copper pad; MPN PCB test pad D1.5mm
U5: TCAN4550RGYRQ1; Texas_RGY_R-PVQFN-N20_EP2.05x3.05mm; Rating VSUP 5.5-30V (42V abs), VIO 3.135-5.25V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; MPN TCAN4550RGYRQ1
Y1: 40MHz; Crystal_SMD_3225-4Pin_3.2x2.5mm; Rating 40MHz, CL~8pF, ESR<=60R (TCAN spec), +/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; MPN NX3225GD-40.000M-xxx (order code TBC)

Connections:
+3V3: C36.1, R49.2, R50.2, R51.2, U5.17 (VIO); also elsewhere on the board
/4_CAN_FD/CANH: JP1.1 (A), R40.2, TP9.1, U5.11 (CANH)
/4_CAN_FD/CANH_CHK: C30.1, L3.4, R40.1
/4_CAN_FD/CANL: JP2.1 (A), R41.2, TP10.1, U5.10 (CANL)
/4_CAN_FD/CANL_CHK: C31.1, L3.3, R41.1
/4_CAN_FD/TCAN_FLTR: C38.1, U5.18 (FLTR)
/4_CAN_FD/TCAN_INH: R46.1, TP11.1, U5.15 (INH)
/4_CAN_FD/TCAN_OSC1: R52.1, U5.1 (OSC1)
/4_CAN_FD/TCAN_OSC2: C40.1, U5.20 (OSC2), Y1.3
/4_CAN_FD/TCAN_VCCOUT: C37.1, U5.16 (VCCOUT)
/4_CAN_FD/TCAN_WAKE_MID: R44.2, R45.1
/4_CAN_FD/TCAN_WAKE_PIN: C33.1, R45.2, U5.12 (WAKE)
/4_CAN_FD/TCAN_nWKRQ_IC: R48.1, U5.2 (~nWKRQ)
/4_CAN_FD/TERM_A: JP1.2 (B), R42.1
/4_CAN_FD/TERM_B: JP2.2 (B), R43.1
/4_CAN_FD/TERM_MID: C32.1, R42.2, R43.2
/4_CAN_FD/VSUP_CAN: C34.1, C35.1, FB1.2, U5.14 (VSUP)
/4_CAN_FD/XTAL1_A: C39.1, R52.2, Y1.1
CANH_CON: D3.1, L3.1; also elsewhere on the board
CANL_CON: D3.2, L3.2; also elsewhere on the board
GND: C30.2, C31.2, C32.2, C33.2, C34.2, C35.2, C36.2, C37.2, C38.2, C39.2, C40.2, D3.3 (3_COM), R46.2, R47.2, U5.13 (GND), U5.21 (EP), Y1.2 (G), Y1.4 (G); also elsewhere on the board
IGN_RAW: R44.1; also elsewhere on the board
SPI_MISO: TP12.1, U5.6 (SDO); also elsewhere on the board
SPI_MOSI: U5.5 (SDI); also elsewhere on the board
SPI_SCLK: U5.4 (SCLK); also elsewhere on the board
SPI_nCS: R51.1, U5.7 (~nCS); also elsewhere on the board
TCAN_GPIO1: U5.3 (GPIO1); also elsewhere on the board
TCAN_GPO2: R50.1, U5.9 (GPO2); also elsewhere on the board
TCAN_RST: R47.1, U5.19 (RST); also elsewhere on the board
TCAN_nINT: R49.1, U5.8 (~nINT); also elsewhere on the board
TCAN_nWKRQ: R48.2; also elsewhere on the board
V6P0: FB1.1; also elsewhere on the board

Notes on the sheet:
CAN physical layer robustness (TCAN4550-Q1 SLLSEZ5D, PESD2CAN, ACT45B): ESD/surge: TCAN bus pins +/-58V DC, IEC 61000-4-2 +/-8kV contact (device level); external PESD2CAN + 51uH CMC at connector. Bus short/open: TCAN handles CANH/L shorts to GND/supply (see DFMEA). Termination: default none (tap); 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
TCAN4550-Q1 CAN FD controller+transceiver (SPI to CC2340R5-Q1)

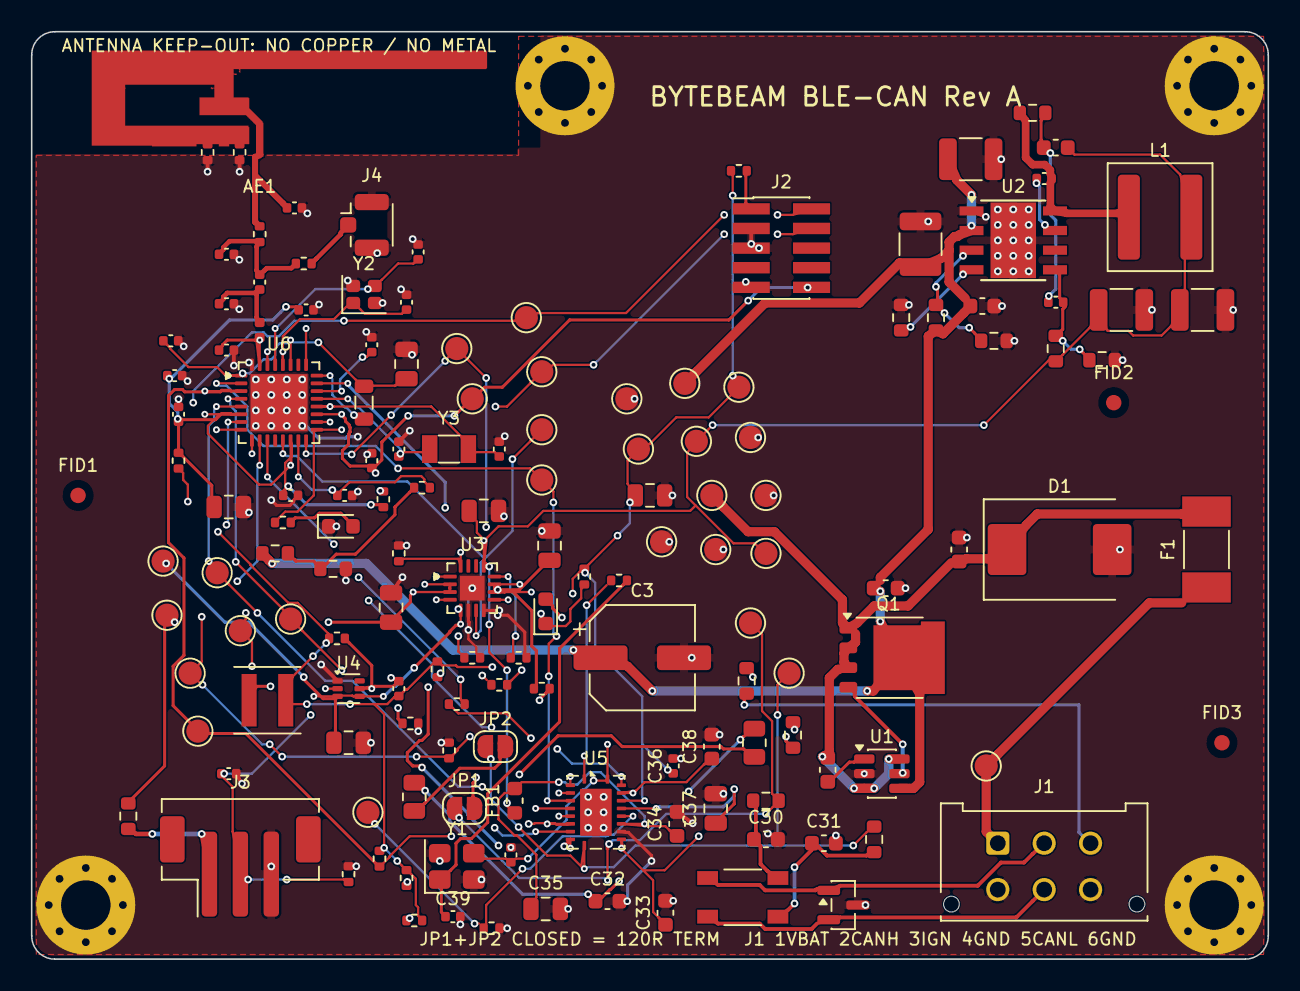
[picture p41: board bytebeam_ble_can.kicad_pcb from above]

Board: 4 copper layers, 80.0 x 60.0 mm, 153 parts (0 on the bottom side), 76 nets.
